Manas-36/MINESAFE/docs/report/README.md

# Reports

| File | What |
|---|---|
| [MineSafe_Blue_Book.pdf](MineSafe_Blue_Book.pdf) · [.docx](MineSafe_Blue_Book.docx) | Project Report Part I (TCET blue-book format), written early Oct 2026 — describes the system as it was then (V3 with the camera entry station); later changes are in the [CHANGELOG](../../CHANGELOG.md) |
| [figures/](figures/) | Diagrams and screenshots used in the report: architecture, DFD level 0 / 1, use case, state diagram, process model, Gantt chart, flowcharts, alert sequence, schematics |

The presentation was made in Claude Slides (export PDF / PPTX from its Share menu) — see [../presentation](../presentation/README.md).
