Manas-36/MINESAFE/docs/presentation/README.md

# Presentation

22-slide deck (12–15 minutes) made in Claude Slides — export it as PDF / PPTX from the deck's Share menu and add the file here.

| # | Slide | Section |
|---|---|---|
| 1 | MineSafe — title | |
| 2 | Underground, a miner is out of sight, out of reach and unchecked | Problem |
| 3 | Why the mine needs this system | Need & justification |
| 4 | Today's tools each solve one piece | Existing gap |
| 5 | Check at the gate. Watch underground. Warn instantly. | Our solution |
| 6 | System architecture | Overview |
| 7 | A worker's shift, step by step | Process flow |
| 8 | A working demo for about ₹6,700 | BOM |
| 9 | What the miner wears | Technical |
| 10 | Wiring: one I2C bus plus four single pins | Technical |
| 11 | A radio chain that builds itself | Technical |
| 12 | One 54-byte packet per second per worker | Technical |
| 13 | Steps, turns and check-points put the dot on the map | Technical |
| 14 | How danger is recognised | Technical |
| 15 | Two independent checks before anyone goes down | Technical |
| 16 | Every worker, live on the tunnel map | Software |
| 17 | Gas per node, health card per worker | Software |
| 18 | What is new in MineSafe | Innovation |
| 19 | Who benefits, and how | Usefulness |
| 20 | Knowing when kit comes off underground | Extension |
| 21 | Where MineSafe goes next | Future scope |
| 22 | Thank you — questions and live demo | |

**v3.1 update (4 Oct 2026):** AHT air sensor added — slide 6 (hub box), 8 (BOM: AHT20 ₹120 per repeater, total ≈ ₹6,730), 11 (repeater bullet + wiring line), 14 (Gas + air card, wet-bulb limits), 16 (Gas & air tab).
