Manas-36/MINESAFE/presentation/avishkar/poster/MineSafe_Avishkar_Poster.pptx

Inter-University Avishkar Research Convention: 2026-27

Category: Engineering & Technology

MineSafe

Intelligent Safety Gear Compliance, Health Monitoring and Navigation System for Underground Miners

METHODOLOGY — ARCHITECTURE AND DATA FLOW

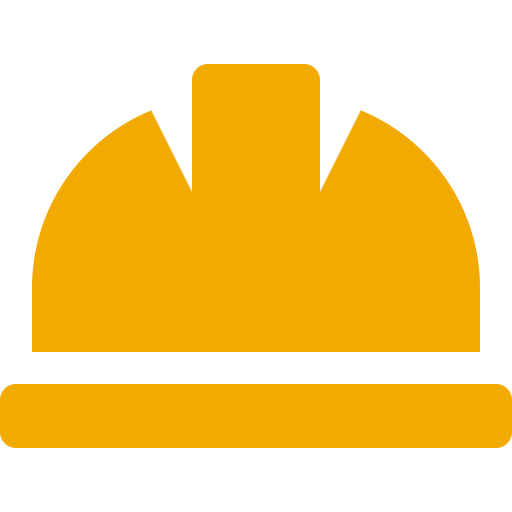
[picture p52: figure]

Level: UG

Slot No.: ____________

No GPS

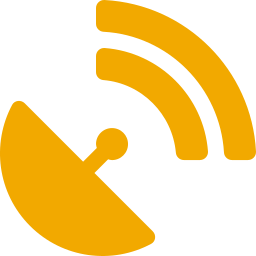
[picture p53: figure]

No internet

No new cabling

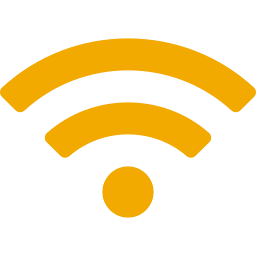
[picture p54: figure]
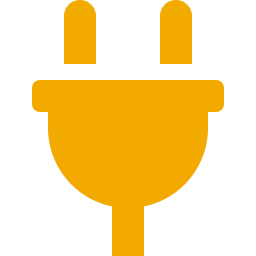
[picture p55: figure]

THE PROBLEM

In every rescue: nobody knows who is underground, where, or whether they are alive.

01

141

deaths, 2023–25

355

serious accidents

OBJECTIVES

Kit compliance

RFID / ID card + YOLOv8 photo check at the gate

Health

heart rate, SpO₂, temperature, falls, no-movement

GPS-free location

steps + heading, corrected at every repeater

Self-healing network

hop-by-hop ESP-NOW, no cabling or internet

Gas and heat

CH₄, CO, H₂S, wet-bulb at every repeater

Low cost

< ₹7,000 / repeater · ≈ ₹12,800 / suit

02

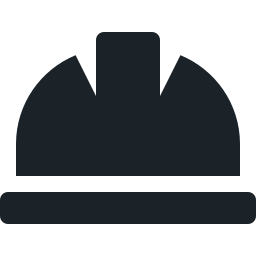
[picture p56: figure]
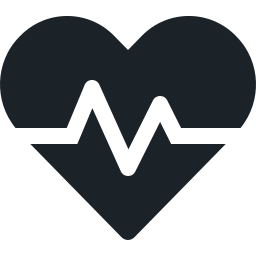
[picture p57: figure]

RESEARCH GAP

System | Kit | Vitals | Fall | Location | Gas | Price
MineGuard 360 | ✗ | ✓ | ~ | ~ | ✓ | quote
MineARC GuardIAN | ✗ | ✗ | ~ | zone | ✓ | quote
Leantegra UWB | ✗ | ✗ | ✗ | ✓ | ✓ | quote
Rajant Health | tag | ✓ | ✓ | ~ | ~ | quote
SmartKavach | ✗ | ~ | ✓ | ✗ | ✗ | quote
36Zero + Bodytrak | ~ | ✓ | ✓ | ✗ | ✗ | quote
MineSafe | ✓ | ✓ | ✓ | ✓ | ✓ | ₹12.8k

Novelty: the first low-cost system that combines kit check, vitals and GPS-free location in one self-healing network.

03

0

GPS or phone signal below ground

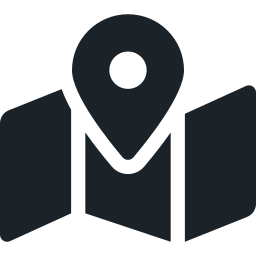
[picture p58: figure]
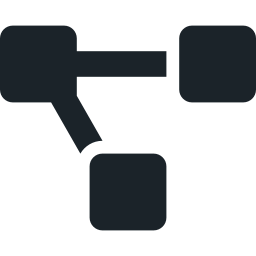
[picture p59: figure]
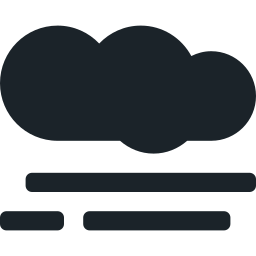
[picture p60: figure]

alerts and evacuation routes return down the same chain · 1 packet / s per worker · data stays on site, no cloud

04

ESP-NOW

ESP-NOW

ESP-NOW

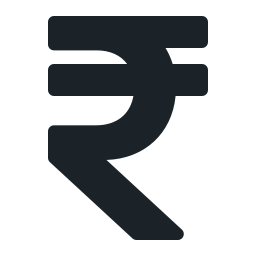
[picture p61: figure]

Wi-Fi

Wi-Fi

V4 SMART SUIT

Never locked: removal is detected, never prevented

05

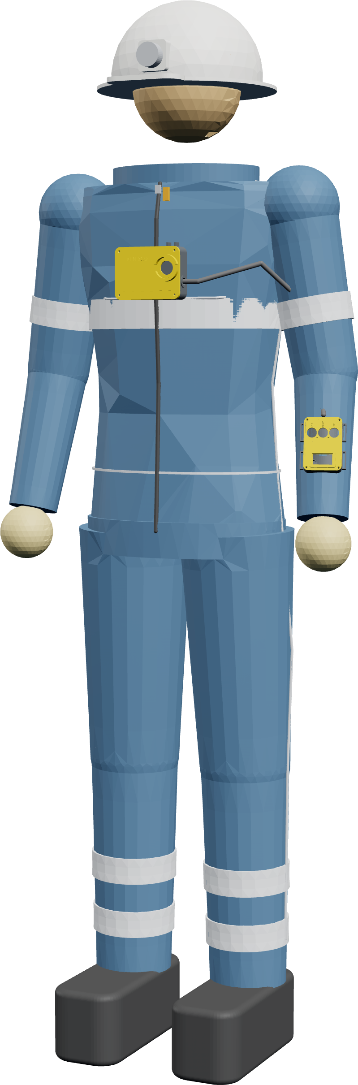
[picture p62: figure]
Smart suit 3D render

Smart suit

4 pods: vitals, fall, kit, steps

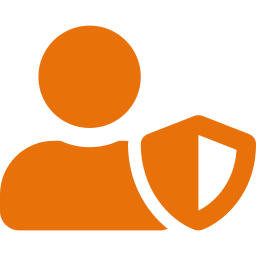
[picture p63: figure]

REP-03

gas · air · exit sign

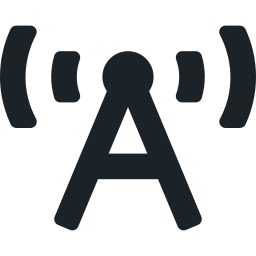
[picture p64: figure]

REP-02

gas · air · exit sign

REP-01

main repeater

Hub laptop

API · AI kit check · evacuation planner

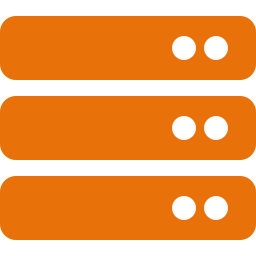
[picture p65: figure]

3D control app

browser or phone, live

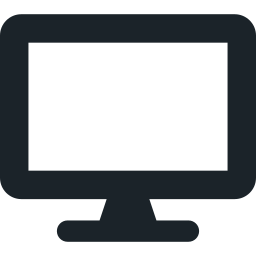
[picture p66: figure]

Helmet pod

antenna at head height, voice alerts, helmet-on switch

Zip + seams

reed switch, conductive thread: opened or torn = alert

Core pod · chest

ESP32-C6, 3000 mAh, IMU + pressure, SOS

Kit up

suit self-checks

WORKER'S SHIFT

no → rejected, fix kit

Entry check

ID card + YOLOv8 photo

Kit OK?

yes

Underground

vitals · steps · gas, every 1 s

Alarm?

yes

Alert + route

exit signs, cuff, helmet voice

Exit scan

dock charges

Boot pod

foot IMU measures every real stride

Wrist cuff

screen, 3 glove buttons, vibration, HR + SpO₂

Reflective bands

hi-vis in cap-lamp light

LOCATION WITHOUT GPS

06

1

Count steps

Evacuation in the 3D control app

no → keep monitoring

07

LED exit sign

REPEATER: BUILT FOR THE MINE

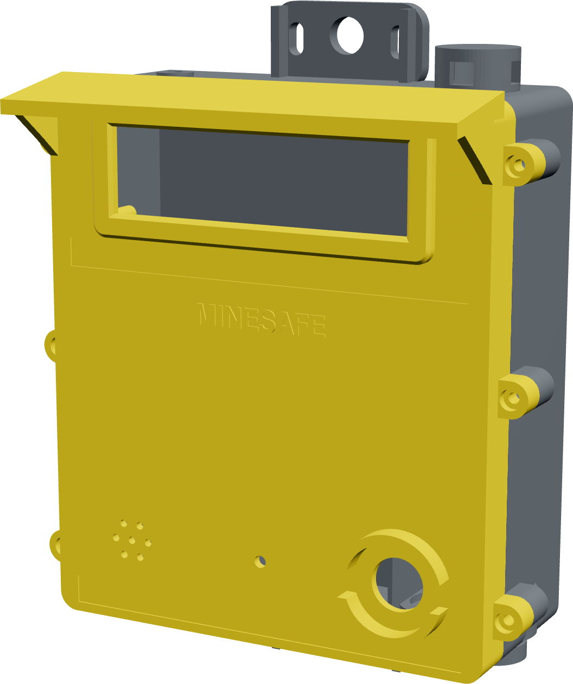
[picture p67: figure]
Repeater enclosure 3D render

CH₄ port on top

08

Mine 9–30 V

ELECTRICAL DESIGN AND PCBS

Diode OR

Fuse + TVS

5 V buck

XIAO · 3 MQ · matrix

2

3

stride × gyro heading; pressure gives the level

Snap to tunnel

position pulled onto the mine-map centre line

Reset at repeater

signal ≥ −55 dBm → drift back to zero

arrow + metres, under a drip hood

85 dB buzzer

works if the hub is down

CO / H₂S below

methane rises; rain chimney

IP65 gasket

silicone cord, 6 × M4

Guarded SOS

Battery 12 V

Repeater PCB

no reset

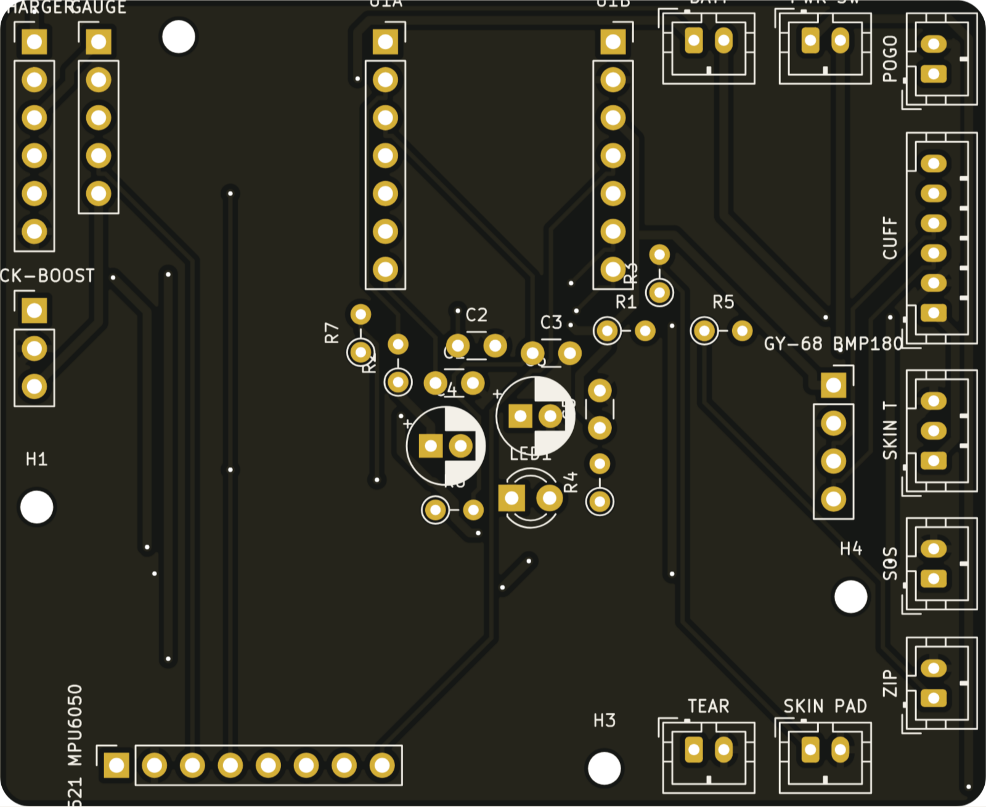
[picture p68: figure]
Core PCB

1.6 A · 36 V

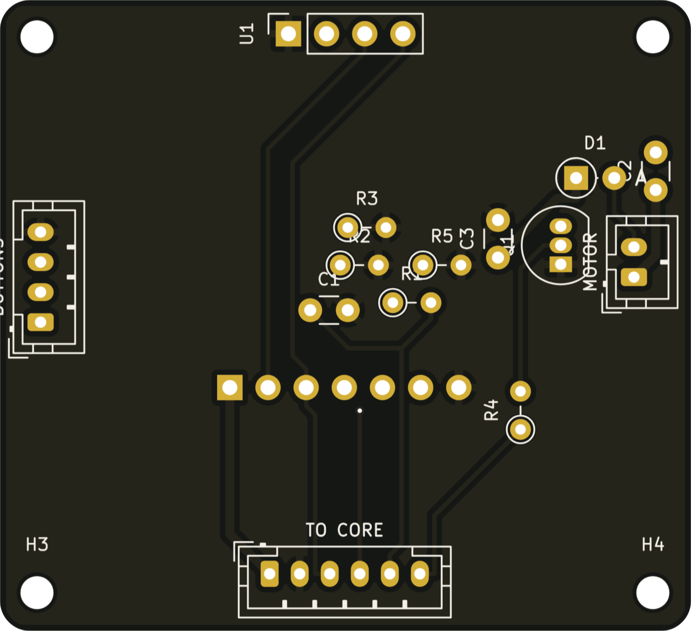
[picture p69: figure]
Cuff PCB

2 A, 90 %

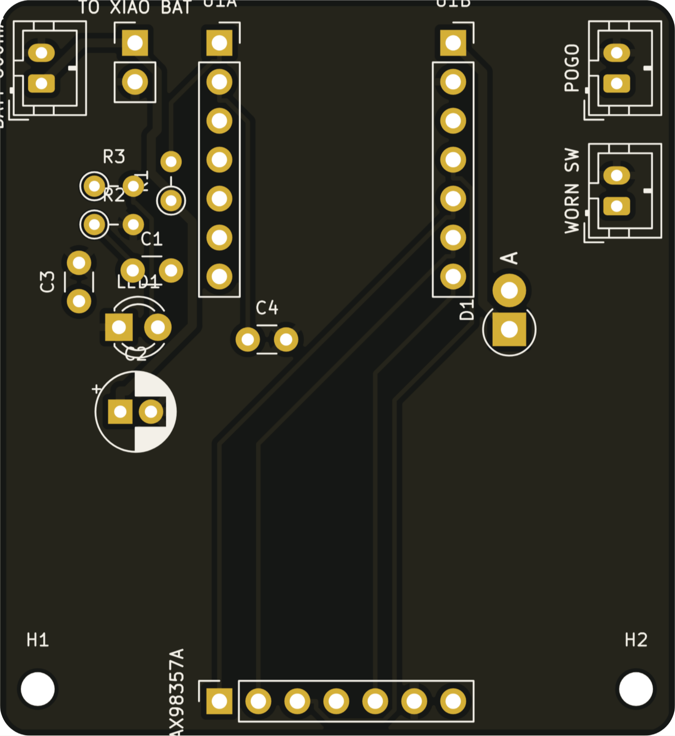
[picture p70: figure]
Helmet PCB

≈ 3.7 W

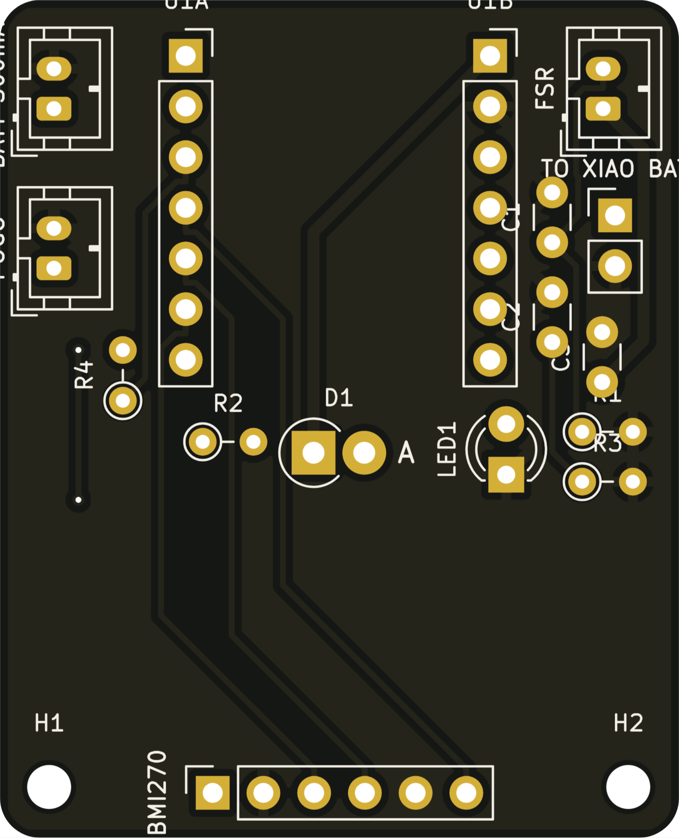
[picture p71: figure]
Boot PCB

09

4

Route around danger

Dijkstra from all exits, hazard zone ×1000 cost

ENERGY BUDGET

Live 3D control app: routes bend around a gas leak, every exit sign updates

10

COST

heavier gases; flame arrestors

11

VALIDATION

glove-sized, knock-proof

Repeater

5 own 2-layer boards · KiCad + Freerouting · 100 % routed · 0 unconnected pads

Core

Cuff

12

Every worker checked, monitored, located and reachable for the whole shift, on hardware a small mine can install itself.

CONCLUSION

Helmet

Boot

₹12.8k
per suit

Boot pod

Fabric + sensing

Core pod

Helmet pod

Wrist cuff

3,270

3,040

2,790

2,260

1,480

Test | Pass criterion | Status
PCB DRC, 5 boards | 0 unconnected pads | Passed
CAD fit, 5 cases | no collisions | Passed
Power budget | core pod ≥ 12 h (21 h) | Passed
Repeater chain | self-forms, 3 / 3 | Passed
Gas + local buzzer | alarm at limit | Passed
Distance error | ≤ 5 % over 100 m | In progress
Alert latency | ≤ 3 s for 95 % | Planned
Fall detection | ≥ 90 %, ≤ 1 false / h | Planned

- Working V3 prototype: 3 repeaters, body unit, hub, 3D app
- V4: 5 PCBs, 5 mine-rated cases, smart suit
- Next: LoRa backbone, certified gas sensors, mine trial

References [1] Ministry of Mines data, ETV Bharat, Aug 2026 · [2] Coal Mines Regulations 2017, reg. 153 · [3] NIOSH Pocket Guide to Chemical Hazards · [4] Bandyopadhyay et al., Wireless Information and Safety System for Mines, JSIR 2009 · [5] IMU-assisted UWB positioning in underground coal mines, Micromachines 2023 · [6] Real-time PPE compliance detection (YOLO), Sustainability 2023

Hours on one charge; a shift is 12 h. *duty-cycled radio. Repeater ≈ 3.7 W on mine power.

₹6,862 / repeater · ₹3.26 L for 10 repeaters + 20 suits

SDG 3
Good health

SDG 8
Decent work

SDG 9
Industry
