Manas-36/MINESAFE/presentation/avishkar/MineSafe_Avishkar.pptx

MineSafe

Intelligent Safety Gear Compliance, Health Monitoring and Navigation System for Underground Miners

Checked at the gate · monitored all shift · located without GPS · reachable in seconds


No GPS


No internet


No new cabling


Notes: 0:00–0:15. Say the slot number only — never your name or college. The suit on the right is a live 3D model: click and drag to turn it.

## Underground, nobody knows who is where — or if they are alive

141

deaths, 2023–25

SLBC tunnel, Telangana · 2025

8 trapped — ground radar needed to find them

Umrangso, Assam · 2025

flooded mine, 150+ hour search

355

serious accidents

Kolihan, Rajasthan · 2024

cage rope snapped, 15 trapped, 1 died

0

GPS or phone signal underground

Ksan, Meghalaya · 2018

15 trapped, about 80-day search

Notes: 0:15–0:45. Source: Ministry of Mines data (ETV Bharat, Aug 2026). Every rescue shows the same gap: no last known position, no vitals, no way to tell each worker which way to go.

## No existing system combines kit check, vitals and GPS-free location

Product | Kit check | Vitals | Fall alert | GPS-free location | Gas | Public price
Teknovate MineGuard 360 | ✗ | ✓ | ~ | ~ | ✓ | quote only
MineARC GuardIAN | ✗ | ✗ | ~ | zone | ✓ | quote only
Leantegra (UWB) | ✗ | ✗ | ✗ | ✓ | ✓ | quote only
Rajant Health | tag | ✓ | ✓ | ~ | ~ | quote only
EasyM2M SmartKavach | ✗ | ~ | ✓ | ✗ | ✗ | quote only
36Zero + Bodytrak | ~ | ✓ | ✓ | ✗ | ✗ | quote only
MineSafe | ✓ | ✓ | ✓ | ✓ | ✓ | ₹6.9k / ₹12.8k

What is new: one integrated network · location without GPS or new infrastructure · repeaters that are also exit signs · a suit that checks the kit all shift · small-mine price

Notes: 0:45–1:10. Nine commercial products checked (July 2026). Do not claim to beat Leantegra on positioning — the point is the integration and the cost.

## Methodology: one self-healing network from the gate to the control room

ESP-NOW

ESP-NOW

ESP-NOW

Wi-Fi

Wi-Fi

Smart suit

4 pods: vitals, fall, kit, steps


REP-03

gas · air · exit sign


REP-02

gas · air · exit sign

REP-01

main repeater

Hub laptop

API · AI kit check · evacuation planner


3D control app

browser or phone


WORKER'S SHIFT

alerts and evacuation routes return down the same chain · data stays on site

Kit up

suit self-checks

Entry check

ID card + YOLOv8 photo

Kit OK?

yes

Underground

vitals · steps · gas, 1 / s

Alarm?

yes

Alert + route

exit signs, cuff, voice

Exit scan

dock charges

no → rejected, fix kit

no → keep monitoring

Notes: 1:10–1:45. Top: data flow left to right, alerts come back on the dashed path. Bottom: the worker's shift — the system runs on its own after the gate.

## Location without GPS, evacuation without guesswork

3D control room during an evacuation

Live 3D control app during an evacuation: routes go around the gas leak, exit signs update

Count steps

steps × stride along the gyro heading; pressure gives the level

1

2

Snap to the tunnel

position pulled onto the nearest tunnel on the mine map

3

Reset at repeaters

signal ≥ −55 dBm = next to that repeater: drift goes to zero

4

Route around danger

Dijkstra from all exits; hazard tunnels cost 1000×; each exit sign shows arrow + metres

Notes: 1:45–2:10. Integrating acceleration drifts about 175 m a minute — that is why we count steps and reset at every repeater. V4 adds a foot IMU that measures each real stride.

## Design considerations: dust, water, methane, heat and blasting

Water and dust

IP65 gasket, drip hood, every opening faces down

Methane rises

CH₄ port on top under a rain chimney; H₂S / CO at the bottom

Ignition risk

sintered flame-arrestor seat at every gas port

Heat 30–45 °C

air sensor in its own chamber, away from heaters

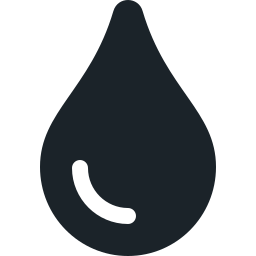
[picture p103: figure]
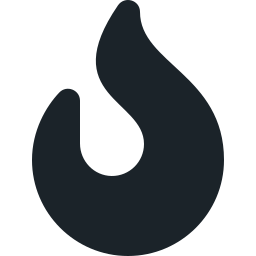
[picture p104: figure]
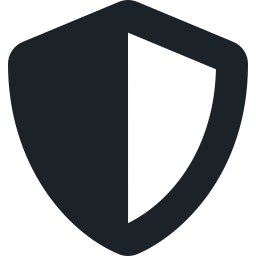
[picture p105: figure]
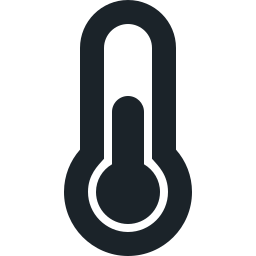
[picture p106: figure]

Blasting shock

screw bosses, latching connectors, rubber grommets

Power cuts

mine supply + battery, switch-over with no reset

Dark and smoke

LED exit signs, reflective hi-vis tape

Thick gloves

16–22 mm buttons, vibration and voice alerts

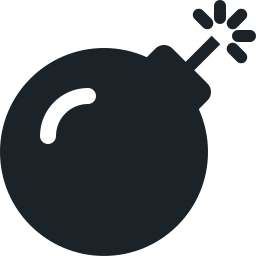
[picture p107: figure]
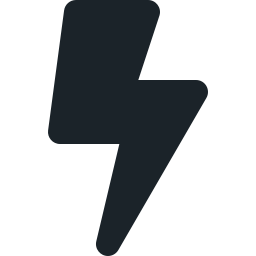
[picture p108: figure]
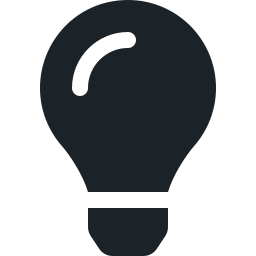
[picture p109: figure]
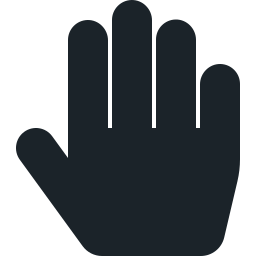
[picture p110: figure]

Notes: 2:10–2:30. Every hardware decision starts from a mine condition. The suit is never locked — removal is detected, never prevented.

## Each repeater is a radio relay, gas station and exit sign

MQ-4 CH₄ (top) · MQ-7 CO · MQ-136 H₂S (bottom), Indian limits

3D model — click and drag to turn it

3D model: Repeater Case - drag to rotate

Gas

temperature, humidity, wet-bulb limit 30.5 / 33.5 °C

Air

8×32 LED matrix: arrow + distance to the safe exit

Exit sign

85 dB buzzer works even if the control room is down

Alarm

9–30 V mine supply or battery, ≈ 3.7 W, ≈ 7 h backup

Power

223 × 292 × 118 mm, IP65 target, rock-bolt / chain mount

Case

Notes: 2:30–3:00. Turn the 3D model to show the CH4 chimney on top and the downward-facing ports. The same board runs as main repeater or tunnel repeater.

## Electrical design: five own PCBs, 100 % routed, 0 errors

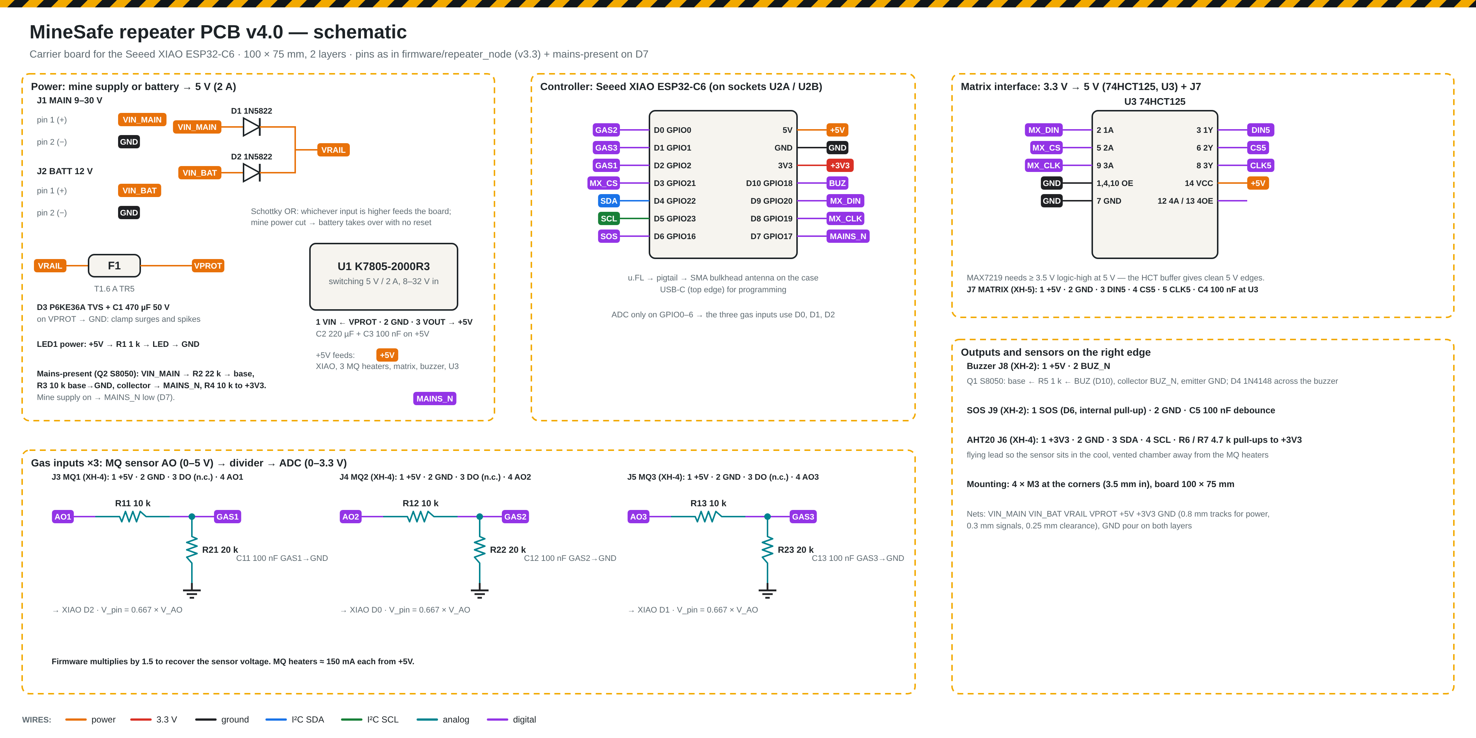
[picture p111: figure]
Repeater PCB schematic

Repeater schematic and board, 100 × 75 mm, 2 layers, through-hole

Repeater PCB top render

KiCad 7 + Freerouting, generated by our own script

Mine 9–30 V

Diode OR

no reset on power cut

Fuse + TVS

1.6 A · 36 V

5 V switcher

2 A, ≈ 90 %

XIAO · 3 MQ · matrix

≈ 3.7 W total

Battery 12 V

Notes: 3:00–3:25. Point at the power path: mine supply and battery are OR-ed by diodes, so a power cut never resets the repeater.

## V4 smart suit: the kit checks itself all shift

Core pod · chest

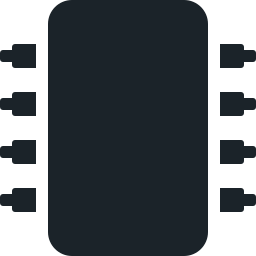
[picture p112: figure]

ESP32-C6, 3000 mAh, motion + pressure, guarded SOS


Helmet pod

antenna at head height, voice alerts, helmet-on switch

Wrist cuff

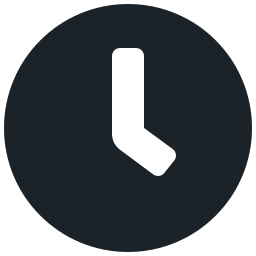
[picture p113: figure]

screen, 3 glove buttons, vibration, heart rate + SpO₂

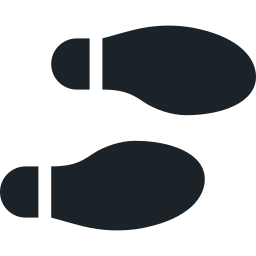
[picture p114: figure]

Boot pod

foot IMU measures each real stride, heel force sensor

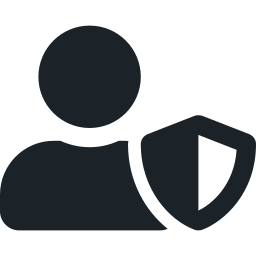
[picture p115: figure]

Seams and zip

Never locked: removal or a tear is detected and reported, never prevented

conductive thread + zip switch: torn or opened = alert

Notes: 3:25–3:50. Turn the suit to show the helmet pod at the back and the boot pod on the right heel. Helmet and boot talk to the core over ESP-NOW; only the cuff is wired.

## Four pods, each designed around its own board

Core pod

118 × 93 × 44 mm · 21 h

Wrist cuff

88 × 75 × 27 mm · wired to core

Helmet pod

75 × 66 × 31 mm · 56 h*

Boot pod

57 × 58 × 29 mm · 92 h*

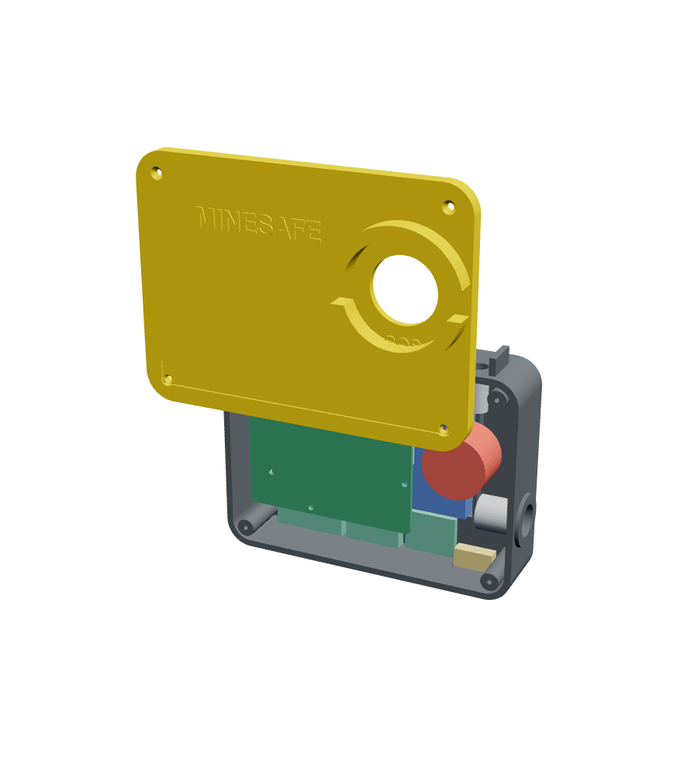
[picture p116: figure]
3D model: Pod Core - drag to rotate
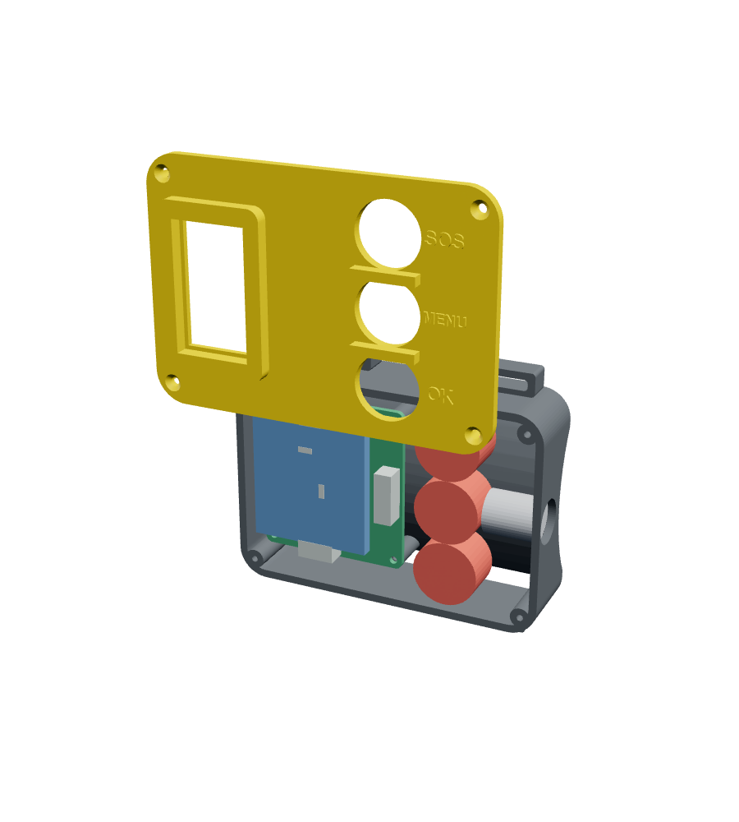
[picture p117: figure]
3D model: Pod Cuff - drag to rotate
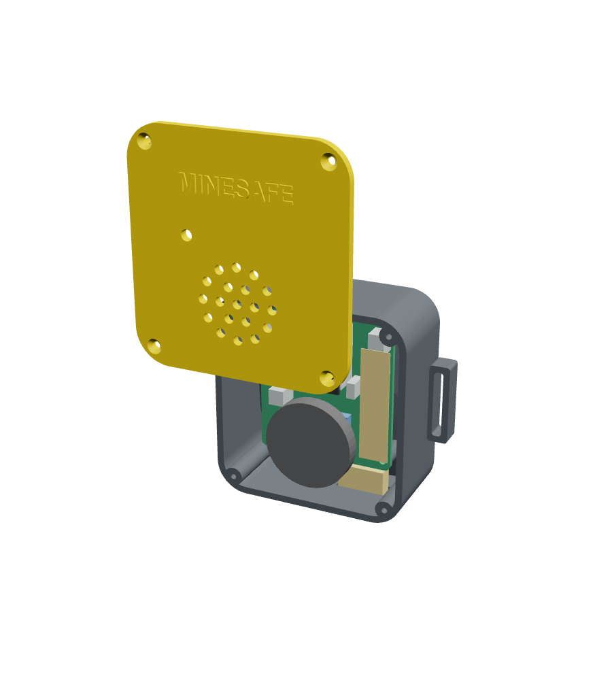
[picture p118: figure]
3D model: Pod Helmet - drag to rotate
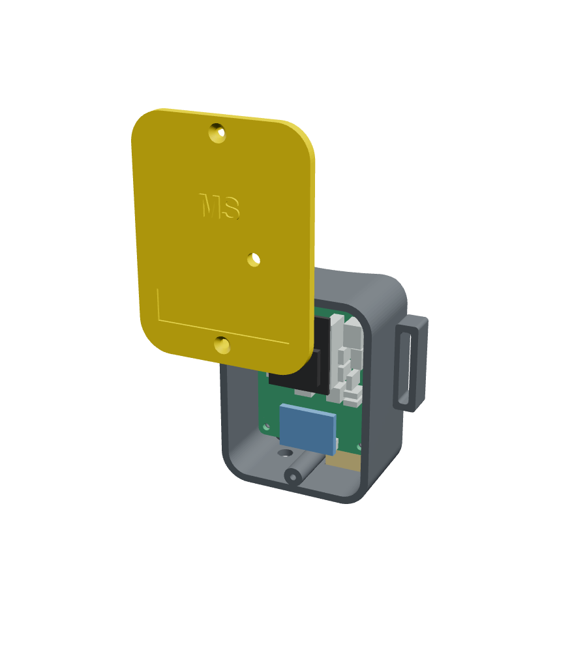
[picture p119: figure]
3D model: Pod Boot - drag to rotate

Lids lifted to show the board, battery and modules · every case fit-checked in CAD against its real KiCad board · *duty-cycled radio

Notes: 3:50–4:05. Turn one pod if time allows. Four pods because each body position does one job best: radio at head height, stride at the foot, screen at the wrist, battery at the chest.

## Energy budget: the core pod lasts almost two shifts

* radio duty-cycled (V4 firmware). Datasheet estimates, to be confirmed by measurement. 10 repeaters ≈ 0.9 kWh / day ≈ ₹7 / day.

Notes: 4:05–4:30. Core pod ≈ 112 mA at 3.3 V → ≈ 21 h from 3000 mAh. Two-thirds of the repeater's power is the gas-sensor heaters — that is why gas is measured on the repeaters, not on the body.

## Component selection: every choice against an alternative

Function | Chosen | Instead of | Why
Controller | XIAO ESP32-C6 | ESP32-S3, Arduino + radio | 21 mm board; Wi-Fi 6, BLE, Zigbee and ESP-NOW on one chip; ≈ ₹600
Worker ↔ repeater link | ESP-NOW | Zigbee, LoRa | no re-joining for a moving worker; no extra hardware
Location | steps + repeater fixes | UWB (DWM3000) | UWB ≈ ₹2,000 per tag and anchor; steps cost nothing
Kit identity | PN532 NFC / ID card | UHF RFID portal | UHF reader ≈ ₹28,000; PN532 a few hundred rupees
Gas (prototype) | MQ-4 / MQ-7 / MQ-136 | electrochemical, NDIR | ₹150–400 each; hub accepts certified sensors later
Regulator | K7805 switcher | linear 7805 | a linear 7805 would waste ≈ 11 W at 24 V input
Exit sign | MAX7219 8×32 matrix | OLED, e-paper | bright in smoke and darkness; ₹250–350

Notes: 4:30–4:55. Five criteria for every part: works underground, low cost, buyable in India, open library, upgradable to a certified part.

## Validation: design and bench checks done, field tests next

design checks passed

4 / 4

bench tests passed

5 / 6

field tests with numeric pass criteria

13

Test | Method | Pass criterion | Status
PCB electrical rules | KiCad DRC, 5 boards | 0 unconnected pads | Passed
Enclosure fit | CAD collision check, 5 cases | no collisions | Passed
Repeater chain | 3 repeaters, any power-up order | forms by itself, 3 / 3 | Passed
Gas + local buzzer | MQ sensor + gas source | alarm at the set limit | Passed
Distance accuracy | 100 m corridor, 5 walkers | error ≤ 5 % | In progress
Alert latency | 3-hop chain, 50 trials | ≤ 3 s for 95 % | Planned
Fall detection | 20 staged falls + 1 h normal | ≥ 90 %, ≤ 1 false / h | Planned
Water / shock | hose 30 min, 1 m drop, 45 °C | no water, no reset | Planned

Notes: 4:55–5:35. Be honest: V3 is in field calibration. Each field test has a numeric pass criterion; results are logged with screenshots and video.

## Affordable for small mines: checked, located, reachable

per repeater

₹6,862

per smart suit

₹12,800

site: 10 repeaters + 20 suits

Every commercial system: enterprise quote only

Next: LoRa backbone · certified gas sensors · intrinsic-safety design · field trial with a mine

₹3.26 L

SDG 3
Good health

SDG 8
Decent work

SDG 9
Industry, innovation

Thank you

Notes: 5:35–6:20. End on cost and impact (20 of 100 marks are economic efficiency and social relevance). Stop by 6:45 — over 7:15 disqualifies.
