Manas-36/MINESAFE/docs/research/source/Competitive_Product_Analysis_Mining_Safety.docx

Competitive Product Analysis Report

Connected-Worker & Smart Mining Safety Products vs. the Proposed Intelligent Safety Gear Compliance, Health Monitoring, and Navigation System for Miners

Nine commercial products were researched directly from vendor sources to assess feature overlap, identify what each does and does not cover, and pinpoint the specific gaps your capstone project should target as differentiation.

Prepared for: Manas | Final-Year B.E. Mechatronics Engineering, TCET Mumbai

Compiled July 2026

# Executive Summary

All nine products in the list are real, currently marketed connected-worker/IoT safety solutions, verified directly against vendor websites in July 2026. They cluster into three groups: (1) mining-specific personnel-tracking and environmental-monitoring platforms (MineARC GuardIAN, Leantegra, ANTAR IoT), (2) general industrial connected-worker wearable platforms adapted to mining/heavy industry (Rajant Health, 36Zero, Jarsh Safety), and (3) broader IoT safety dashboards that mention mining as one of several verticals (Teknovate MineGuard 360, EasyM2M SmartKavach). None of the nine combines AI-based computer-vision PPE compliance verification with continuous physiological health monitoring and sub-metre GPS-denied localization in a single field-proven underground mining product — this is the central, defensible gap your project occupies.

# 1. Product Profiles (Verified from Vendor Sources)

## 1.1 Teknovate MineGuard 360

Teknovate is a Hyderabad-based IoT company whose MineGuard 360 product is one of several vertical offerings (alongside smart water, sugar-mill, and industrial automation systems) rather than a mining-only specialist product.

- Confirmed features: wearable IoT-based real-time worker location tracking in shafts/tunnels; gas and air-quality sensors (methane, CO2, oxygen, particulates); geotechnical/seismic monitoring for structural stability; SOS and guided evacuation; environmental compliance logging; equipment health monitoring; AI-based predictive analytics; central command dashboard; LoRa/mesh connectivity for low-network zones; and worker health monitoring (heart rate, fatigue, body temperature).
- Assessment: on paper this is the broadest feature list of all nine products and closest in scope to your proposal — it explicitly claims worker tracking + health + gas + dashboard. However, it is a general enterprise IoT vendor's product page rather than a peer-reviewed or field-validated mining deployment; there is no published accuracy data, no mention of AI-based camera/vision PPE-detection (compliance appears sensor/wearable based, not computer-vision based), and no detail on which localization technology (UWB/BLE/RTLS) underlies its "real-time tracking" claim — a critical omission for GPS-denied accuracy claims.

Source: https://www.teknovate.in/smart-mining

## 1.2 MineARC GuardIAN

MineARC is an established Australian mine-safety equipment manufacturer (refuge chambers, gas detection); GuardIAN is its digital intelligence-network layer.

- Confirmed features: continuous gas monitoring network; smart lighting; personnel tracking via cap-lamp-embedded tracking chips communicating with GuardIAN nodes (SiriUS-LUX cap lamp, Aura-PT handheld 6-gas detector); chamber/refuge monitoring; digital tag-board for shift attendance; navigational guidance to refuge chambers during emergencies.
- Assessment: strong, field-proven underground infrastructure (gas + tracking + refuge integration) but it is node/zone-level tracking via cap lamps rather than continuous sub-metre positioning, and there is no computer-vision PPE compliance feature or dedicated physiological (heart rate/SpO2/ECG) wearable — health is not a stated focus of this specific product line.

Source: https://guardian.minearc.com/

Personnel Tracking detail: https://minearc.com/products/iot-connectivity-infrastructure-software/underground-tracking-nodes/

## 1.3 Leantegra Safe Mining Platform

Leantegra (competitors: Sewio, Inpixon per BounceWatch) is a specialist ATEX-certified UWB/BLE RTLS hardware vendor for underground mines.

- Confirmed features: ATEX-certified UWB and BLE RTLS anchors, tags, and wristbands; Smart Lamp with embedded RTLS module and optional gas sensors; on-vehicle safety/CAS-PDS devices; a Safe Mining web Portal for zone geofencing, SOS/methane alarm acknowledgement, device/personnel database, charge monitoring, and SSRS-based reporting; sub-metre accuracy achievable with as few as one to two RTLS anchors in tunnel/1D scenarios; scales to hundreds of tags per zone.
- Assessment: this is the strongest pure-localization benchmark among the nine — its published sub-metre 1D UWB tunnel tracking is directly comparable to the academic UWB/IMU papers in your literature review. But Leantegra is explicitly a positioning/RTLS and gas-monitoring platform; it has no AI PPE-detection module and no dedicated physiological health-vitals wearable (heart rate/SpO2/ECG) in its product line — health monitoring is out of scope.

Source: https://leantegra.com/

Tunnel UWB RTLS kit detail: https://leantegra.com/kits/tunnel-uwb-rtls-for-underground-mines

## 1.4 HaloTag by Mine Safe Global

Mine Safe Global is a collision-avoidance/proximity-detection specialist; HaloTag is the pedestrian-worn component of its HaloGuard Collision Avoidance System (CAS).

- Confirmed features: ISO 21815-compliant, Level 9 collision-prevention-capable CAS; 360-degree proximity detection between HaloTag-worn pedestrians and machinery (LHDs, roof bolters); automated braking intervention on paired vehicles; integrated cap lamp + wearable tag for detectability; complementary TrackPro fleet tracking and HotWorks thermal-hazard monitoring for smelting.
- Assessment: HaloTag is purpose-built for person-vehicle collision prevention, arguably the single most mature and safety-critical use case among all nine vendors (it is literally designed to intervene and stop machinery). It is not, however, a PPE-compliance, health-monitoring, or general localization/navigation product — proximity to machinery is its only sensing dimension.

Source: https://minesafeglobal.com/collision-prevention-avoidance-systems-mining/

## 1.5 EasyM2M SmartKavach

SmartKavach is a Bengaluru-based wearable primarily marketed for eldercare, women's safety, and disabled/lone-worker use, with mining and industrial workers mentioned as one target segment.

- Confirmed features: wear-phone form factor with 2G/3G SIM for two-way calling; automatic fall detection with audible pre-alert; SOS button for medical/police/caregiver; GPS location relayed via SMS/call/email to contacts; false-vs-true fall-alert discrimination algorithm; live video streaming to a remote doctor in the enterprise variant; vitals-to-cloud EHR integration (via a paired medical device, not built-in continuous sensing); explicitly mentions "location-based miner tracking in underground mines using wireless IoT" as a stated use case.
- Assessment: important nuance — SmartKavach's core, field-tested design is a consumer/eldercare device using GPS and cellular connectivity, both of which do not function reliably underground. Its underground-mining claim is a stated aspiration/use case rather than a demonstrated GPS-denied localization capability, and it has no PPE-detection feature and no continuous heart-rate/SpO2 sensor built into the base wearable itself. This is the weakest fit to underground mining specifically among the nine, despite the similarity in fall-detection and SOS concept.

Source: https://easym2m.in/smartkavach/

Company mining page: https://www.easym2m.in/

## 1.6 Rajant Health (Q-Stat / Kinetic Mesh)

Rajant is an established, MSHA-approved mining connectivity vendor (BreadCrumb Kinetic Mesh, deployed in 300+ mines across 60 countries); Rajant Health/Q-Stat is its newer wearable biosensor line built on that same mesh backbone.

- Confirmed features: Q-Stat modular wearable hub monitoring vital signs, movement, and environmental exposure to flag heat stress, fatigue, falls, sudden inactivity, or hazardous exposure; edge processing with local data buffering and auto-sync if connectivity drops; Kinetic Mesh BreadCrumb nodes providing self-healing, infrastructure-light underground connectivity (proven alternative to leaky-feeder/static Wi-Fi); Cowbell edge-AI compute nodes (Jetson Orin Nano/Raspberry Pi CM5-based) for on-site AI processing; "BlastBlocker"-style low-latency evacuation alerting; stated wearables "verify compliance" alongside vitals.
- Assessment: the strongest overall competitor on communications backbone (mesh networking is genuinely best-in-class and field-proven at scale) and a credible health-vitals wearable. However, published material does not describe a camera/vision-based PPE-detection capability — "verify compliance" appears to mean wearable presence/tag detection rather than AI object detection confirming a helmet, vest, or gloves are actually being worn correctly. No sub-metre UWB-style positioning is claimed; positioning appears to rely on mesh-node proximity rather than dedicated RTLS.

Source: https://rajanthealth.com/

Q-Stat product page: https://rajant.com/products/qstat/

## 1.7 ANTAR IoT Mining Solutions

ANTAR IoT is a Visakhapatnam-based, Startup-India-recognized industrial IoT company offering mining as one of eight named industry verticals alongside aqua, construction, environmental, manufacturing, oil & gas, pharma, and warehousing.

- Confirmed features (mining vertical page): wearable-based worker safety and tracking with hazard detection and emergency-response readiness; equipment health monitoring; environmental monitoring (air quality, temperature, vibration); fleet management with route optimization; cloud-based remote operations dashboard.
- Assessment: this is the most generic/high-level of the nine — the mining page is a short marketing overview with no named hardware components (no specified helmet, sensor part numbers, or localization technology), unlike Teknovate, Leantegra, or MineARC which name specific devices. There is no evidence of AI PPE-vision detection, no described localization accuracy, and no dedicated physiological sensor suite specific to mining. It reads as a horizontal IIoT integrator applying a generic template to the mining vertical rather than a mining-safety specialist.

Source: https://antariot.com/mining-2/

## 1.8 36Zero (formerly with Bodytrak acquisition)

36Zero is a UK-headquartered connected-worker platform deployed at scale on major construction/infrastructure megaprojects (New Murabba, NEOM, HS2), and — notably — announced a definitive agreement to acquire Bodytrak (ATEX-certified in-ear physiological sensors) specifically to accelerate expansion into Mining & Oil and Gas, confirmed on their site as of mid-2026.

- Confirmed features: Budy360 wearable capturing live location and health vitals; Locate360 solar-powered positioning sensor for indoor/outdoor tracking; Data360 analytics dashboard; digital fit-to-work checks; heat-stress and heart-rate real-time alerting; AI-based risk-pattern and near-miss analytics; workforce/labour-cost management fused with safety data; reported at 100,000+ workers monitored across multiple live megaprojects with quantified case-study outcomes (e.g., 91% improvement in HSE incident reporting/response on one project).
- Assessment: 36Zero is the most data-rich and commercially validated of all nine (real published case-study metrics, not just marketing claims), and the Bodytrak acquisition signals it is actively moving into mining specifically as of 2026 — a genuine emerging competitor to track. However, its published feature set is construction/megaproject-oriented; there is no confirmed camera-based AI PPE-detection (its safety-culture claims center on wearable+AI "interventions" and image risk alerts from site cameras generally, not object-level PPE classification), and — prior to the Bodytrak deal closing — it had no confirmed GPS-denied/UWB-style underground positioning technology, since Locate360 is described as a general indoor/outdoor solar sensor rather than an underground-tunnel-specific RTLS.

Source: https://36zero.io/

## 1.9 Jarsh Safety

Jarsh Safety is a Hyderabad-based, Shark-Tank-India-funded (backed by all investors) Indian industrial safety hardware company with a wide product portfolio spanning ATEX zone communication, electrical safety, fall protection, lighting, road safety, and connected-worker monitoring.

- Confirmed features: WorkAlive (connected-worker real-time worksite monitoring/communication, including confined-space camera use for supervisor visibility); ActivCooling helmets (active cooling for heat-stress prevention — their signature, widely-press-covered product); SmartVolt non-contact live-voltage/electrical-hazard detectors; DownAlert (man-down/lone-worker fall detection product, explicitly discussed in their own blog as a future-of-lone-worker-protection tool); JAS 5G ATEX phones for explosive-zone-safe communication; a full separate line of physical fall-protection hardware (harnesses, fall-arrester blocks, fixed-line systems) — largely non-electronic PPE hardware rather than IoT.
- Assessment: Jarsh has real traction (2000+ "lives impacted" claimed, Forbes 30-under-30 recognition, Shark Tank India funding) and the widest single-vendor hardware catalogue of the nine, but it is fundamentally a modular product catalogue (buy the cooling helmet, buy the voltage detector, buy the fall-arrester separately) rather than one integrated PPE+health+navigation system. There is no confirmed AI computer-vision PPE-compliance detection, and DownAlert/WorkAlive are general lone-worker/confined-space products, not underground-mining-specific localization systems with published GPS-denied accuracy data.

Source: https://jarshsafety.com/

# 2. Comparative Feature Matrix

Ratings are based only on features explicitly confirmed on vendor sources as of July 2026 (✓ = confirmed feature, ~ = partial/implied but not detailed, — = not found in published material). This is deliberately conservative: a vendor not stating a capability is treated as absent, even if it might exist in an undisclosed enterprise SKU.

Product | AI Vision PPE Detection | Continuous Vitals (HR/SpO2/Temp) | Fall/Unconscious Detection | GPS-Denied Sub-metre Localization | Gas/Environmental Sensing | Supervisor Dashboard | Underground Mining Focus
Teknovate MineGuard 360 | — | ✓ | ~ | ~ (tech unspecified) | ✓ | ✓ | ~ (one of many verticals)
MineARC GuardIAN | — | — | ~ | ~ (node/zone-level) | ✓ | ✓ | ✓
Leantegra Safe Mining | — | — | — | ✓ (sub-metre UWB) | ✓ (via Smart Lamp) | ✓ | ✓
HaloTag / Mine Safe Global | — | — | — | ~ (proximity only) | — | ~ (fleet-level) | ✓
EasyM2M SmartKavach | — | ~ (paired device) | ✓ | — (GPS/cellular based) | — | ~ | — (general/eldercare)
Rajant Health (Q-Stat) | — | ✓ | ✓ | ~ (mesh-proximity, not RTLS) | ~ (via edge nodes) | ✓ (Cowbell/edge) | ✓
ANTAR IoT Mining | — | ~ | ~ | — (unspecified) | ✓ | ✓ | ~ (generic template)
36Zero + Bodytrak | ~ (image risk alerts, not PPE-specific) | ✓ | ✓ (heat/heart alerts) | — (indoor/outdoor, not underground RTLS) | — | ✓ | ~ (expanding into mining via acquisition)
Jarsh Safety | — | ~ (via WorkAlive) | ✓ (DownAlert) | — | — | ✓ | ~ (general industrial)
Your Proposed System | ✓ (YOLO-based, purpose-built) | ✓ (MAX30102/MLX90614/ECG) | ✓ (IMU-based) | ✓ (UWB+IMU sensor fusion) | ✓ (gas sensor suite) | ✓ (unified) | ✓ (purpose-built for underground mining)

# 3. Gap Analysis — Where Your System Differs

## 3.1 The Single Biggest Gap: No One Combines All Four Pillars

Across all nine verified products, not one publishes evidence of simultaneously offering (a) AI/computer-vision-based PPE compliance detection, (b) continuous multi-parameter physiological health monitoring, (c) sub-metre GPS-denied localization, and (d) a unified real-time supervisor dashboard, purpose-built and validated for underground mining. Each vendor is strong in one or two dimensions and weak or silent on the others:

Dimension | Strongest existing player | What's still missing industry-wide
Localization accuracy | Leantegra (sub-metre UWB, field-deployed) | No vendor pairs sub-metre UWB with an onboard AI PPE-detection camera in the same wearable/checkpoint system
Health vitals | Rajant Health / 36Zero+Bodytrak (multi-parameter, edge-processed) | Neither publishes underground GPS-denied positioning accuracy alongside their vitals claims
Collision/proximity safety | HaloTag (ISO 21815, Level 9 automated braking) | Purely a proximity/collision system — no health or PPE dimension at all
Gas/environment | MineARC, Leantegra, Teknovate | Well-covered industry-wide; not a differentiator, but a necessary baseline your system should still include
AI-based PPE compliance (vision) | None of the nine confirmed | This is the clearest, most defensible white space — your capstone's core AI contribution
Cost-accessible for small/medium mines | None of the nine publish pricing; enterprise sales-led models ("Request a Demo") suggest high entry cost | A low-cost, ESP32/UWB/TensorFlow-Lite-based open architecture is a real differentiator for India's smaller DGMS-regulated mines

## 3.2 Secondary Gaps Worth Noting in Your Report

- Vision-based PPE verification is absent industry-wide in this list: even the most feature-rich vendors (Teknovate, 36Zero) describe general hazard/image alerts, not a trained object-detection model classifying helmet/vest/gloves/boots presence per worker — the exact contribution your YOLO-based module makes (see your literature review, Section 3.2), and directly comparable to the 2025 ScienceDirect improved-YOLOv7 miners'-PPE paper rather than to any commercial product.
- True underground sub-metre localization is rare and siloed: only Leantegra clearly substantiates sub-metre accuracy; MineARC and Rajant rely on zone/node/mesh-proximity location rather than continuous coordinate-level tracking, and SmartKavach's GPS-based approach does not function underground at all — reinforcing that your UWB+IMU sensor-fusion approach (Section 6 of your literature review) targets a technically harder and less-commoditized problem than most competitors have solved.
- Integration of physiological + PPE + location + gas into one wearable is universally absent: every vendor's product line is modular (buy the lamp, buy the vitals wearable, buy the gas sensor, buy the RTLS tag separately) — Jarsh's own product catalogue is the clearest example of this fragmentation, spanning eight separate product families with no single SKU combining more than two or three of PPE/health/location/comms.
- Affordability and openness for small/medium Indian mines: all nine vendors are enterprise/demo-request sales models (global megaprojects, MSHA-regulated large mines, or general industrial clients) with no visible low-cost or open-hardware tier — a real opening for a low-BOM-cost, ESP32/Raspberry-Pi/TensorFlow-Lite academic-to-field-deployable design targeting India's numerous smaller DGMS-regulated mines that cannot afford Rajant- or Leantegra-scale enterprise contracts.
- 36Zero's Bodytrak acquisition is the one live signal that a competitor may close part of this gap soon — worth flagging in your report's "threats/future competitive landscape" framing, since it shows an existing megaproject-scale connected-worker vendor deliberately entering mining/oil & gas physiological monitoring in 2026.

# 4. How Your System Should Be Positioned

Given the above, your capstone's most defensible and differentiated positioning statement is:

"An integrated, low-cost, underground-mining-purpose-built wearable and dashboard system that is the first to combine AI computer-vision PPE compliance detection, continuous multi-parameter physiological monitoring, and sub-metre GPS-denied UWB+IMU localization in a single architecture — addressing a fragmentation gap that persists across all major commercial connected-worker and mining-safety vendors as of 2026."

Recommended framing for your report/presentation:

- Lead with the integration gap (Section 3.1), not a claim that any single sub-feature is technically superior to established players like Leantegra (positioning) or HaloTag (collision avoidance) — those are mature, field-proven systems in their narrow domains.
- Position cost-accessibility and open architecture as a second differentiator, since every reviewed vendor operates on a demo-request, enterprise-sales model with no visible pricing — implying a barrier for India's smaller mines that a low-BOM academic-to-field design can address.
- Acknowledge 36Zero+Bodytrak as the closest emerging competitor and frame your system's advantage as underground-specific engineering (ATEX/UWB/dust-humidity-hardened design) versus their currently construction-megaproject-oriented deployment history.
- Use HaloTag and Leantegra as the technical benchmarks to cite when justifying your collision-avoidance/positioning subsystem design choices, since they are the only two of the nine with concrete, published technical claims (ISO 21815/Level 9; sub-metre 1D UWB) rather than generic marketing language.

# 5. References

Teknovate — MineGuard 360: https://www.teknovate.in/smart-mining

MineARC — GuardIAN overview: https://guardian.minearc.com/

MineARC — Underground Tracking Nodes detail: https://minearc.com/products/iot-connectivity-infrastructure-software/underground-tracking-nodes/

Leantegra — Safe Mining homepage: https://leantegra.com/

Leantegra — Tunnel UWB RTLS kit: https://leantegra.com/kits/tunnel-uwb-rtls-for-underground-mines

Mine Safe Global — Collision Prevention & HaloTag: https://minesafeglobal.com/collision-prevention-avoidance-systems-mining/

EasyM2M — SmartKavach product page: https://easym2m.in/smartkavach/

EasyM2M — Company / mining use case: https://www.easym2m.in/

Rajant Health — Q-Stat wearable: https://rajanthealth.com/

Rajant — Q-Stat product detail: https://rajant.com/products/qstat/

ANTAR IoT — Mining vertical page: https://antariot.com/mining-2/

36Zero — homepage (incl. Bodytrak acquisition announcement): https://36zero.io/

Jarsh Safety — homepage and product portfolio: https://jarshsafety.com/

Note: all nine sources were fetched directly from vendor websites in July 2026 for this analysis. Feature claims reflect what each vendor publicly states; undisclosed enterprise capabilities may exist beyond what is published.
