Manas-36/MINESAFE/docs/website.md

# Control-room website (admin hub)

The website is `hub/admin_hub.py` — one Python file (Flask) that serves every page below. It runs on the laptop, not on the internet: start it with `hub\start_admin.bat` (or `python admin_hub.py`) and open `http://localhost:5000`; phones on the same hotspot use `http://<laptop-ip>:5000` (see [run_on_laptop.md](run_on_laptop.md)).

Screens captured on 13 Oct 2026 (v3.4) with the [demo mine map](../tools/demo_map/), the repeater simulator (`tools/sim_repeater.py … gas`) and three **fictional demo workers**.

## Opening screen
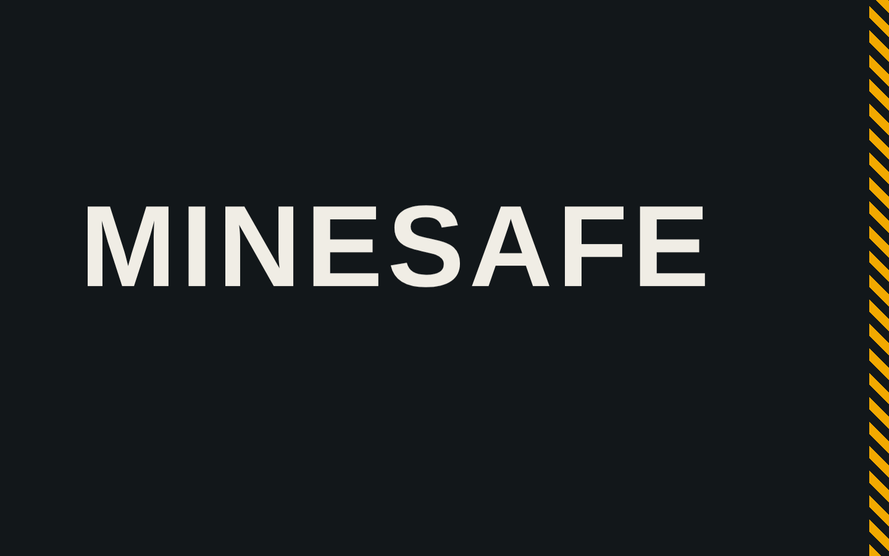
[picture p125: docs/images/website/splash.png]
Splash


## Live — every worker as a card (body temperature, heart rate, signal, alarms)
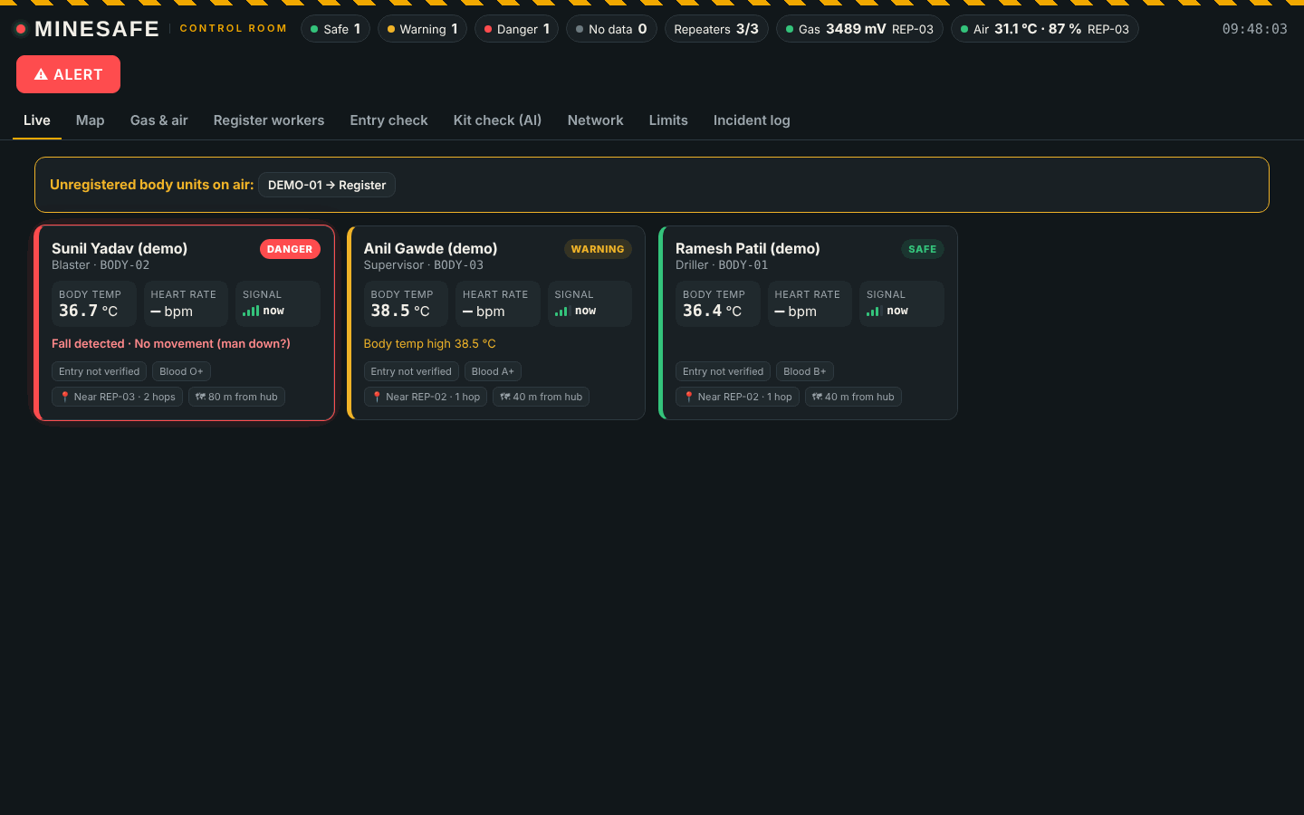
[picture p126: docs/images/website/live.png]
Live


## Map — tunnel plan, workers, repeaters, exits
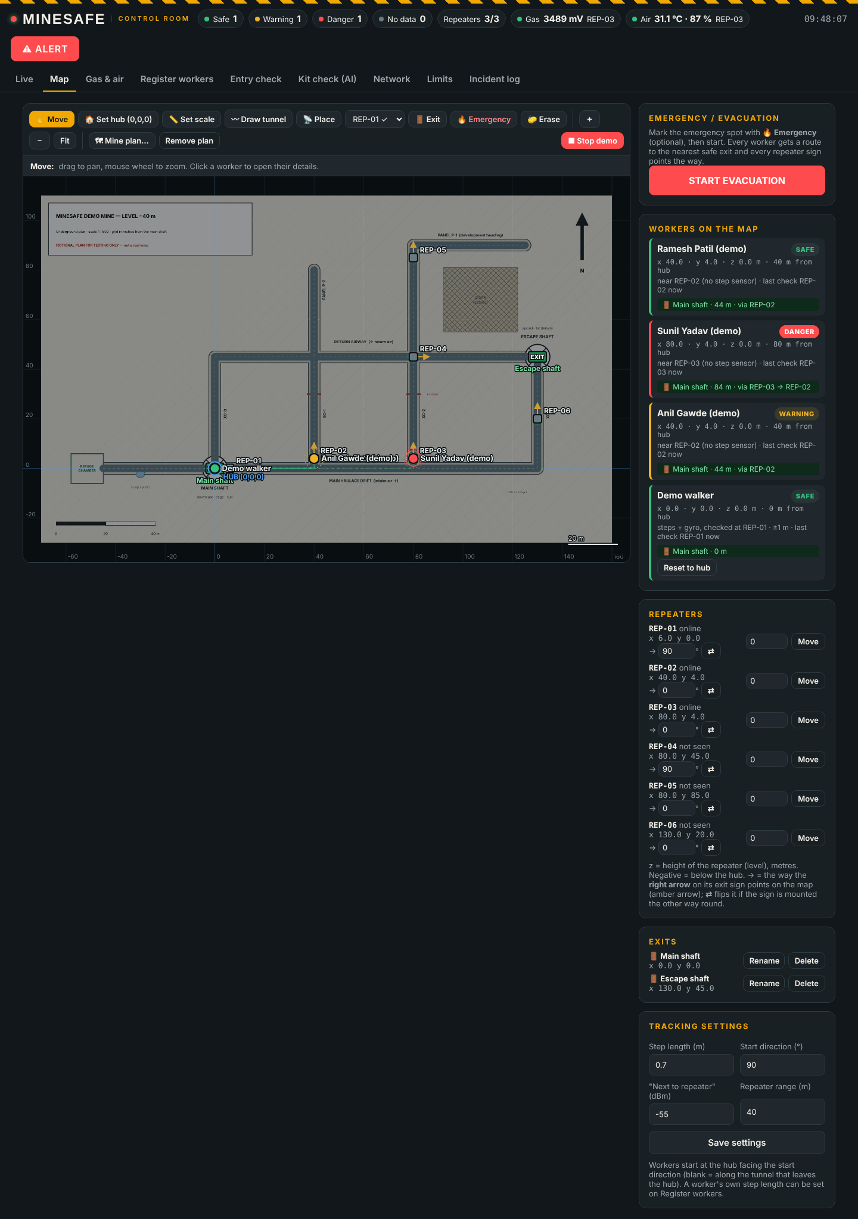
[picture p127: docs/images/website/map.png]
Map


## Evacuation — danger zone, safest route for every worker, arrow + distance on every exit sign
Map during an evacuation

Live during an evacuation

## Gas & air — every MQ channel per repeater, air temperature / humidity / wet-bulb
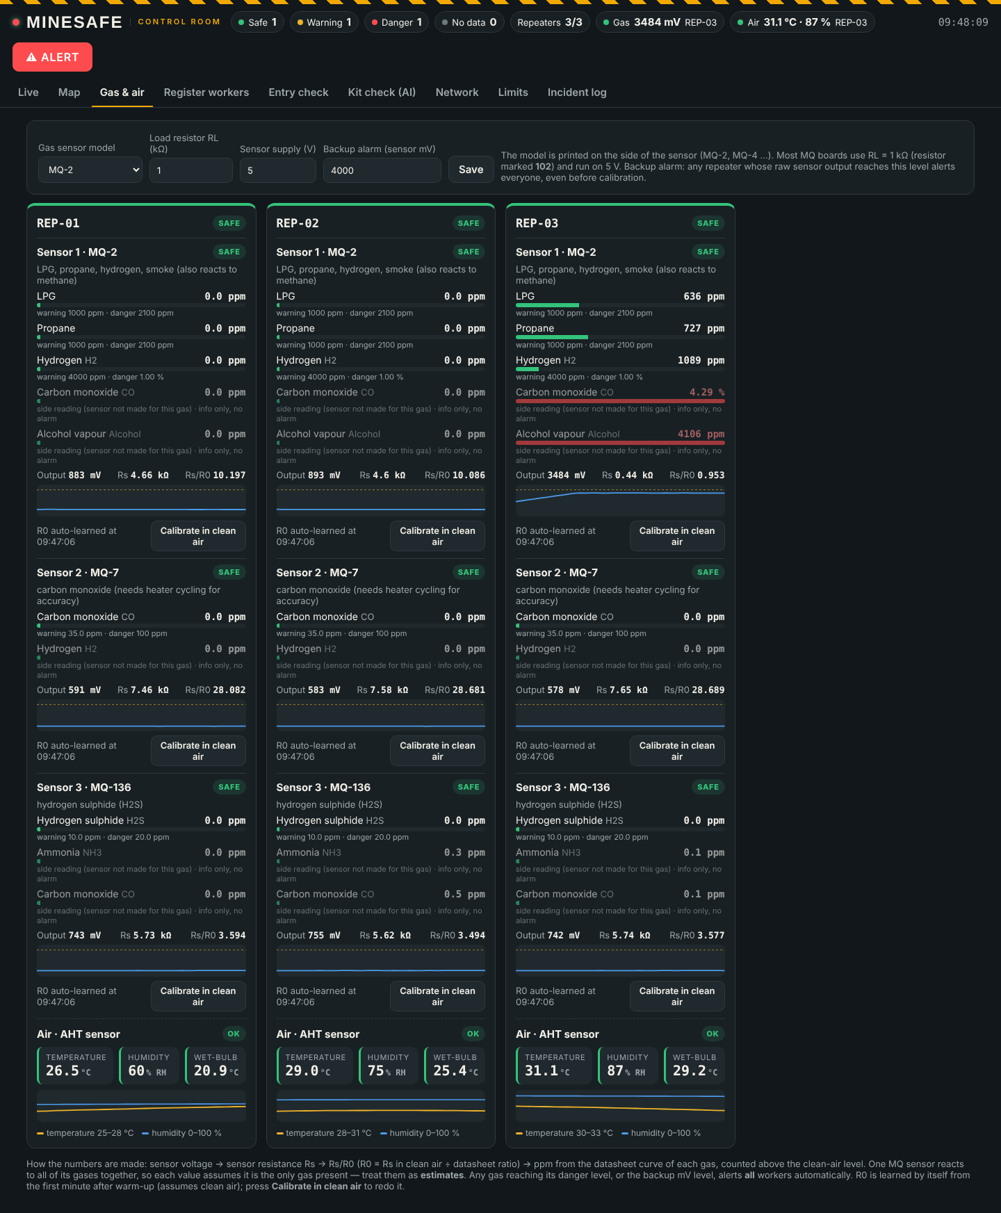
[picture p128: docs/images/website/gas.png]
Gas and air


## Limits — warning / danger / alarm level for every gas (CMR 2017, NIOSH / OSHA)
Limits

## Network — the repeater chain and every body unit's route
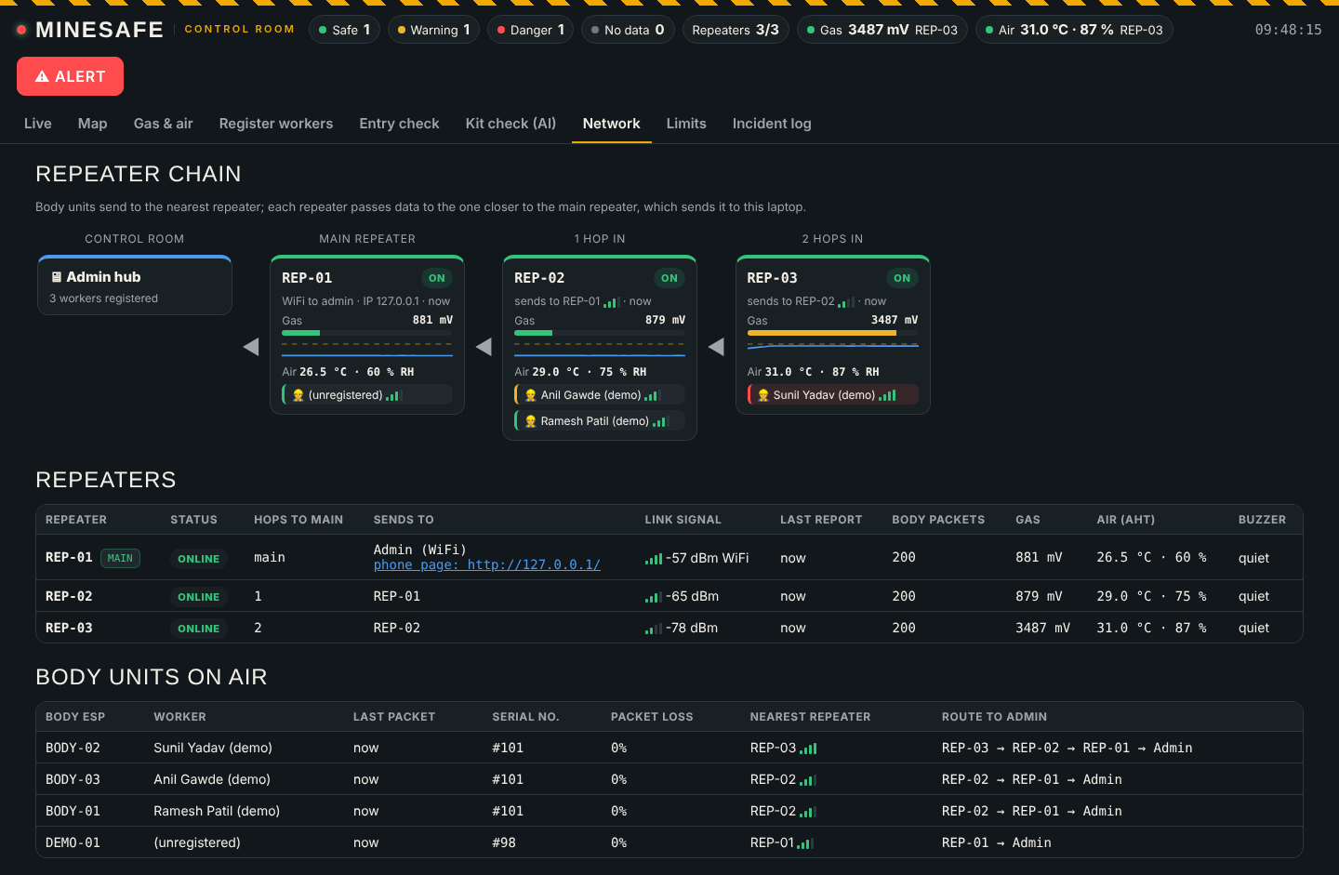
[picture p129: docs/images/website/network.png]
Network


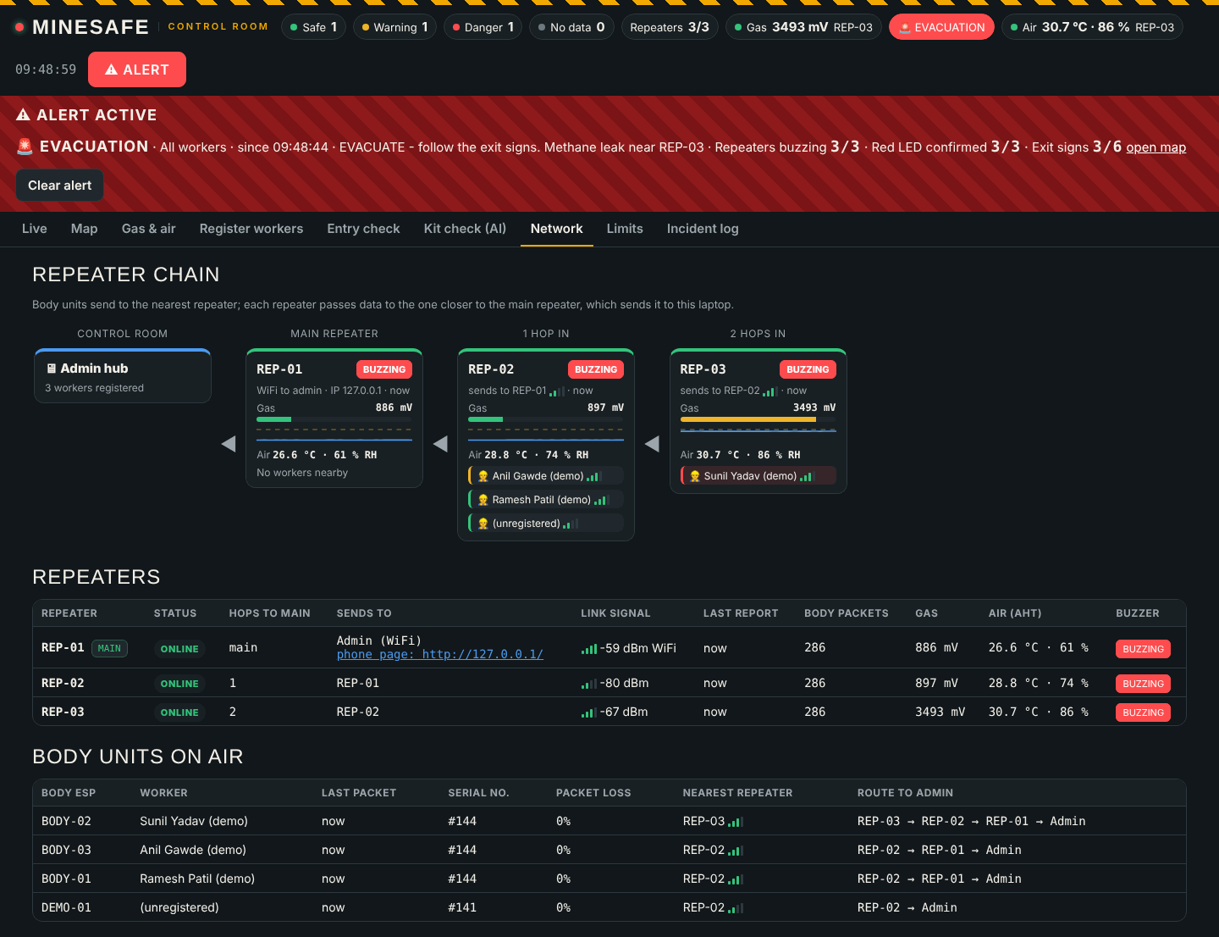
[picture p130: docs/images/website/network_evac.png]
Network during an evacuation


## Register workers
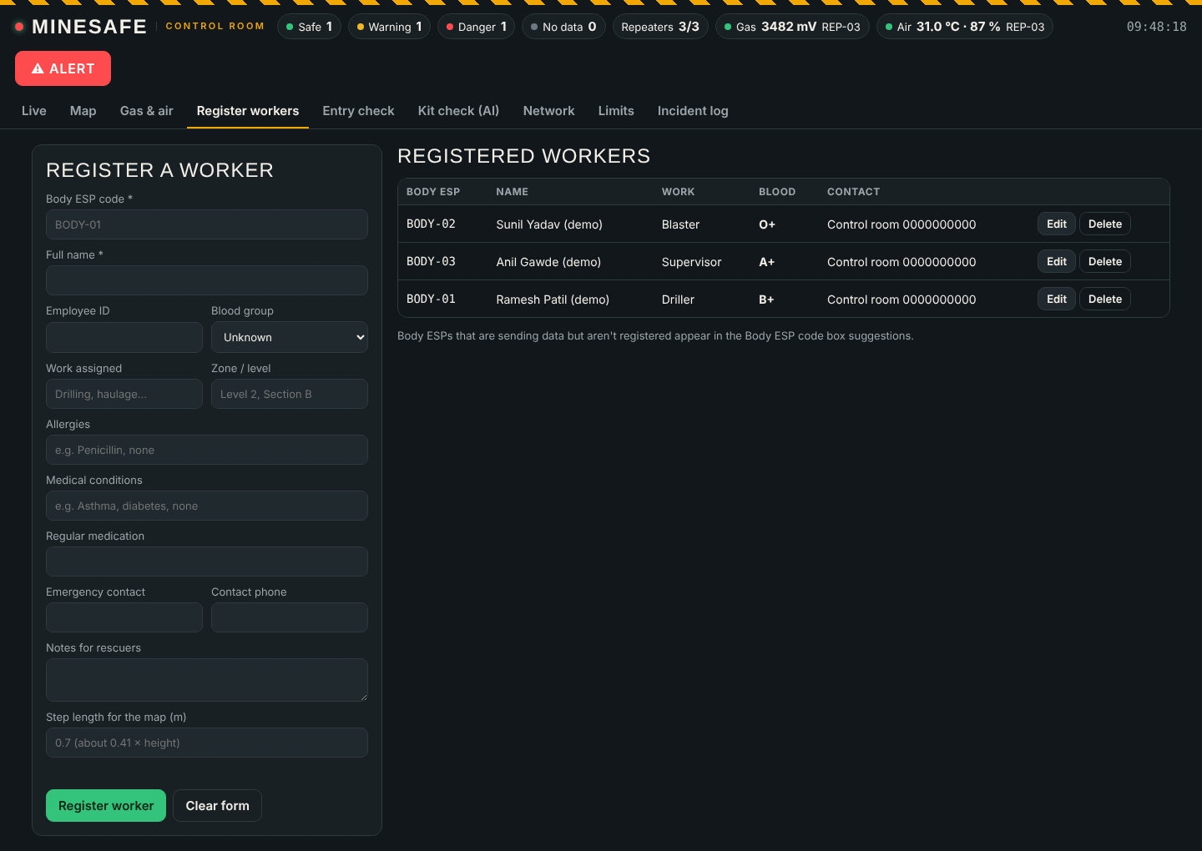
[picture p131: docs/images/website/workers.png]
Workers


## Entry check, kit check (AI) and incident log
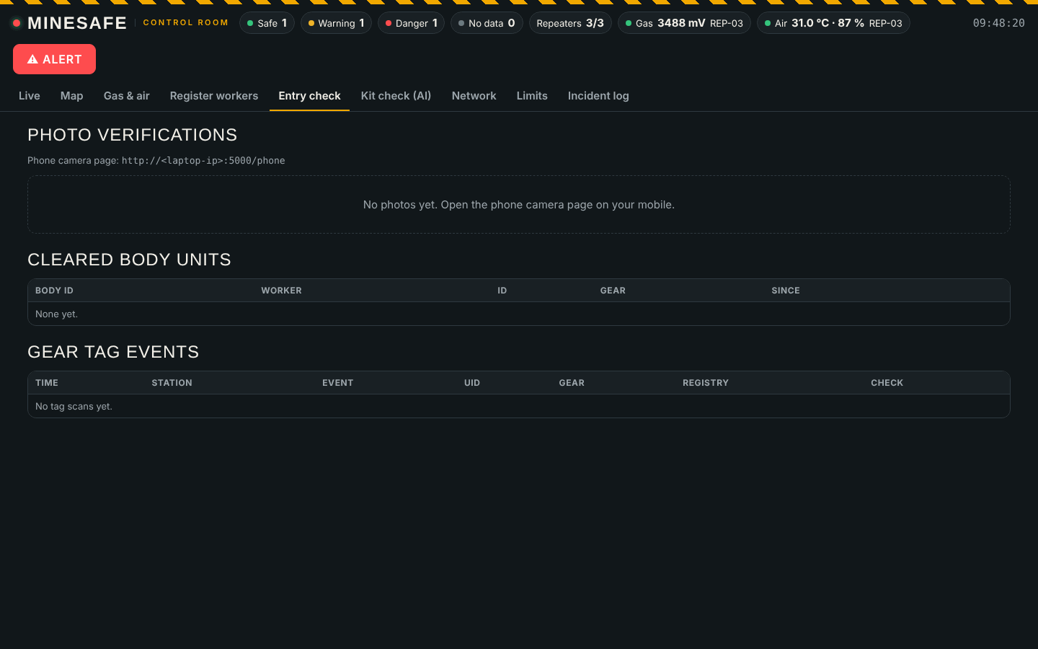
[picture p132: docs/images/website/entry.png]
Entry check


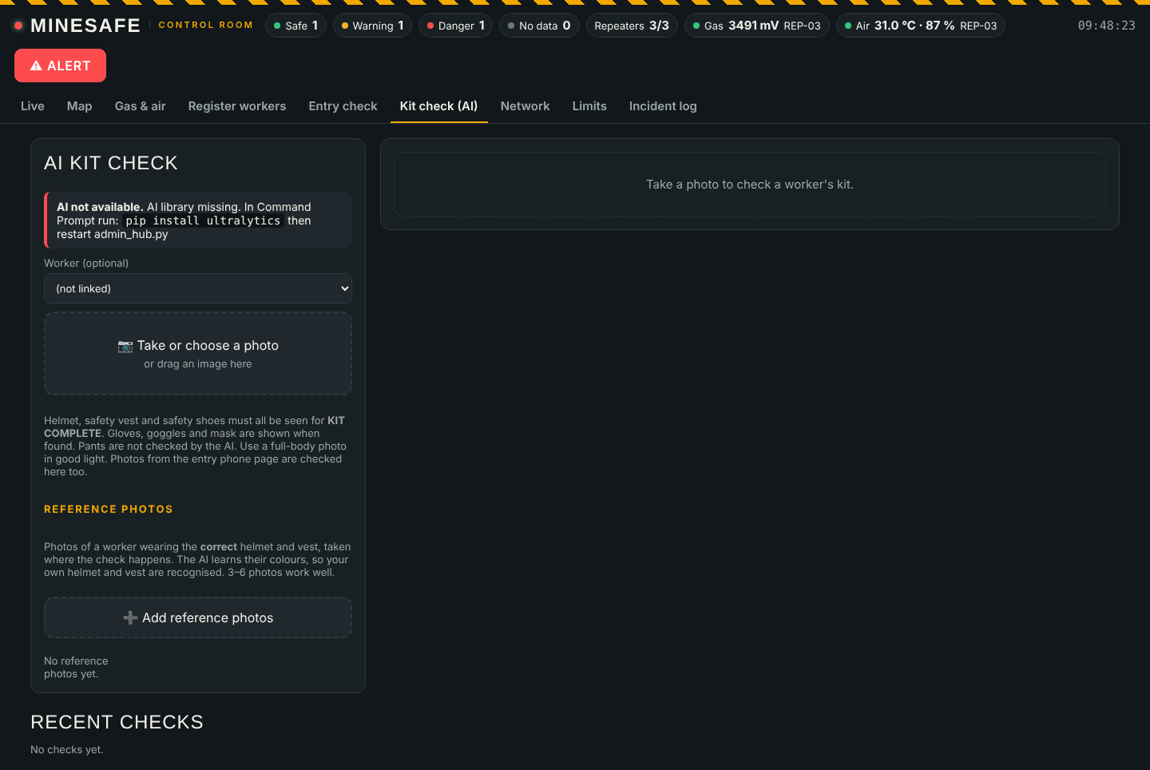
[picture p133: docs/images/website/kit.png]
Kit check


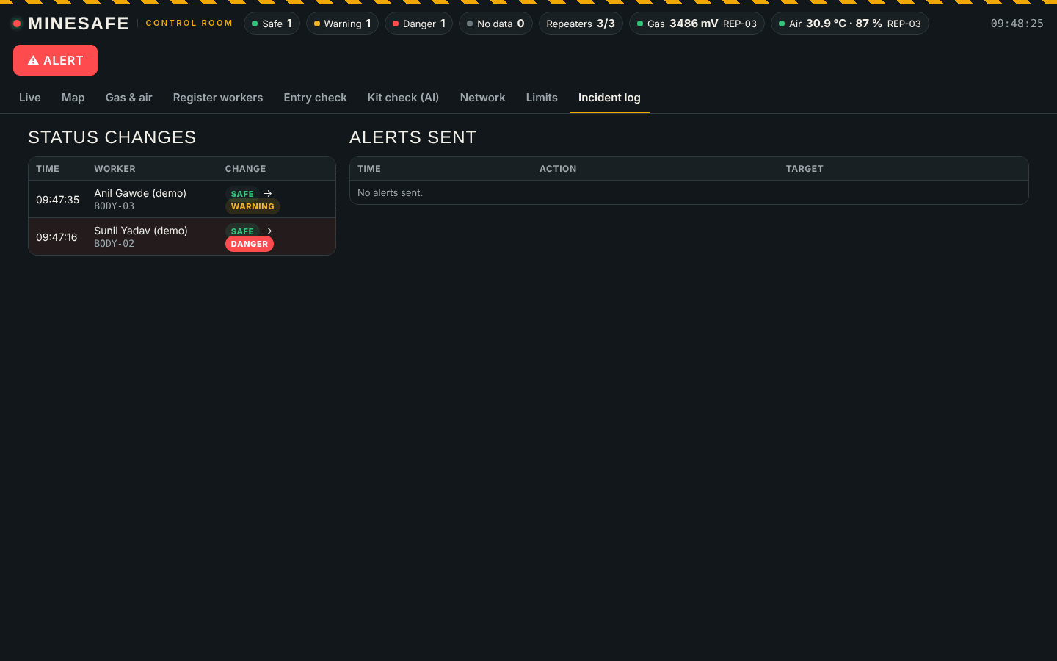
[picture p134: docs/images/website/log.png]
Incident log


## Phone page (`/phone`) — entry photo for the kit check
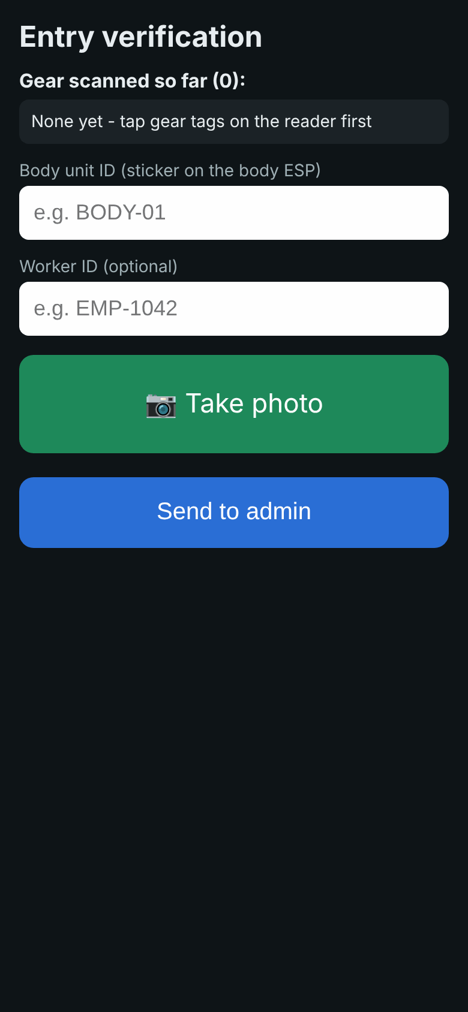
[picture p135: docs/images/website/phone.png]
Phone page


## Body unit display (v3.4)
Body unit OLED screens
