Manas-36/MINESAFE/docs/images/gas.png

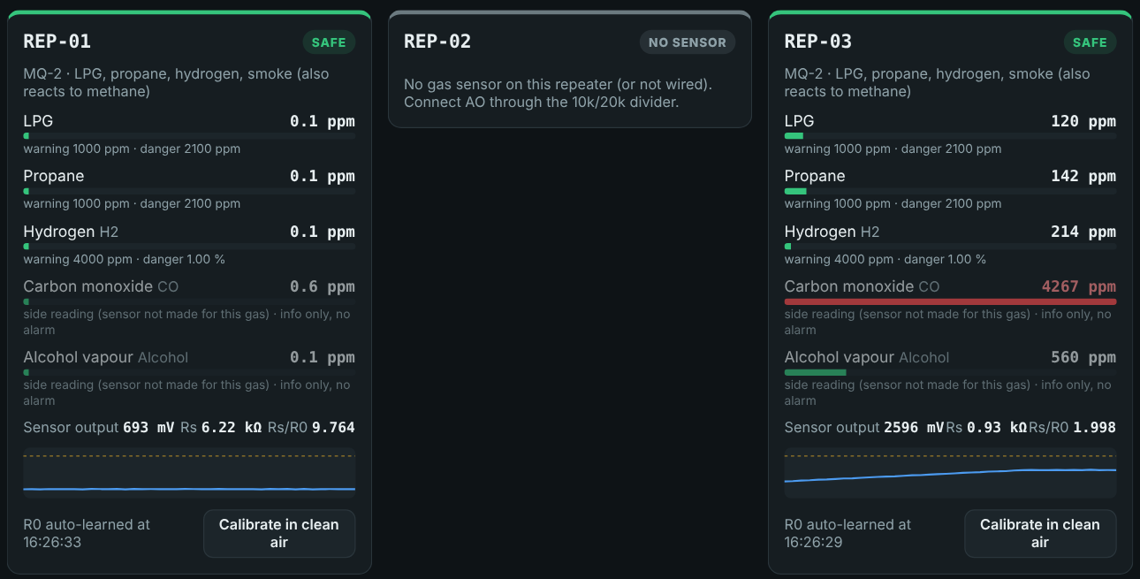
docs/images/gas.png
