Manas-36/MINESAFE/docs/images/live.png

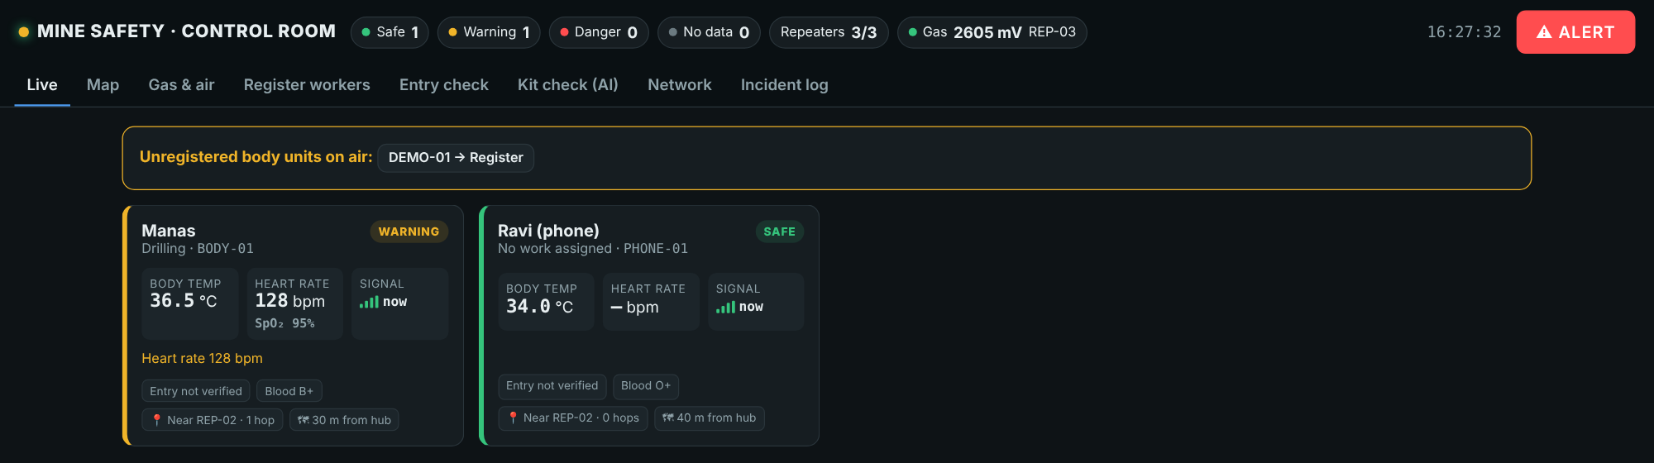
docs/images/live.png
