Manas-36/MINESAFE/docs/images/notion/architecture.png

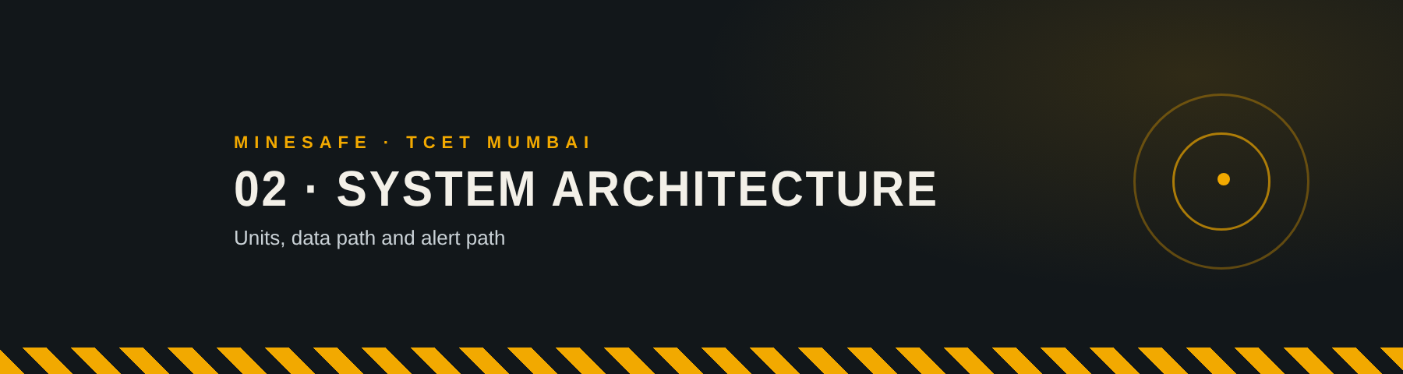
docs/images/notion/architecture.png
