Manas-36/MINESAFE/docs/images/notion/detection.png

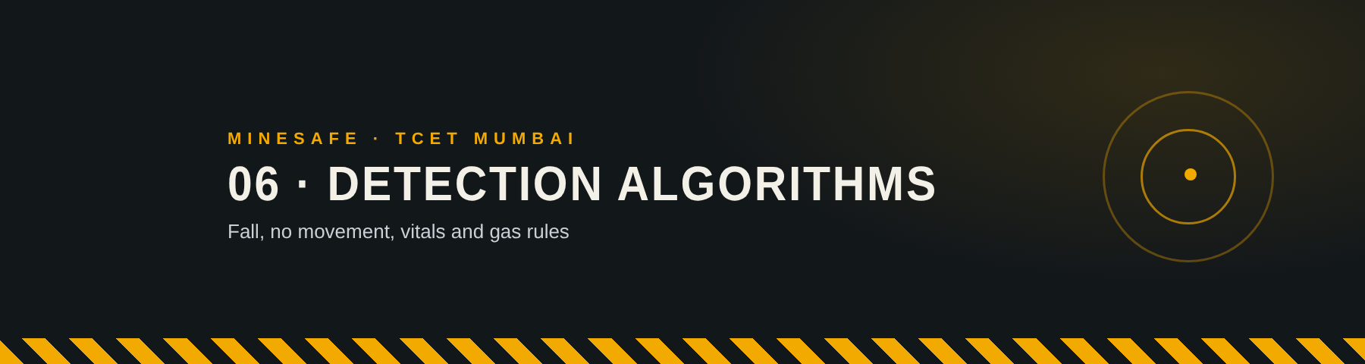
docs/images/notion/detection.png
