Manas-36/MINESAFE/docs/images/notion/home.png

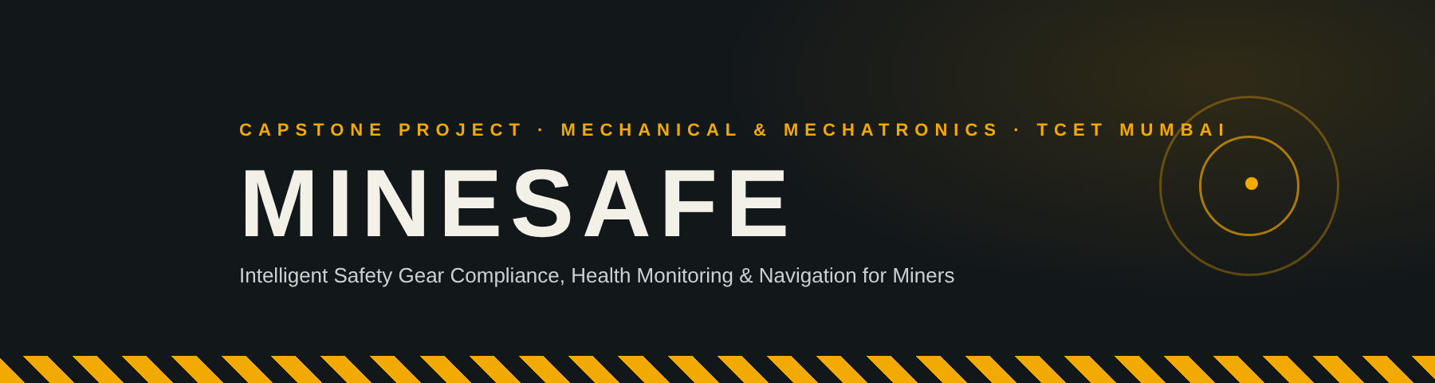
docs/images/notion/home.png
