Manas-36/MINESAFE/docs/images/notion/incidents.png

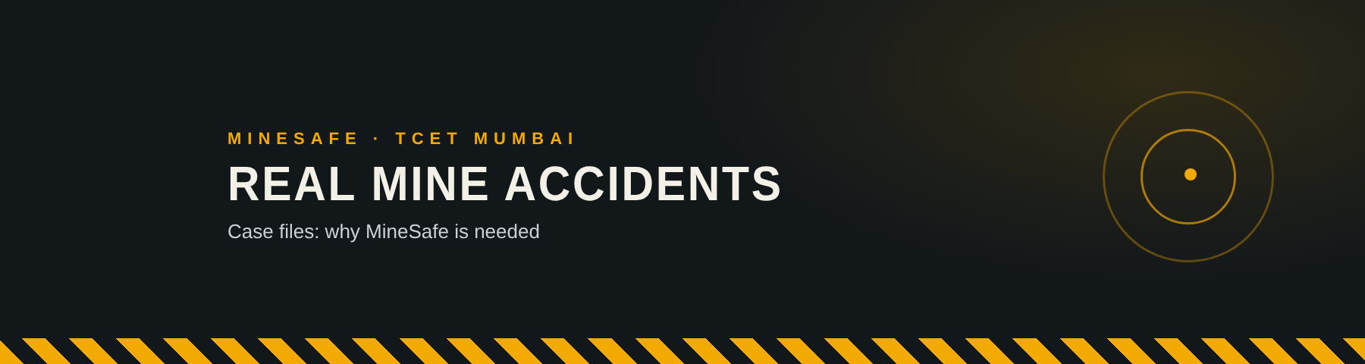
docs/images/notion/incidents.png
