Manas-36/MINESAFE/docs/images/notion/location.png

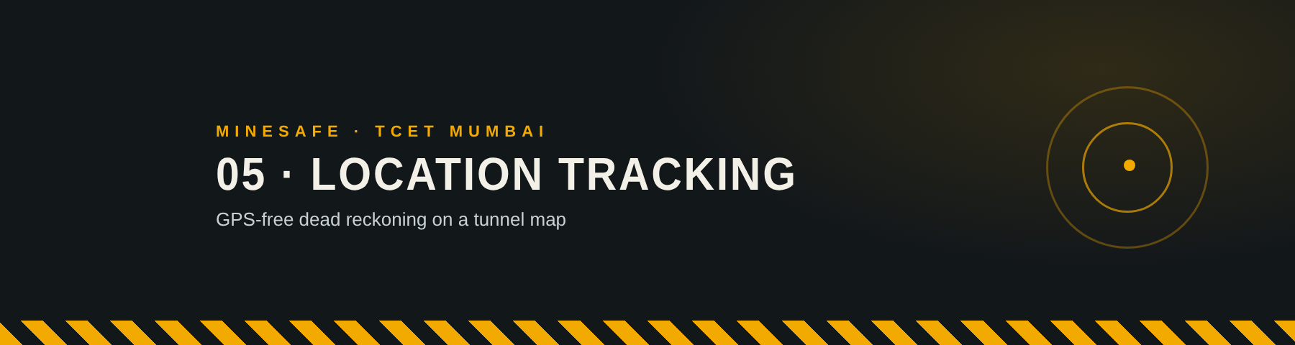
docs/images/notion/location.png
