Manas-36/MINESAFE/docs/images/notion/roadmap.png

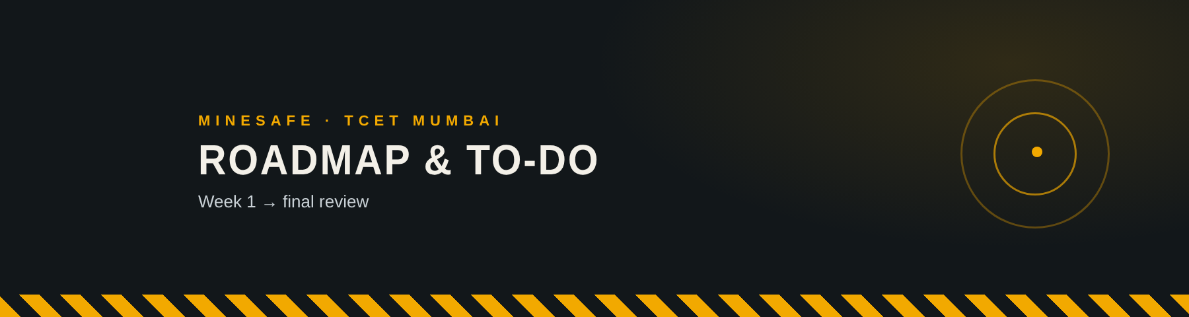
docs/images/notion/roadmap.png
