Manas-36/MINESAFE/docs/images/notion/v1.png

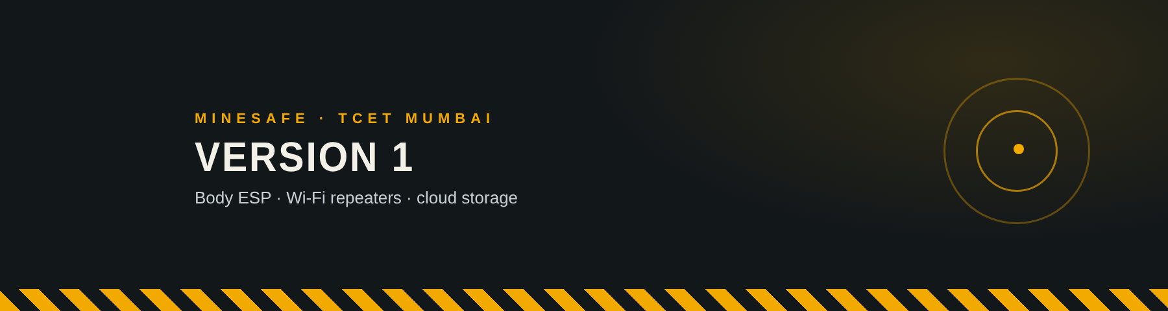
docs/images/notion/v1.png
