Manas-36/MINESAFE/docs/images/worker_panel.png

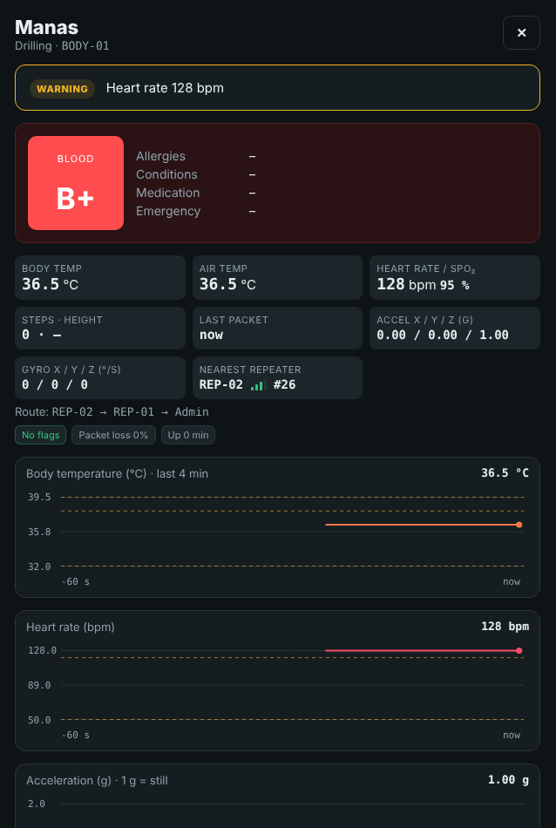
docs/images/worker_panel.png
