Manas-36/MINESAFE/docs/report/figures/map.png

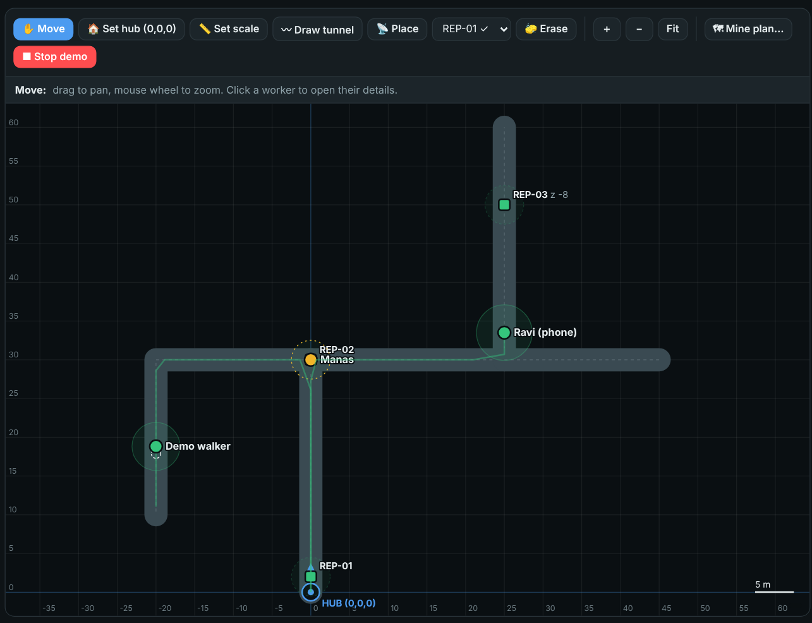
docs/report/figures/map.png
