Manas-36/MINESAFE/hardware/repeater_case/renders/case_back.png

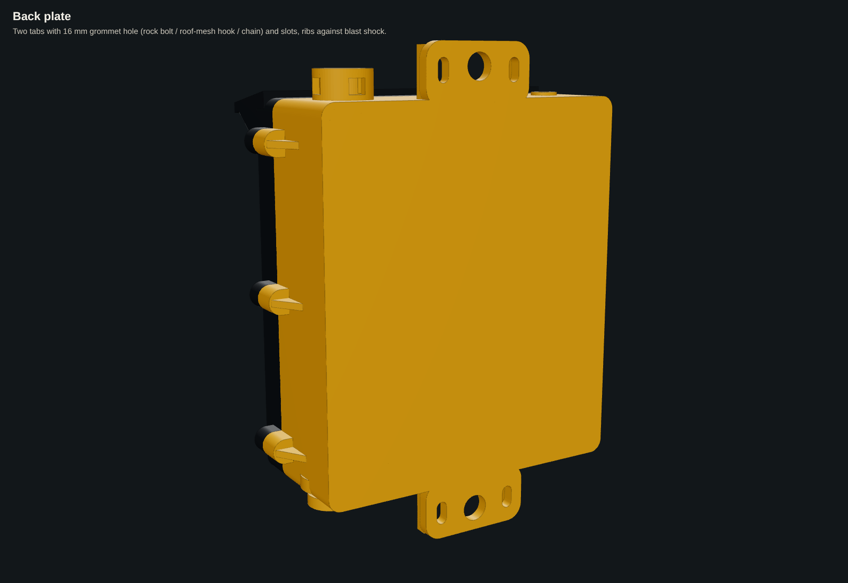
hardware/repeater_case/renders/case_back.png
