Manas-36/MINESAFE/hardware/repeater_pcb/renders/pcb_bottom.png

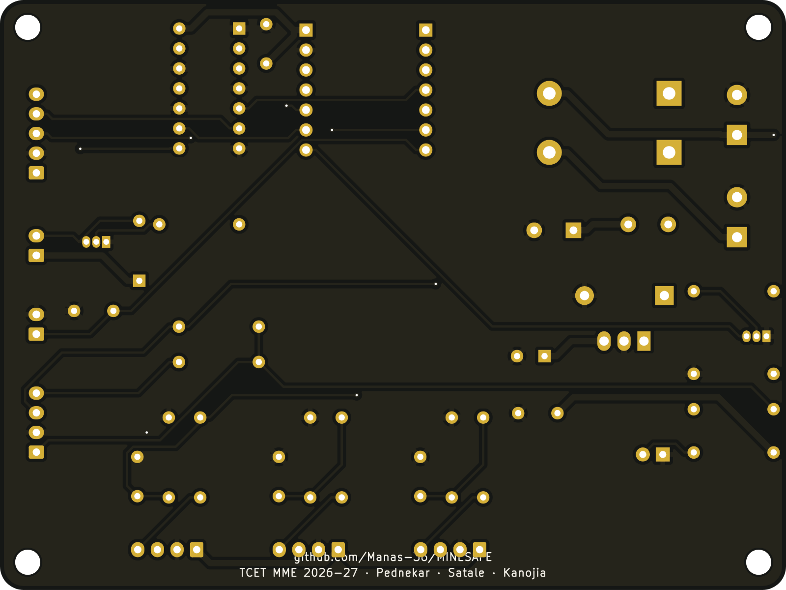
hardware/repeater_pcb/renders/pcb_bottom.png
