Manas-36/MINESAFE/hardware/suit_pcb/boot/renders/boot_bottom.png

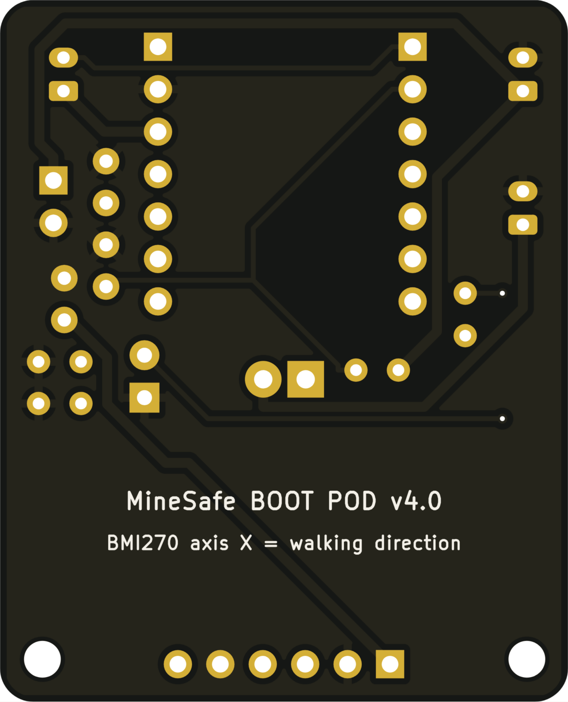
hardware/suit_pcb/boot/renders/boot_bottom.png
