Manas-36/MINESAFE/hardware/suit_pcb/core/renders/core_bottom.png

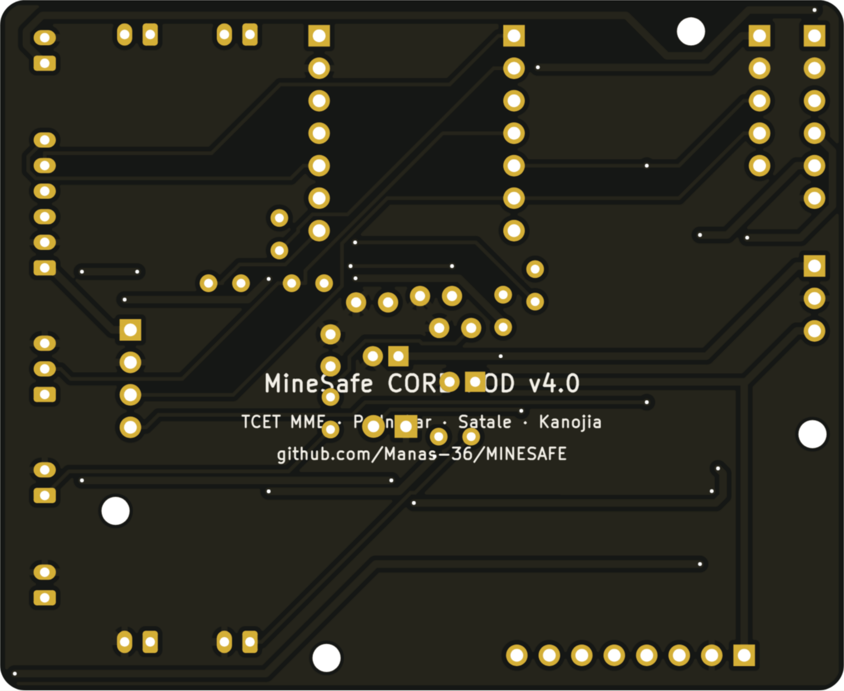
hardware/suit_pcb/core/renders/core_bottom.png
