Manas-36/MINESAFE/hardware/suit_pcb/cuff/renders/cuff_bottom.png

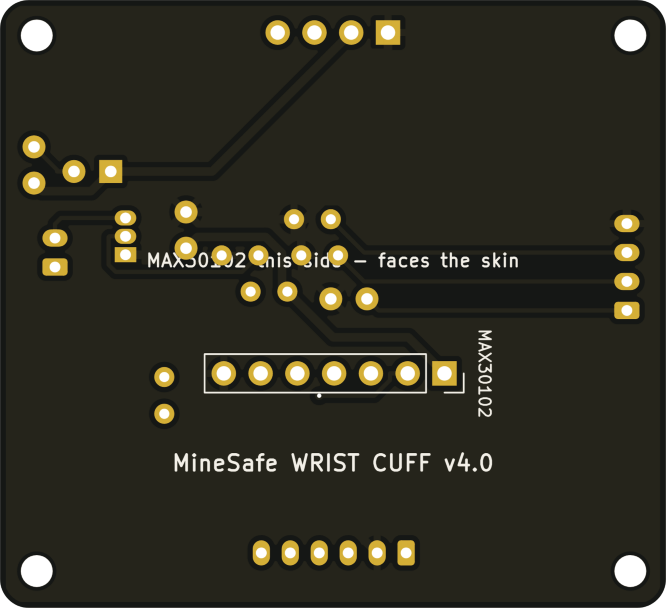
hardware/suit_pcb/cuff/renders/cuff_bottom.png
