Manas-36/MINESAFE/hardware/suit_pcb/helmet/renders/helmet_bottom.png

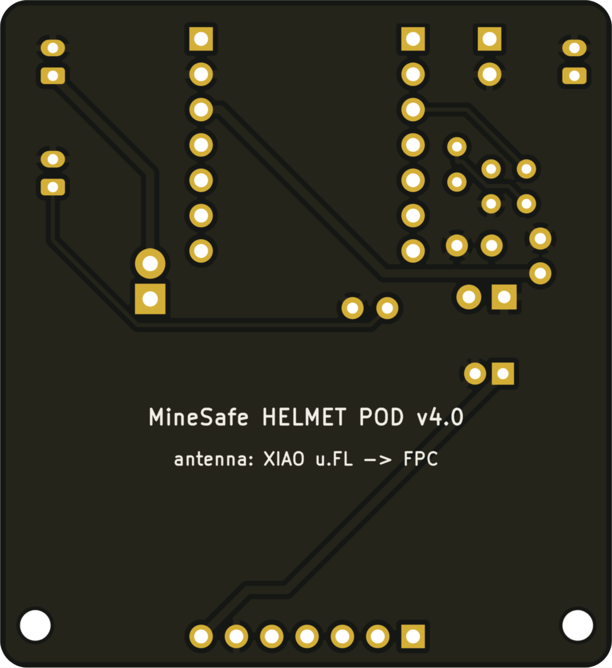
hardware/suit_pcb/helmet/renders/helmet_bottom.png
