Manas-36/MINESAFE/presentation/avishkar/poster/img/pod_boot.png

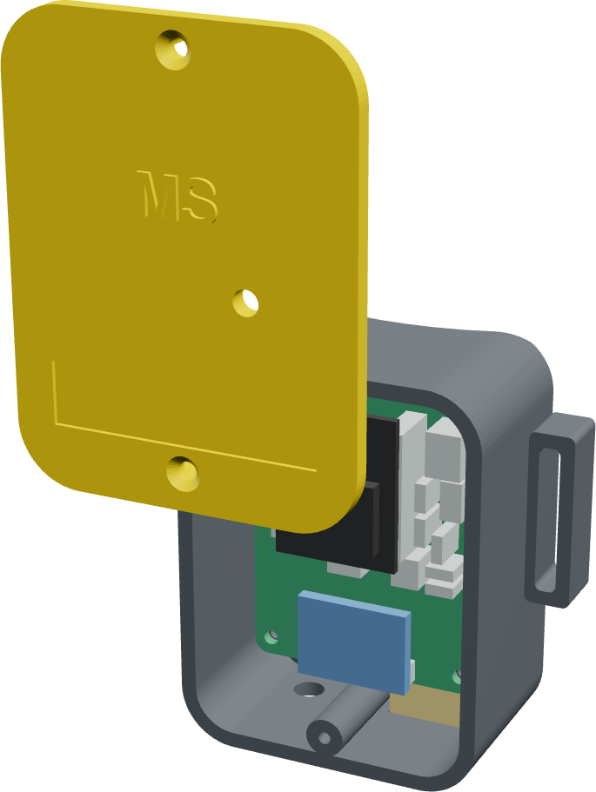
presentation/avishkar/poster/img/pod_boot.png
