Manas-36/MINESAFE/presentation/avishkar/poster/img/pod_core.png

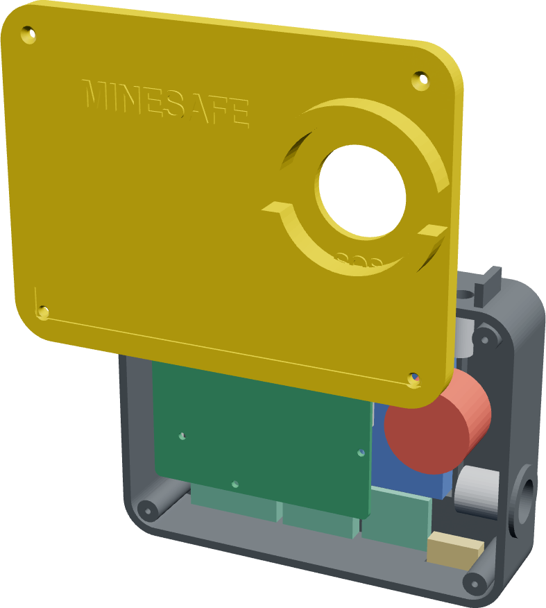
presentation/avishkar/poster/img/pod_core.png
