Manas-36/MINESAFE/presentation/avishkar/poster/img/pod_cuff.png

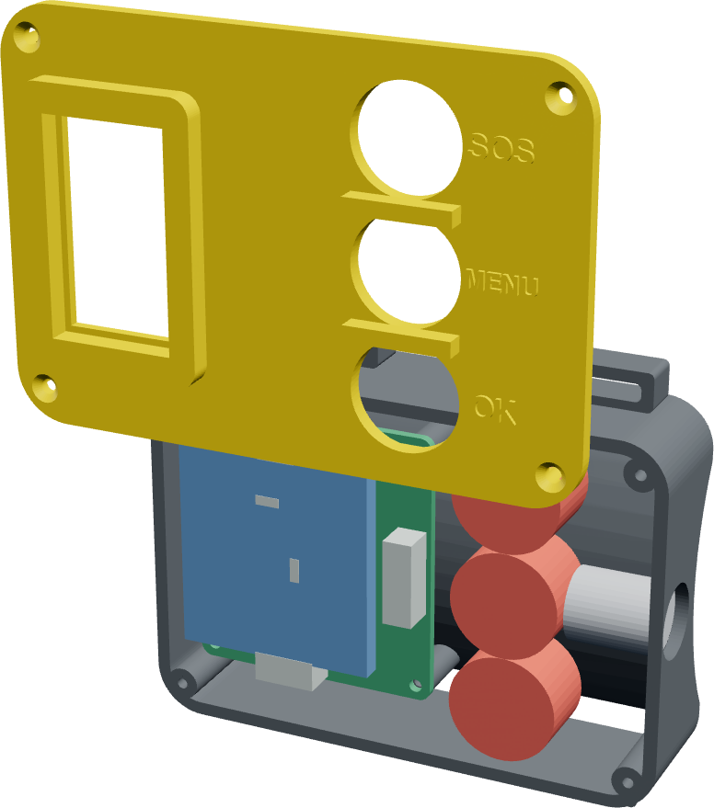
presentation/avishkar/poster/img/pod_cuff.png
