Manas-36/MINESAFE/presentation/avishkar/poster/img/pod_helmet.png

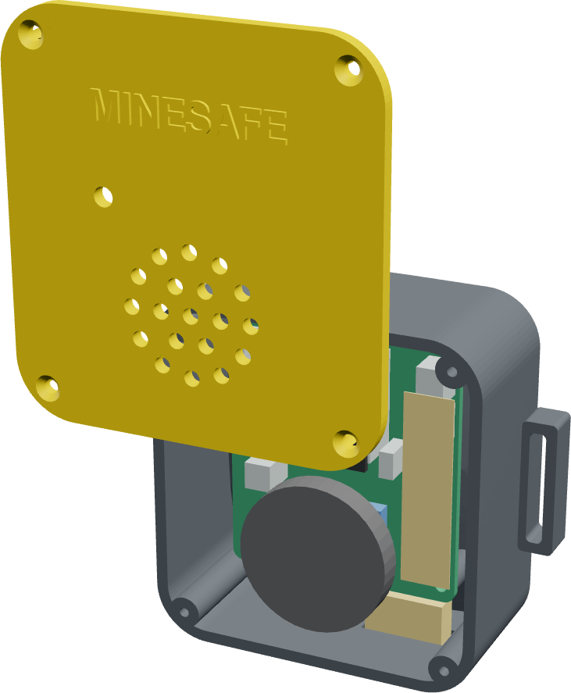
presentation/avishkar/poster/img/pod_helmet.png
