Manas-36/MINESAFE/presentation/avishkar/poster/img/repeater_inside.png

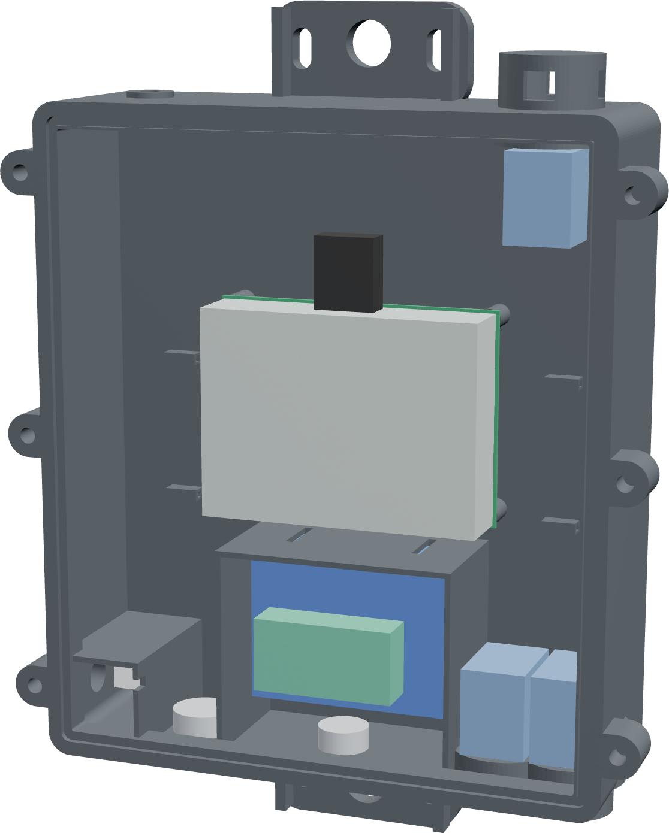
presentation/avishkar/poster/img/repeater_inside.png
