Manas-36/MINESAFE/tools/demo_map/demo_mine_plan.png

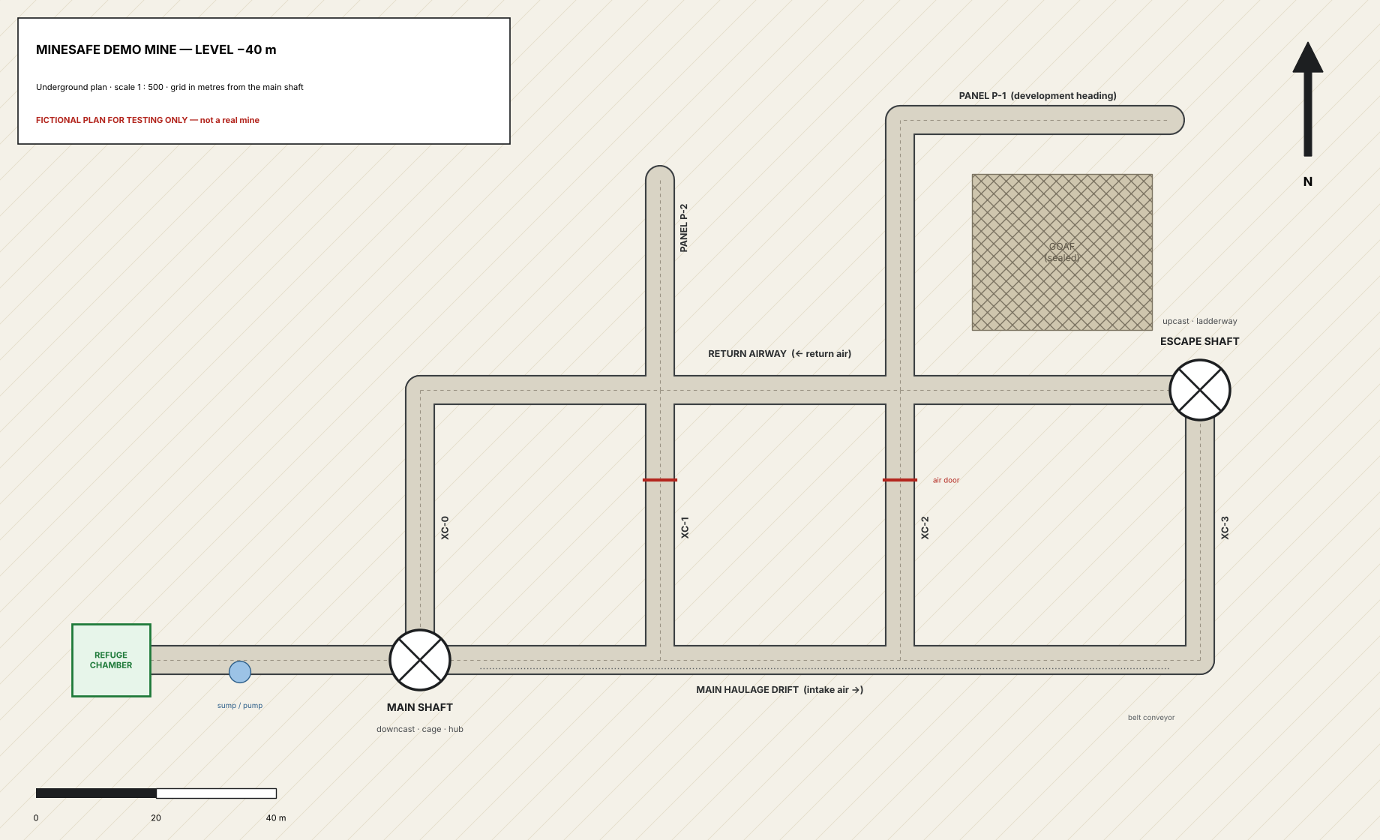
tools/demo_map/demo_mine_plan.png
