Manas-36/MINESAFE/hardware/repeater_x2_shopping_list.xlsx

MineSafe — components for 2 repeaters (PCB v4.0 + case)
Edit the blue cells (Qty, Unit ₹). Set 'Have it?' to Y for parts you already own — they drop out of 'To buy'. Prices are approximate Indian online prices, Oct 2026.
Part | Qty (for 2) | Unit ₹ | Total ₹ | Have it? (Y/N) | To buy ₹ | Bought ✓ | Supplier / link | Notes
1. Modules
Seeed XIAO ESP32-C6 | 2 | ₹600 | ₹1200 | N | ₹1200
MAX7219 8×32 LED matrix (FC-16, 4-in-1) | 2 | ₹300 | ₹600 | N | ₹600
MQ-4 gas sensor (methane) | 2 | ₹150 | ₹300 | N | ₹300
MQ-7 gas sensor (CO) | 2 | ₹150 | ₹300 | N | ₹300
MQ-136 gas sensor (H₂S) | 2 | ₹400 | ₹800 | N | ₹800
AHT20 temperature + humidity | 2 | ₹245 | ₹490 | N | ₹490
5 V active buzzer, loud (≥ 85 dB) | 2 | ₹60 | ₹120 | N | ₹120
Subtotal — Modules |  |  | ₹3810 |  | ₹3810
2. PCB + soldered parts
PCB from JLCPCB (min. order 5 boards) | 1 | ₹1000 | ₹1000 | N | ₹1000 |  |  | Lot of 5 incl. shipping; upload repeater_gerbers_jlcpcb.zip
K7805-2000R3 regulator (5 V / 2 A switching) | 2 | ₹450 | ₹900 | N | ₹900
1N5822 Schottky diode | 4 | ₹8 | ₹32 | N | ₹32
P6KE36A TVS diode | 2 | ₹10 | ₹20 | N | ₹20
1N4148 diode | 2 | ₹1 | ₹2 | N | ₹2
T1.6 A fuse, TR5 | 4 | ₹25 | ₹100 | N | ₹100 |  |  | Includes 2 spares
470 µF 50 V capacitor | 2 | ₹15 | ₹30 | N | ₹30
220 µF 16 V capacitor | 2 | ₹5 | ₹10 | N | ₹10
100 nF ceramic capacitor | 12 | ₹1 | ₹12 | N | ₹12
S8050 transistor | 4 | ₹2 | ₹8 | N | ₹8
74HCT125 + DIP-14 socket | 2 | ₹30 | ₹60 | N | ₹60 |  |  | Must be HCT, not HC
Resistors ¼ W: 1k×4, 10k×10, 22k×2, 20k×6, 4.7k×4 | 1 | ₹20 | ₹20 | N | ₹20 |  |  | Lot of 26 resistors
3 mm green LED | 2 | ₹1 | ₹2 | N | ₹2
1×7 female header 2.54 mm (XIAO sockets) | 4 | ₹10 | ₹40 | N | ₹40
2-pin screw terminal 5.08 mm | 4 | ₹12 | ₹48 | N | ₹48
JST-XH kit: 4-pin×8, 5-pin×2, 2-pin×4 + housings, crimps | 1 | ₹150 | ₹150 | N | ₹150 |  |  | Cheaper as one kit
M3 standoffs + screws | 8 | ₹5 | ₹40 | N | ₹40
Subtotal — PCB + soldered parts |  |  | ₹2474 |  | ₹2474
3. Case, power + fittings
PETG print, base + lid (≈ 1.1 kg each) | 2 | ₹1000 | ₹2000 | N | ₹2000 |  |  | Per set
3S 18650 pack with BMS + 12.6 V charge module | 2 | ₹900 | ₹1800 | N | ₹1800 |  |  | Optional for demo
DC adapter 15–24 V, 2 A (mine-supply stand-in) | 2 | ₹350 | ₹700 | N | ₹700 |  |  | 24 V ideal: supply then wins over the battery (see wiring diagram)
Wago 221-413 lever splitter | 4 | ₹40 | ₹160 | N | ₹160 |  |  | 2 per box: splits supply to J1 + charge module
Inline 3 A blade fuse holder + fuse | 2 | ₹40 | ₹80 | N | ₹80 |  |  | In battery P+
Wire: 0.75 mm² red/black 2 m, 26 AWG 6 colours, Dupont housings, heat-shrink | 1 | ₹300 | ₹300 | N | ₹300 |  |  | Lot for both boxes
22 mm IP67 red mushroom button (SOS) | 2 | ₹150 | ₹300 | N | ₹300
u.FL → SMA bulkhead pigtail + 2.4 GHz antenna | 2 | ₹250 | ₹500 | N | ₹500
M12 ePTFE pressure vent | 4 | ₹100 | ₹400 | N | ₹400 |  |  | 2 per box
Sintered bronze disc 25 mm (gas-port filter) | 6 | ₹60 | ₹360 | N | ₹360
ePTFE membrane patches | 8 | ₹30 | ₹240 | N | ₹240
M16 cable gland IP68 | 2 | ₹40 | ₹80 | N | ₹80
M4 × 25 stainless screws | 12 | ₹8 | ₹96 | N | ₹96
M4 heat-set inserts | 12 | ₹7 | ₹84 | N | ₹84
3 mm silicone cord, per metre (lid seal) | 2 | ₹60 | ₹120 | N | ₹120 |  |  | ≈ 0.8 m per box
3 mm polycarbonate, 150 × 50 (window) | 2 | ₹60 | ₹120 | N | ₹120
Reflective tape + 16 mm rubber grommets | 1 | ₹100 | ₹100 | N | ₹100 |  |  | Lot
Subtotal — Case, power + fittings |  |  | ₹7440 |  | ₹7440
TOTAL for 2 repeaters |  |  | ₹13724 |  | ₹13724
Per repeater |  |  | ₹6862 |  | ₹6862
Notes
• Hardware is identical for both; one runs as main repeater (IS_GATEWAY 1), the other as tunnel repeater (IS_GATEWAY 0).
• If the V3 repeaters already have the XIAOs, matrices, MQ sensors, AHT20s and buzzers, mark section 1 as Y.
• For the demo you can skip the battery packs and run off the 12 V adapters.
• Wiring: docs/wiring/repeater_v4_wiring.png. Full details: hardware/README.md and hardware/repeater_pcb/bom_pcb.csv in the MINESAFE repo.
