Manas-36/MINESAFE/hardware/repeater_pcb/bom_pcb.csv

Qty | References | Value | Package | Description | Approx price each (INR) | Note
1 | PCB | MineSafe repeater v4.0 | 100 x 75 mm 2-layer 1.6 mm | JLCPCB / PCBWay from repeater_gerbers_jlcpcb.zip | 60 | 5 boards ~USD 2 + shipping
1 | U1 | K7805-2000R3 (or R-78B5.0-2.0) | SIP-3 | Switching 5 V 2 A regulator 8-32 V in | 450 | LM7805 + heatsink is NOT a substitute at 24 V (too hot)
2 | D1,D2 | 1N5822 | DO-201AD | 3 A Schottky - OR of mine supply and battery | 8
1 | D3 | P6KE36A | DO-15 | 36 V TVS surge clamp | 10
1 | D4 | 1N4148 | DO-35 | Buzzer flyback | 1
1 | F1 | T1.6A TR5 (Littelfuse 372) | TR5 | Slow fuse on input | 25
1 | C1 | 470 uF 50 V | radial 10 mm | Input bulk | 15
1 | C2 | 220 uF 16 V | radial 8 mm | 5 V bulk | 5
6 | C3,C4,C5,C11,C12,C13 | 100 nF | disc 5 mm | Decoupling / filter | 1
2 | Q1,Q2 | S8050 | TO-92 | Buzzer driver / mains-present detector | 2
2 | R1,R5 | 1 k | 0.25 W axial |  | 0.5
5 | R3,R4,R11,R12,R13 | 10 k | 0.25 W axial |  | 0.5
1 | R2 | 22 k | 0.25 W axial |  | 0.5
3 | R21,R22,R23 | 20 k | 0.25 W axial | MQ divider low side | 0.5
2 | R6,R7 | 4.7 k | 0.25 W axial | I2C pull-ups | 0.5
1 | LED1 | 3 mm green |  | Power LED | 1
1 | U3 | 74HCT125 | DIP-14 + socket | 3.3 V -> 5 V buffer for MAX7219 | 25 | must be HCT not HC
2 | U2A,U2B | 1x7 female header 2.54 mm |  | Socket for XIAO ESP32-C6 | 10
2 | J1,J2 | 2-pin screw terminal 5.08 mm | MKDS 1.5 | Mine supply / battery | 12
4 | J3,J4,J5,J6 | JST XH 4-pin + housing + crimps | B4B-XH-A | MQ1-3 / AHT20 | 6
1 | J7 | JST XH 5-pin | B5B-XH-A | MAX7219 matrix | 6
2 | J8,J9 | JST XH 2-pin | B2B-XH-A | Buzzer / SOS button | 4
4 | H1-H4 | M3 x 8 brass standoff + screw |  | Board to case bosses (or self-tapping 2.9 x 9) | 5
