Manas-36/MINESAFE/hardware/suit_pcb/core/bom_core.csv

Qty | References | Value / module | Footprint | Description | Approx INR each
4 | C1 C2 C3 C5 | 100nF | C_Disc_D3.0mm_W1.6mm_P2.50mm | ceramic capacitor | 1
2 | C4 C6 | 100uF 10V | CP_Radial_D5.0mm_P2.00mm | electrolytic capacitor | 4
1 | J1 | BATT | JST_PH_B2B-PH-K_1x02_P2.00mm_Vertical | JST-PH 2.0 mm vertical + housing + crimped lead | 8
1 | J2 | PWR SW | JST_PH_B2B-PH-K_1x02_P2.00mm_Vertical | JST-PH 2.0 mm vertical + housing + crimped lead | 8
1 | J3 | POGO | JST_PH_B2B-PH-K_1x02_P2.00mm_Vertical | JST-PH 2.0 mm vertical + housing + crimped lead | 8
1 | J4 | CUFF | JST_PH_B6B-PH-K_1x06_P2.00mm_Vertical | JST-PH 2.0 mm vertical + housing + crimped lead | 8
1 | J5 | SKIN T | JST_PH_B3B-PH-K_1x03_P2.00mm_Vertical | JST-PH 2.0 mm vertical + housing + crimped lead | 8
1 | J6 | SOS | JST_PH_B2B-PH-K_1x02_P2.00mm_Vertical | JST-PH 2.0 mm vertical + housing + crimped lead | 8
1 | J7 | ZIP | JST_PH_B2B-PH-K_1x02_P2.00mm_Vertical | JST-PH 2.0 mm vertical + housing + crimped lead | 8
1 | J8 | TEAR | JST_PH_B2B-PH-K_1x02_P2.00mm_Vertical | JST-PH 2.0 mm vertical + housing + crimped lead | 8
1 | J9 | SKIN PAD | JST_PH_B2B-PH-K_1x02_P2.00mm_Vertical | JST-PH 2.0 mm vertical + housing + crimped lead | 8
1 | J10 | CHARGER | PinHeader_1x06_P2.54mm_Vertical | male header (wire pads to module) | 3
1 | J11 | BUCK-BOOST | PinHeader_1x03_P2.54mm_Vertical | male header (wire pads to module) | 3
1 | J12 | GAUGE | PinHeader_1x05_P2.54mm_Vertical | male header (wire pads to module) | 3
1 | LED1 | STATUS | LED_D3.0mm | 3 mm LED | 1
1 | R1 | 4.7k | R_Axial_DIN0204_L3.6mm_D1.6mm_P2.54mm_Vertical | resistor 1/8 W, standing | 0.5
1 | R2 | 1M | R_Axial_DIN0204_L3.6mm_D1.6mm_P2.54mm_Vertical | resistor 1/8 W, standing | 0.5
1 | R3 | 470 | R_Axial_DIN0204_L3.6mm_D1.6mm_P2.54mm_Vertical | resistor 1/8 W, standing | 0.5
4 | R4 R5 R6 R7 | 1k | R_Axial_DIN0204_L3.6mm_D1.6mm_P2.54mm_Vertical | resistor 1/8 W, standing | 0.5
1 | U2 | GY-521 MPU6050 | PinSocket_1x08_P2.54mm_Vertical | female header socket 2.54 mm | 10
1 | U3 | GY-68 BMP180 | PinSocket_1x04_P2.54mm_Vertical | female header socket 2.54 mm | 10
1 | U1A | XIAO D0-D6 | PinSocket_1x07_P2.54mm_Vertical | female header socket 2.54 mm | 10
1 | U1B | XIAO 5V-D7 | PinSocket_1x07_P2.54mm_Vertical | female header socket 2.54 mm | 10
1 | PCB | MineSafe core v4.0 | 2-layer 1.6 mm | JLCPCB (5 pcs min) | 50
