Manas-36/MINESAFE/docs/research/source/Total_System_BOM.xlsx

Sheet: Summary
Total System Bill of Materials
Intelligent Safety Gear Compliance, Health Monitoring, and Navigation System for Miners
Change the yellow deployment-scale cells below; every sheet and total recalculates automatically.
Deployment Scale (editable)
Number of workers (wearable hubs) | 20 |  | <- workers
Number of entry chambers (checkpoints) | 2 |  | <- chambers
Number of underground repeater nodes | 8 |  | <- repeaters
Number of surface gateways | 1 |  | <- gateways
Number of on-premise servers | 1 |  | <- servers
Subsystem Cost Summary
Subsystem | Unit cost (1x) INR | Units deployed | Subtotal (INR)
Worker Wearable Hub (incl. tags) | 5115 | 20 | 102300
Entry Chamber (checkpoint) | 46850 | 2 | 93700
Underground Repeater Node | 4750 | 8 | 38000
Surface Gateway | 22000 | 1 | 22000
On-Premise Server | 45000 | 1 | 45000
GRAND TOTAL (Pilot Deployment) |  |  | 301000
Note: costs are indicative India-market approximations for prototype/pilot budgeting as of mid-2026. Verify against current supplier quotes before finalizing a purchase order.

Sheet: Wearable Hub
Wearable Hub — Bill of Materials
One complete worker wearable unit, including the four PPE item tags issued with it.
S.No | Component | Specification / Part Number | Function | Unit Price (INR) | Qty per Unit | Deployed Units | Total Qty | Total Price (INR)
1 | Microcontroller | ESP32-WROOM-32 Dev Board (Espressif, dual-core 240MHz, Wi-Fi + BLE 5.0) | Central controller; sensor aggregation and radio management | 450 | 1 | 20 | 20 | 9000
2 | UWB Positioning Module | DWM3000 (Qorvo/Decawave, IEEE 802.15.4z compliant) | Sub-metre ranging against fixed underground UWB anchors | 2000 | 1 | 20 | 20 | 40000
3 | Inertial Measurement Unit | MPU-6050 (InvenSense, 6-axis accelerometer + gyroscope, I2C) | Fall/impact detection, dead-reckoning between UWB fixes | 100 | 1 | 20 | 20 | 2000
4 | Heart Rate / SpO2 Sensor | MAX30102 (Analog Devices, PPG optical sensor, I2C) | Continuous heart rate and blood-oxygen monitoring | 200 | 1 | 20 | 20 | 4000
5 | Body Temperature Sensor | MLX90614 (Melexis, non-contact IR thermometer, ±0.5°C, I2C) | Continuous non-contact body temperature | 600 | 1 | 20 | 20 | 12000
6 | LoRa Radio Module | SX1262-based module, e.g. E22-900T22S (Semtech, 868/915MHz, +22dBm) | Long-range low-power backhaul to nearest repeater | 400 | 1 | 20 | 20 | 8000
7 | NFC Reader Module | PN532 (NXP, 13.56MHz, I2C/SPI/UART) | Reads worker ID badge at shift start, binds session to hub | 350 | 1 | 20 | 20 | 7000
8 | Gas Sensor (optional) | MQ-2 module (combustible gas / smoke, analog output) | Local per-worker hazard sensing | 150 | 1 | 20 | 20 | 3000
9 | Helmet Strap Microswitch | SPDT micro limit switch, panel-mount | Mechanical confirmation the chin strap is fastened | 40 | 1 | 20 | 20 | 800
10 | SOS Push Button | 12mm waterproof momentary switch, illuminated | Manual emergency escalation, bypasses automated rules | 30 | 1 | 20 | 20 | 600
11 | Battery Pack | 18650 Li-ion cell, 3.7V 3400mAh (e.g. Samsung/LG INR18650) + TP4056 charge module | Power for a full 8+ hour shift | 350 | 1 | 20 | 20 | 7000
12 | Enclosure, PCB & Wiring | Custom IP66-rated ABS enclosure, PCB, connectors | Housing, protection, and assembly | 300 | 1 | 20 | 20 | 6000
13 | Worker ID Badge Tag | NTAG213 NFC wristband tag (13.56MHz, 144-byte memory) | Worker identity credential, read at chamber and hub | 25 | 1 | 20 | 20 | 500
14 | PPE UHF RFID Tags | Alien Higgs-3 UHF inlay (860-960MHz, EPC Gen2, adhesive) | Embedded in helmet, vest, gloves, and boots (4 items) | 30 | 4 | 20 | 80 | 2400
 |  |  | Cost per single unit (before multiplying by deployed count) |  |  |  |  | 5115
 |  |  | Subtotal for all deployed units |  |  |  |  | 102300

Sheet: Entry Chamber
Entry Chamber — Bill of Materials
One checkpoint (e.g. lamp room / shaft entrance) with PPE assignment and camera verification.
S.No | Component | Specification / Part Number | Function | Unit Price (INR) | Qty per Unit | Deployed Units | Total Qty | Total Price (INR)
1 | UHF RFID Fixed Reader | Chainway UR4, 4-port fixed reader (860-960MHz, EPC Gen2, Ethernet/RS232/Wiegand) | Reads all PPE tags present in the chamber portal | 28000 | 1 | 2 | 2 | 56000
2 | UHF Panel Antenna | 8dBi circular-polarized UHF antenna | Portal read coverage across the walkway | 3000 | 2 | 2 | 4 | 12000
3 | Edge AI Compute Unit | Raspberry Pi 4 Model B, 4GB RAM | Runs TensorFlow Lite YOLO PPE-detection model locally | 5500 | 1 | 2 | 2 | 11000
4 | AI Verification Camera | Raspberry Pi Camera Module 3 (12MP, autofocus) | Captures worker image for camera-based PPE confirmation | 2500 | 1 | 2 | 2 | 5000
5 | Fixed NFC Badge Reader | PN532-based fixed reader unit, wall-mount | Reads worker ID badge at chamber entrance | 350 | 1 | 2 | 2 | 700
6 | Electromagnetic Door Lock | 12V DC solenoid lock, 280kg holding force | Gate lock; releases only on verified PPE compliance | 1500 | 1 | 2 | 2 | 3000
7 | Power Supply & Mounting Hardware | 12V/5V SMPS, frame and mounting brackets | Chamber power and physical structure | 3000 | 1 | 2 | 2 | 6000
 |  |  | Cost per single unit (before multiplying by deployed count) |  |  |  |  | 46850
 |  |  | Subtotal for all deployed units |  |  |  |  | 93700

Sheet: Repeater Node
Repeater Node — Bill of Materials
One fixed underground node combining a UWB anchor and a communications relay.
S.No | Component | Specification / Part Number | Function | Unit Price (INR) | Qty per Unit | Deployed Units | Total Qty | Total Price (INR)
1 | UWB Anchor Module | DWM3000 (Qorvo/Decawave), fixed and surveyed installation | Fixed positioning reference point for worker ranging | 2000 | 1 | 8 | 8 | 16000
2 | LoRa Relay Transceivers | SX1262-based modules (e.g. E22-900T22S) | One link toward worker side, one toward next hop to surface | 400 | 2 | 8 | 16 | 6400
3 | Local Aggregator | ESP32-WROOM-32 (light junctions) or Raspberry Pi 4 (busy junctions) | Buffers and forwards data if next hop briefly unreachable | 450 | 1 | 8 | 8 | 3600
4 | Enclosure | IP67 polycarbonate junction enclosure (ATEX-rated variant for gassy coal mines) | Protection against dust, humidity, and vibration | 800 | 1 | 8 | 8 | 6400
5 | Power Module | Mains-tap PSU with 12V/2200mAh battery backup | Node power with backup during mains interruption | 700 | 1 | 8 | 8 | 5600
 |  |  | Cost per single unit (before multiplying by deployed count) |  |  |  |  | 4750
 |  |  | Subtotal for all deployed units |  |  |  |  | 38000

Sheet: Surface & Server
Surface & Server — Bill of Materials
Surface gateway and on-premise server, priced separately since they scale on their own counts.
S.No | Component | Specification / Part Number | Function | Unit Price (INR) | Qty per Unit | Deployed Units | Total Qty | Total Price (INR)
1 | Industrial LTE/Ethernet Gateway | Teltonika RUT956, dual-SIM 4G router with Ethernet and I/O | Aggregates repeater chain data, uplinks to internet | 12000 | 1 | 1 | 1 | 12000
2 | LoRa Concentrator Gateway | RAK2245, 8-channel LoRaWAN concentrator (Raspberry Pi HAT) | Aggregates LoRa traffic from the repeater chain | 8000 | 1 | 1 | 1 | 8000
3 | Surface Antenna & Enclosure | Combo LoRa/4G antenna, IP65 outdoor enclosure | Surface unit housing and connectivity | 2000 | 1 | 1 | 1 | 2000
 |  |  | Cost per single gateway |  |  |  |  | 22000
 |  |  | Subtotal for all deployed gateways |  |  |  |  | 22000
1 | On-Premise Edge Server | Mini-PC / Edge Server, e.g. Intel NUC 13 Pro (i5, 16GB RAM, 512GB SSD) | Hosts multilateration engine, database, and dashboard backend | 45000 | 1 | 1 | 1 | 45000
 |  |  | Cost per single server |  |  |  |  | 45000
 |  |  | Subtotal for all deployed servers |  |  |  |  | 45000
Note: cloud-hosted alternative (AWS/Azure VM) available in place of the on-premise server, at an approximate recurring cost of INR 3,000-6,000/month instead of the one-time capex above.
