Manas-36/MINESAFE/hardware/repeater_case/case_assembly.step

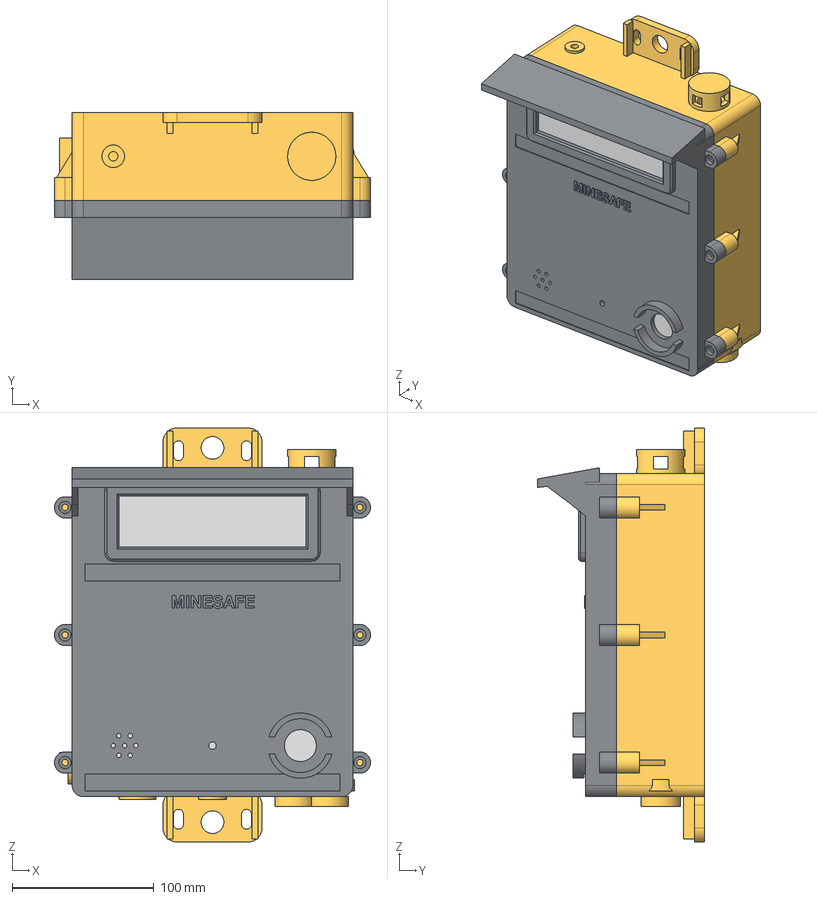
[picture p162: CAD file, 2026-10-23]
hardware/repeater_case/case_assembly.step
223.0 x 118.0 x 292.0 mm
base
lid
pcb
pcb_parts
xiao_usb_plug
matrix
window_pc
mq4_ch4
mq7_co
mq136_h2s
aht20
battery_3s
charger_bms
vent_nut
gland_nut
sos_button_body
buzzer
