Manas-36/MINESAFE/hardware/suit_cad/suit_assembly.step

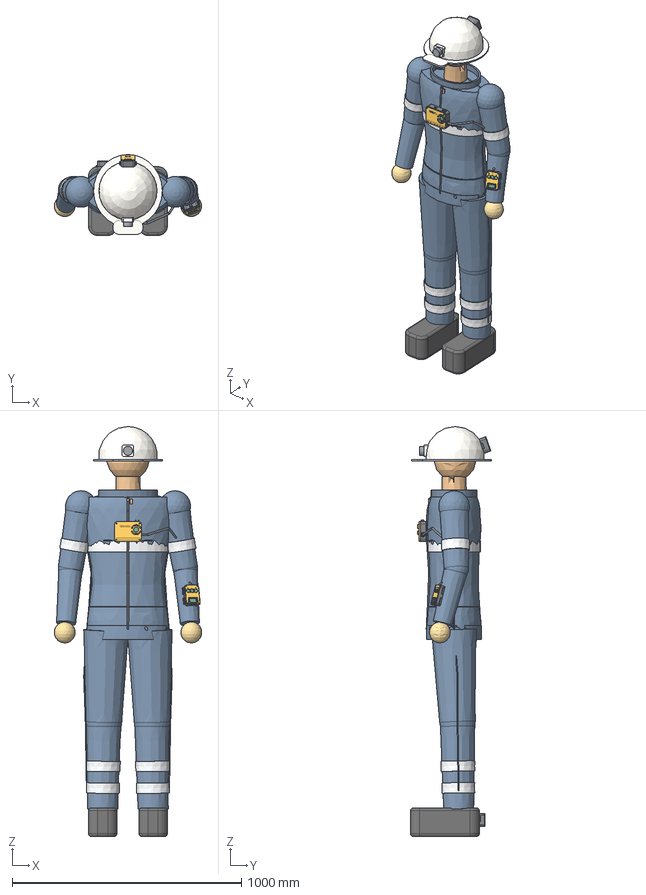
[picture p163: CAD file, 2026-10-24]
hardware/suit_cad/suit_assembly.step
643.0 x 353.0 x 1788.0 mm
core_base
core_lid
core_electronics
cuff_base
cuff_lid
cuff_electronics
helmet_base
helmet_lid
helmet_electronics
boot_base
boot_lid
boot_electronics
coverall_torso
coverall_limbs
collar
skin
gloves
boots
reflective_bands
helmet
cap_lamp
sleeve_cable
tear_thread
zip
reed_switch
zip_magnet
skin_pad
skin_temp_probe
helmet_worn_switch
heel_fsr
