Manas-36/MINESAFE/hardware/repeater_case/renders/stl/mq7_co.stl

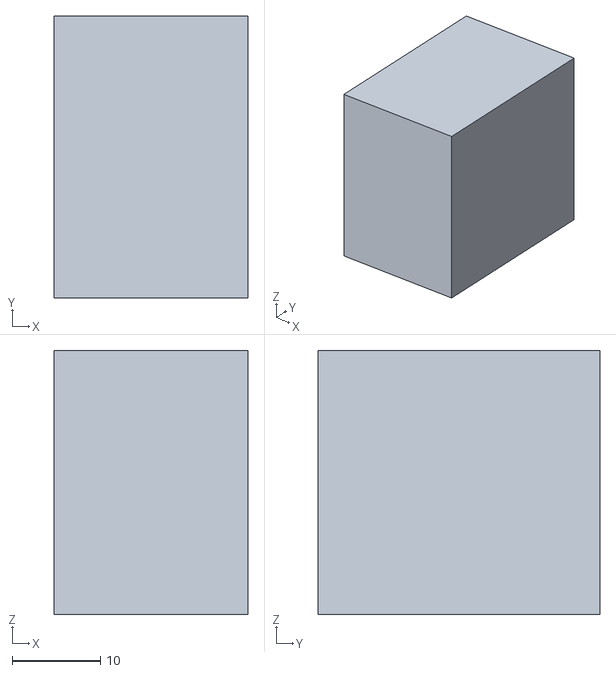
[picture p164: CAD file, 2026-10-23]
hardware/repeater_case/renders/stl/mq7_co.stl
22.0 x 32.0 x 30.0
