Manas-36/MINESAFE/hardware/suit_cad/pods/helmet_base.step

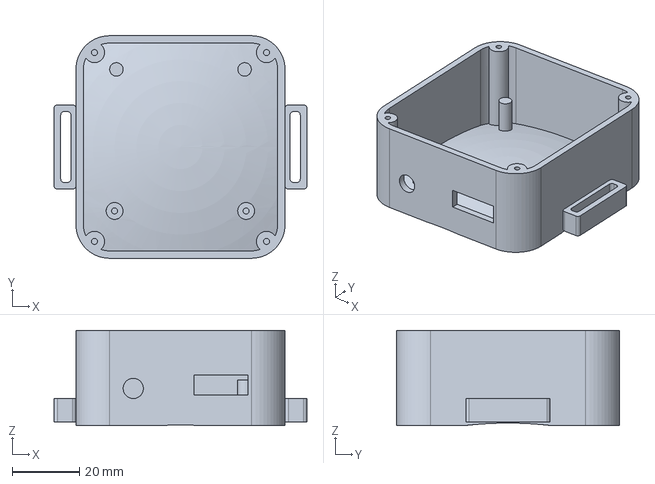
[picture p165: CAD file, 2026-10-24]
hardware/suit_cad/pods/helmet_base.step
75.0 x 66.0 x 28.2 mm
