Manas-36/MINESAFE/hardware/repeater_case/case_lid.step

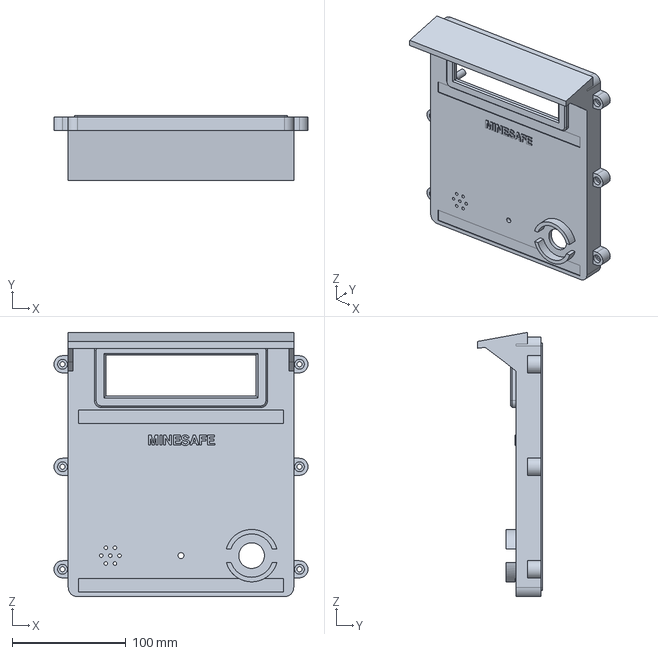
[picture p166: CAD file, 2026-10-23]
hardware/repeater_case/case_lid.step
223.0 x 57.4 x 232.0 mm
