Manas-36/MINESAFE/hardware/suit_cad/pods/cuff_lid.step

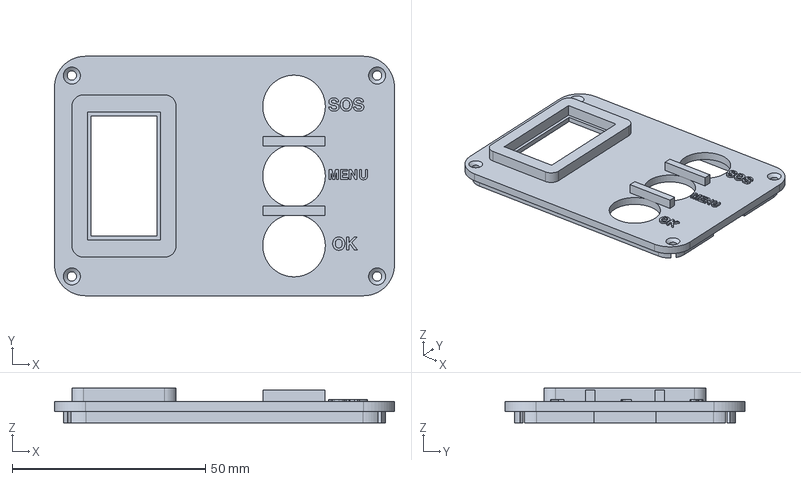
[picture p167: CAD file, 2026-10-24]
hardware/suit_cad/pods/cuff_lid.step
88.0 x 62.0 x 9.00 mm
