Manas-36/MINESAFE/hardware/repeater_case/case_base.step

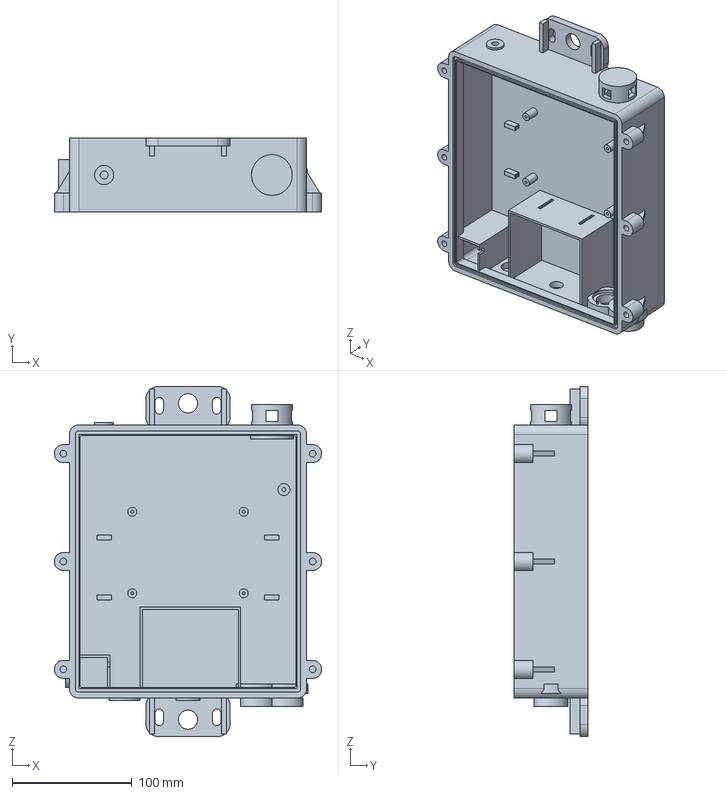
[picture p168: CAD file, 2026-10-23]
hardware/repeater_case/case_base.step
223.0 x 62.0 x 292.0 mm
