Manas-36/MINESAFE/hardware/repeater_case/renders/stl/battery_3s.stl

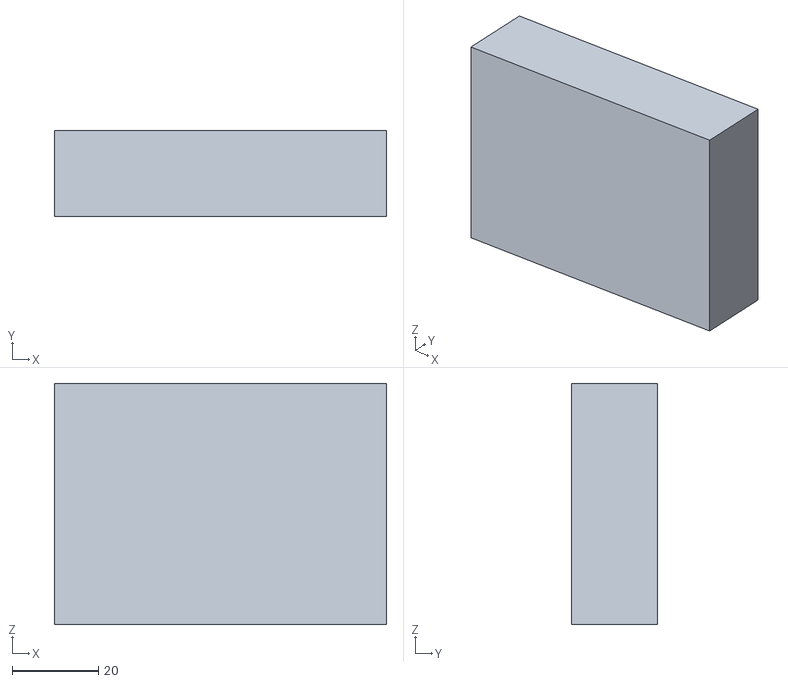
[picture p169: CAD file, 2026-10-23]
hardware/repeater_case/renders/stl/battery_3s.stl
77.0 x 20.0 x 56.0
