Manas-36/MINESAFE/hardware/suit_cad/pods/core_base.step

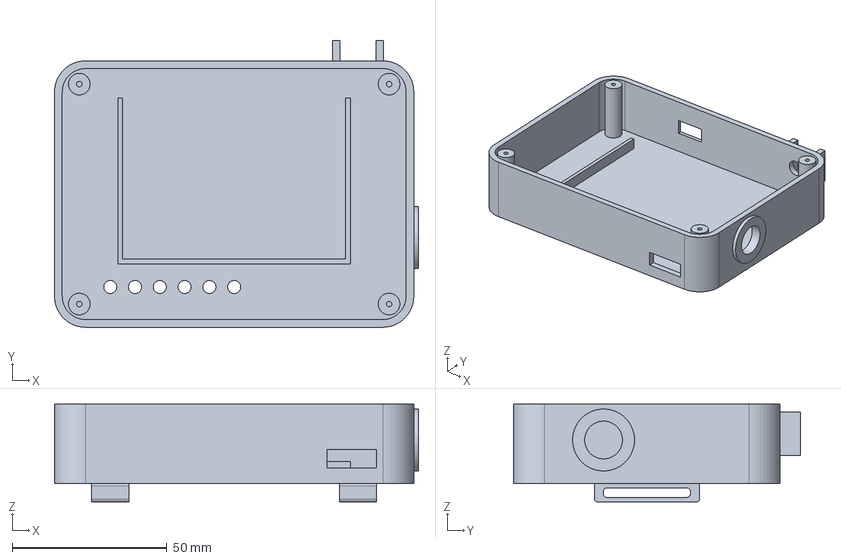
[picture p170: CAD file, 2026-10-24]
hardware/suit_cad/pods/core_base.step
117.5 x 92.5 x 31.6 mm
