Manas-36/MINESAFE/hardware/repeater_case/renders/stl/pcb_parts.stl

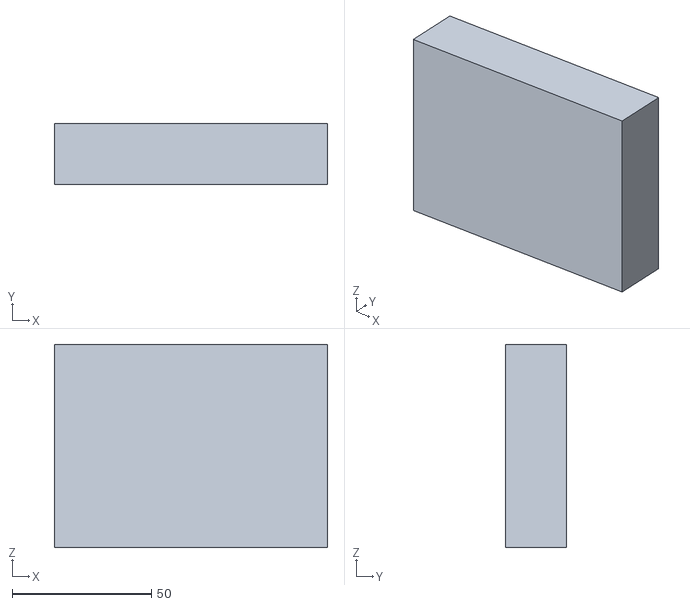
[picture p171: CAD file, 2026-10-23]
hardware/repeater_case/renders/stl/pcb_parts.stl
98.0 x 22.0 x 73.0
