Manas-36/MINESAFE/hardware/suit_cad/pods/boot_lid.step

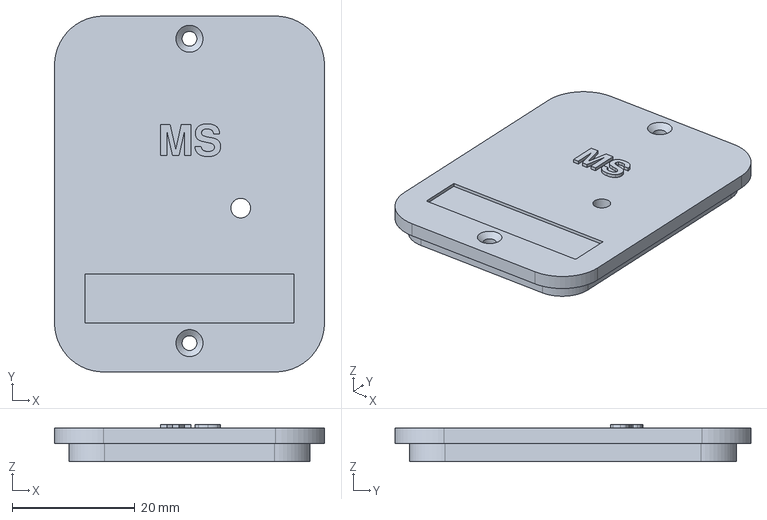
[picture p172: CAD file, 2026-10-24]
hardware/suit_cad/pods/boot_lid.step
44.0 x 58.0 x 6.10 mm
