Manas-36/MINESAFE/hardware/suit_cad/pods/core_lid.step

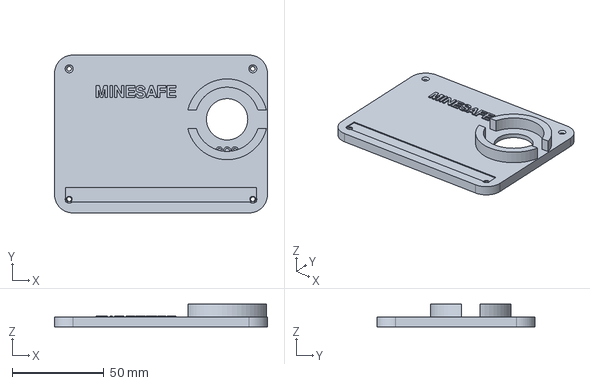
[picture p173: CAD file, 2026-10-24]
hardware/suit_cad/pods/core_lid.step
116.0 x 86.0 x 12.5 mm
