Manas-36/MINESAFE/hardware/repeater_case/renders/stl/xiao_usb_plug.stl

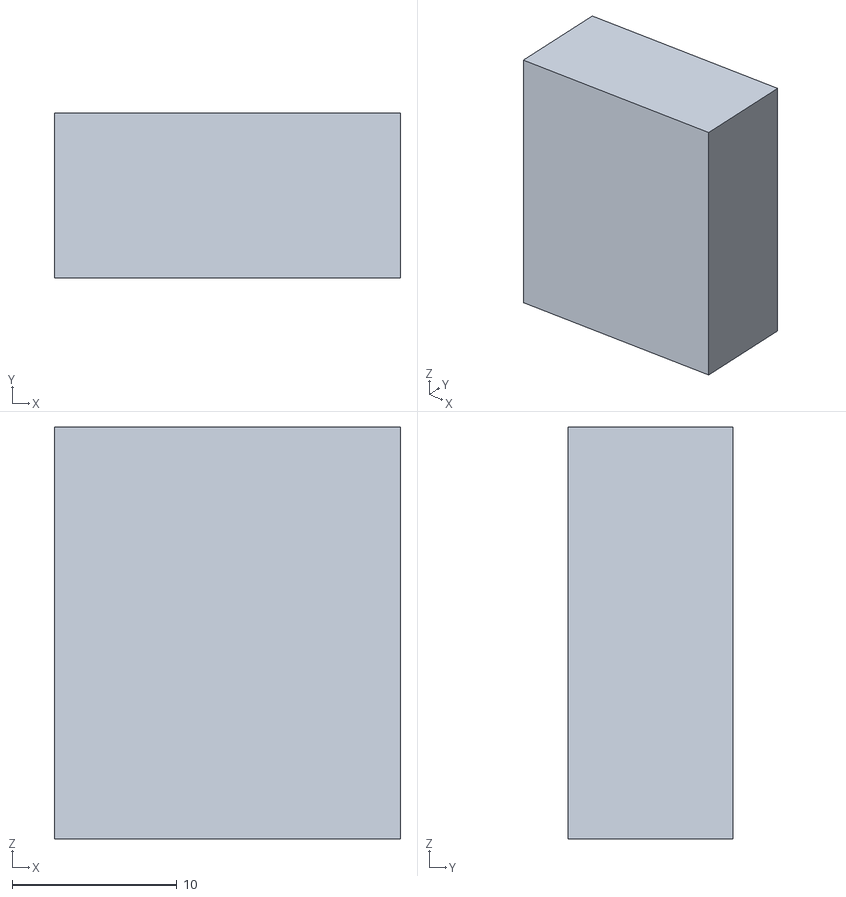
[picture p174: CAD file, 2026-10-23]
hardware/repeater_case/renders/stl/xiao_usb_plug.stl
21.0 x 10.0 x 25.0
