Manas-36/MINESAFE/hardware/suit_cad/pods/helmet_lid.step

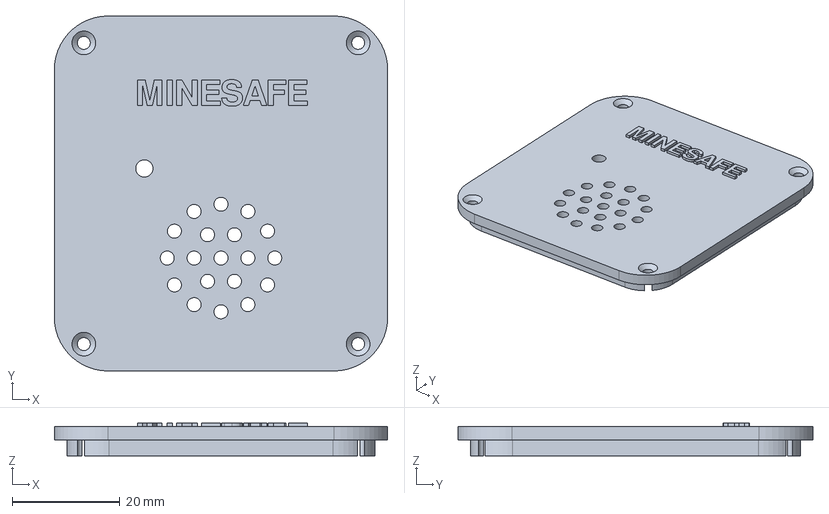
[picture p175: CAD file, 2026-10-24]
hardware/suit_cad/pods/helmet_lid.step
62.0 x 66.0 x 6.10 mm
