Manas-36/MINESAFE/hardware/repeater_case/renders/stl/buzzer.stl

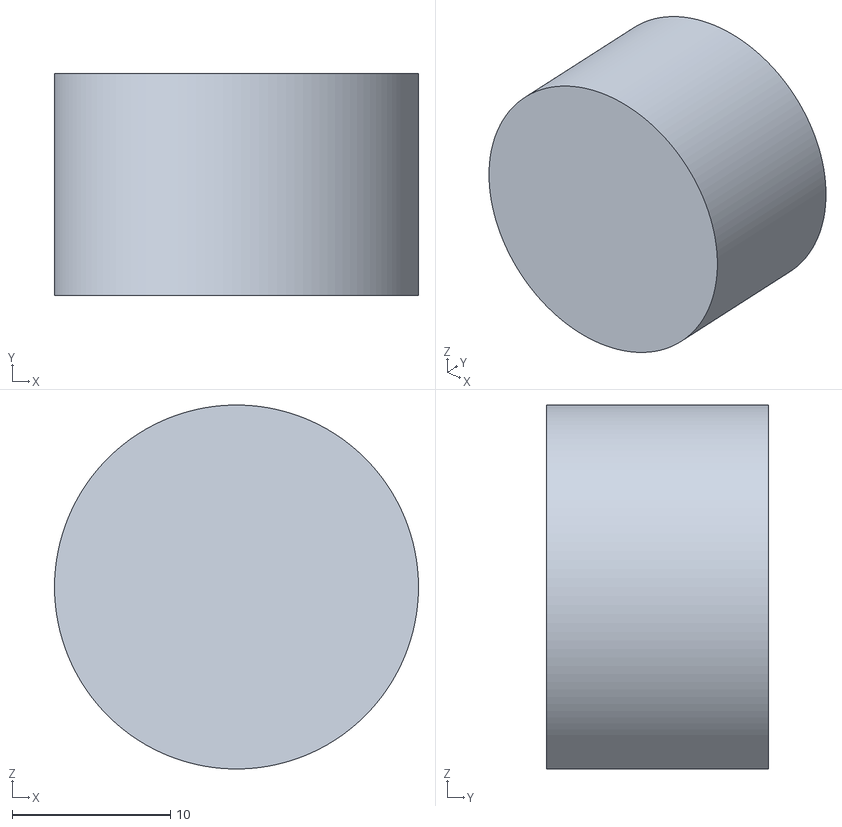
[picture p176: CAD file, 2026-10-23]
hardware/repeater_case/renders/stl/buzzer.stl
23.0 x 14.0 x 23.0
