Manas-36/MINESAFE/hardware/suit_cad/pods/cuff_base.step

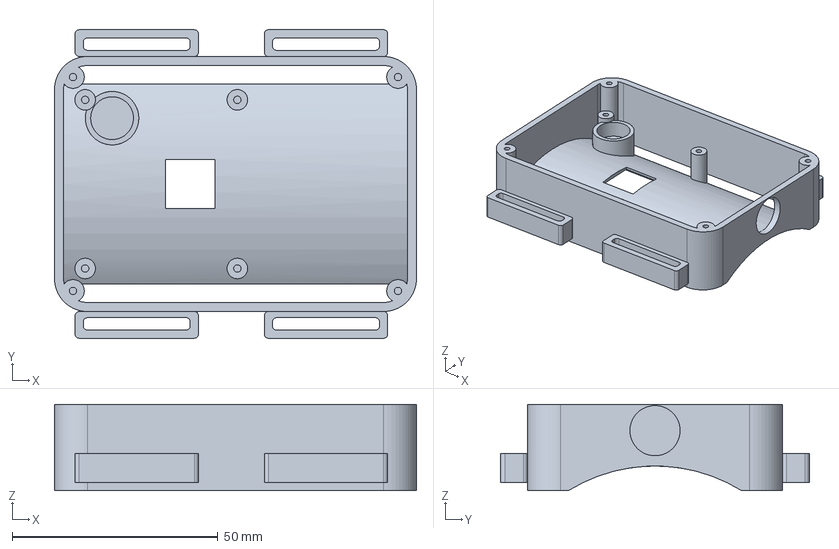
[picture p177: CAD file, 2026-10-24]
hardware/suit_cad/pods/cuff_base.step
88.0 x 75.0 x 21.0 mm
