Manas-36/MINESAFE/hardware/repeater_case/renders/stl/charger_bms.stl

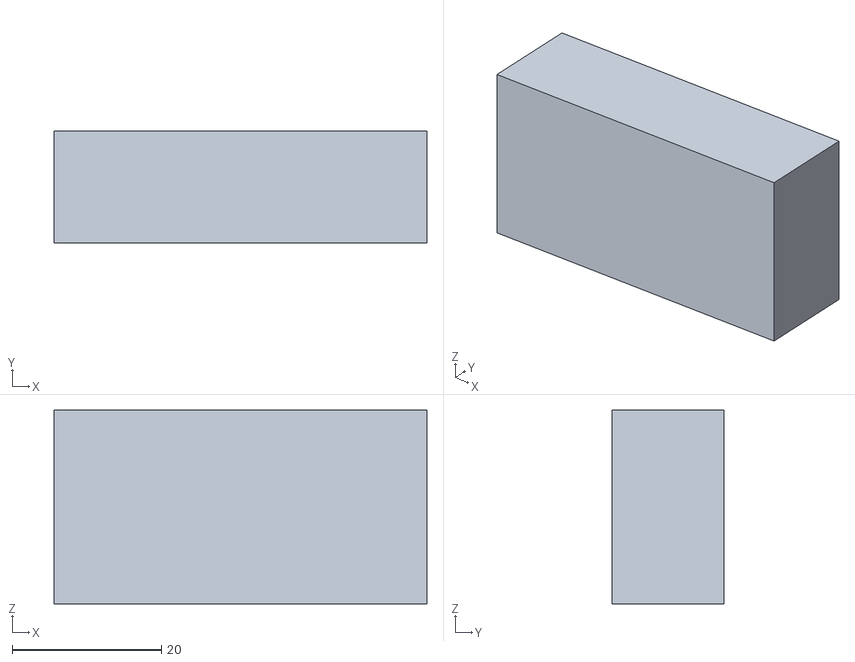
[picture p178: CAD file, 2026-10-23]
hardware/repeater_case/renders/stl/charger_bms.stl
50.0 x 15.0 x 26.0
