Manas-36/MINESAFE/hardware/suit_cad/pods/boot_base.step

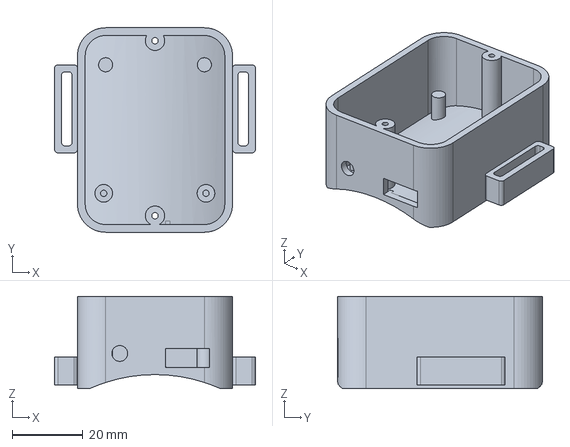
[picture p179: CAD file, 2026-10-24]
hardware/suit_cad/pods/boot_base.step
57.0 x 58.0 x 26.2 mm
