Manas-36/MINESAFE/hardware/repeater_case/renders/stl/pcb.stl

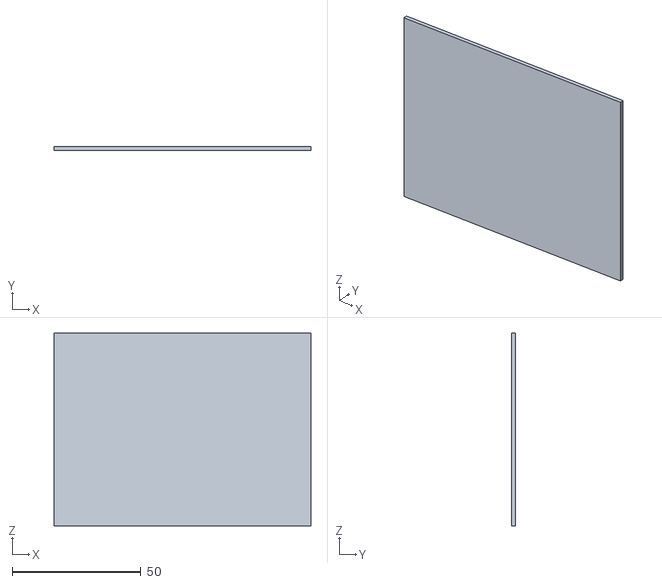
[picture p180: CAD file, 2026-10-23]
hardware/repeater_case/renders/stl/pcb.stl
100.0 x 1.60 x 75.0
