Manas-36/MINESAFE/hardware/repeater_case/renders/stl/aht20.stl

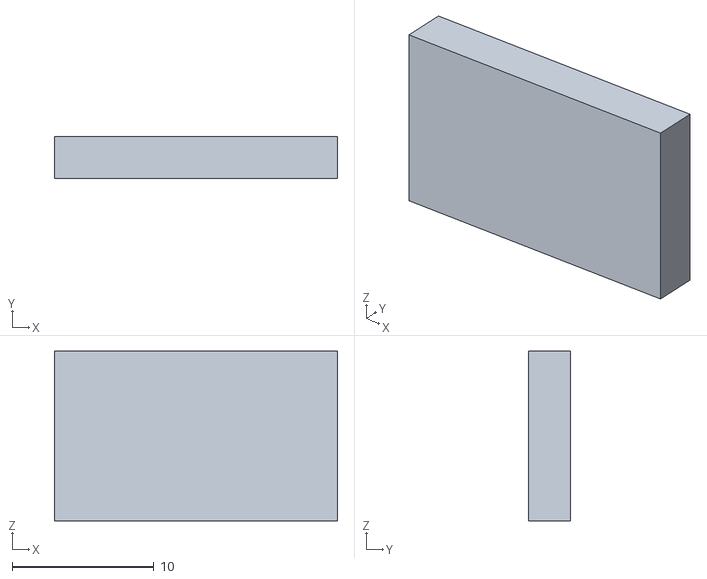
[picture p181: CAD file, 2026-10-23]
hardware/repeater_case/renders/stl/aht20.stl
20.0 x 3.00 x 12.0
