Manas-36/MINESAFE/hardware/repeater_case/renders/stl/sos_button_body.stl

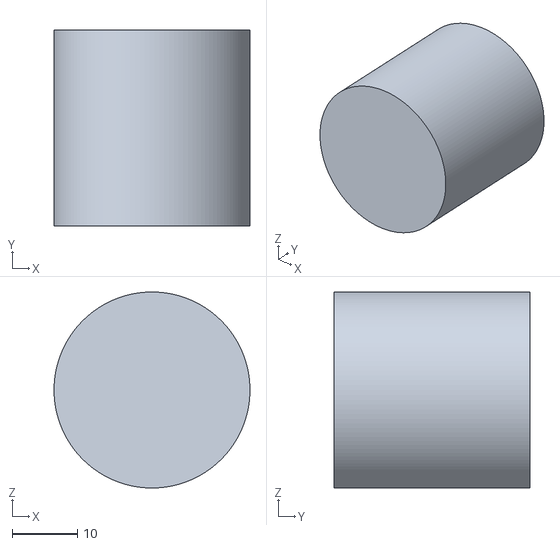
[picture p182: CAD file, 2026-10-23]
hardware/repeater_case/renders/stl/sos_button_body.stl
30.0 x 30.0 x 30.0
