Manas-36/MINESAFE/hardware/repeater_case/renders/stl/matrix.stl

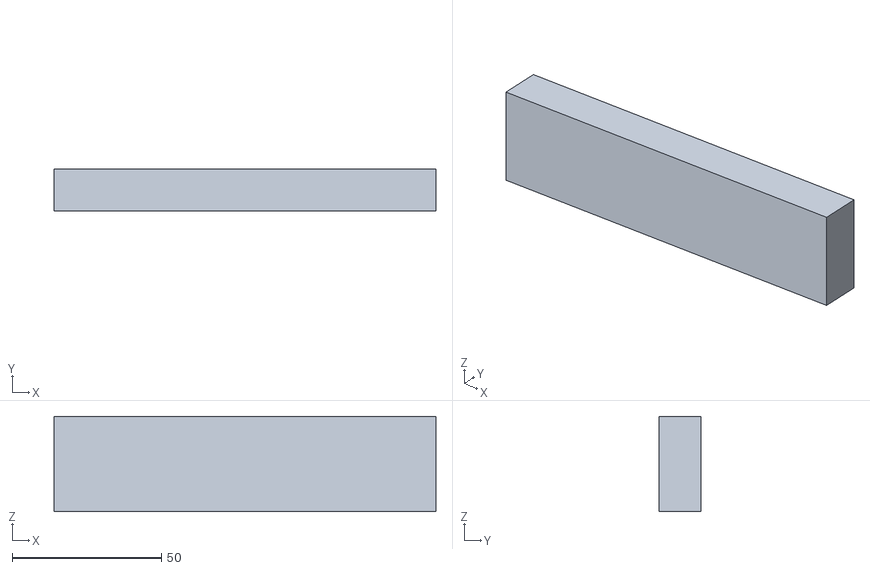
[picture p183: CAD file, 2026-10-23]
hardware/repeater_case/renders/stl/matrix.stl
128.0 x 14.0 x 32.0
