Manas-36/MINESAFE/hardware/repeater_case/renders/stl/window_pc.stl

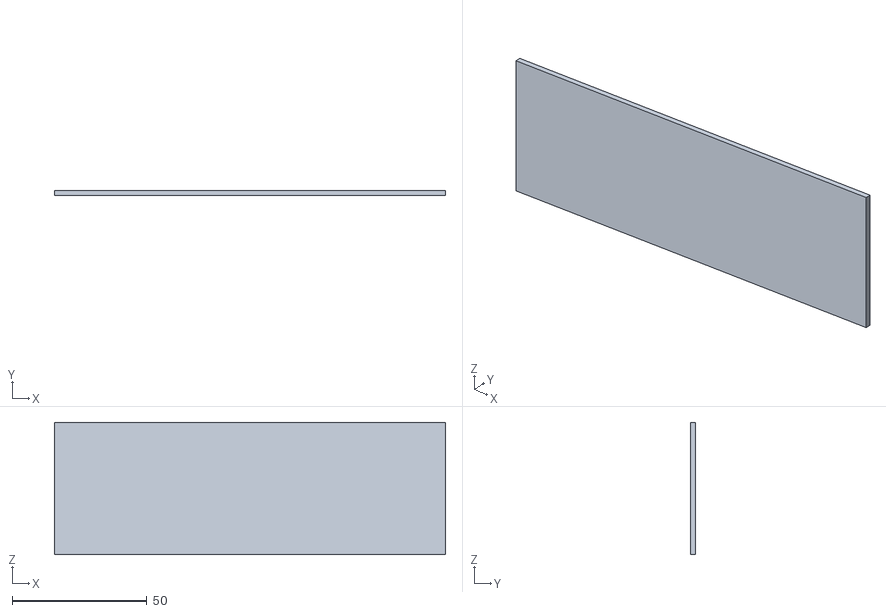
[picture p184: CAD file, 2026-10-23]
hardware/repeater_case/renders/stl/window_pc.stl
145.0 x 2.00 x 49.0
