Manas-36/MINESAFE/(list of files, cad)

Other CAD files:
hardware/repeater_case/renders/stl/mq136_h2s.stl
hardware/repeater_case/renders/stl/mq4_ch4.stl
hardware/repeater_case/case_base.stl
hardware/repeater_case/case_lid.stl
hardware/repeater_case/renders/stl/gland_nut.stl
hardware/repeater_case/renders/stl/vent_nut.stl
hardware/suit_cad/pods/boot_base.stl
hardware/suit_cad/pods/boot_lid.stl
hardware/suit_cad/pods/core_base.stl
hardware/suit_cad/pods/core_lid.stl
hardware/suit_cad/pods/cuff_base.stl
hardware/suit_cad/pods/cuff_lid.stl
hardware/suit_cad/pods/helmet_base.stl
hardware/suit_cad/pods/helmet_lid.stl
