Manas-36/MINESAFE/(list of files, drawings)

Other design files:
hardware/repeater_pcb/repeater.dsn
hardware/suit_pcb/boot/boot.dsn
hardware/suit_pcb/core/core.dsn
hardware/suit_pcb/cuff/cuff.dsn
hardware/suit_pcb/helmet/helmet.dsn
