Manas-36/MINESAFE/hardware/suit_pcb/boot/boot.kicad_pcb

## KiCad design hardware/suit_pcb/boot/boot.kicad_pcb (2026-10-24)

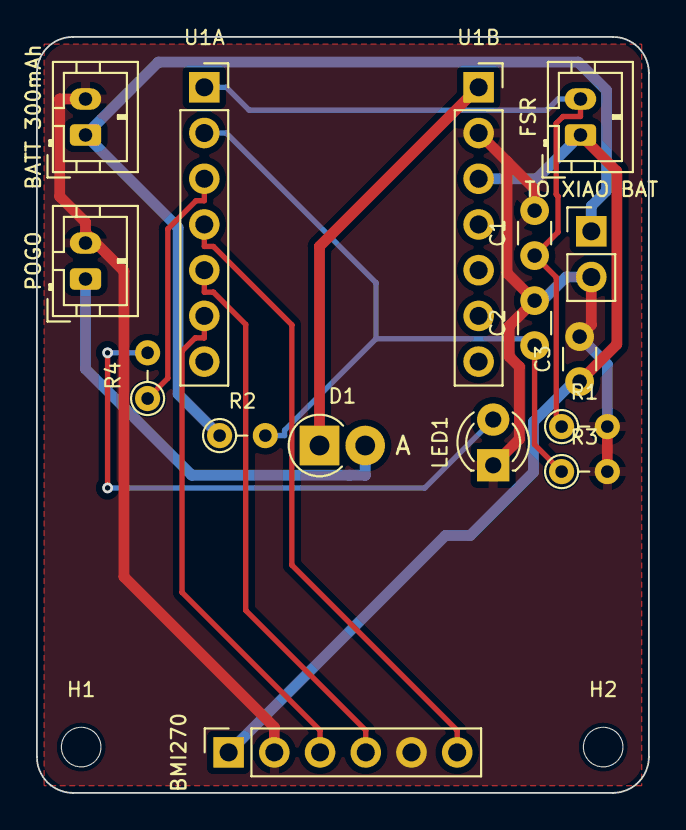
[picture p185: board boot.kicad_pcb from above]

Board: 2 copper layers, 34.0 x 42.0 mm, 18 parts (0 on the bottom side), 12 nets.

Parts:
C1, C2, C3: 100nF; C_Disc_D3.0mm_W1.6mm_P2.50mm
D1: 1N5819; D_DO-41_SOD81_P2.54mm_Vertical_AnodeUp
H1, H2: M2; MountingHole_2.2mm_M2
J1: BATT 300mAh; JST_PH_B2B-PH-K_1x02_P2.00mm_Vertical
J2: POGO; JST_PH_B2B-PH-K_1x02_P2.00mm_Vertical
J3: FSR; JST_PH_B2B-PH-K_1x02_P2.00mm_Vertical
J4: TO XIAO BAT; PinHeader_1x02_P2.54mm_Vertical
LED1: STATUS; LED_D3.0mm
R1: 10k; R_Axial_DIN0204_L3.6mm_D1.6mm_P2.54mm_Vertical
R2, R3: 220k; R_Axial_DIN0204_L3.6mm_D1.6mm_P2.54mm_Vertical
R4: 1k; R_Axial_DIN0204_L3.6mm_D1.6mm_P2.54mm_Vertical
U1A: XIAO D0-D6; PinSocket_1x07_P2.54mm_Vertical
U1B: XIAO 5V-D7; PinSocket_1x07_P2.54mm_Vertical
U2: BMI270; PinSocket_1x06_P2.54mm_Vertical

Connections:
+3V3: C3.1, J3.1, U1B.3, U2.1
+5V: D1.1, U1B.1
BAT+: J1.1, J4.1, R2.1
FSR: C1.1, J3.2, R1.1, U1A.1
GND: C1.2, C2.2, C3.2, J1.2, J2.2, J4.2, LED1.1, R1.2, R3.2, U1B.2, U2.2, U2.5
IMU_INT: U1A.4, U2.6
LED: R4.1, U1A.3
LED_A: LED1.2, R4.2
POGO+: D1.2, J2.1
SCL: U1A.6, U2.3
SDA: U1A.5, U2.4
VBAT_SNS: C2.1, R2.2, R3.1, U1A.2
