Manas-36/MINESAFE/hardware/suit_pcb/helmet/helmet.kicad_pcb

## KiCad design hardware/suit_pcb/helmet/helmet.kicad_pcb (2026-10-24)

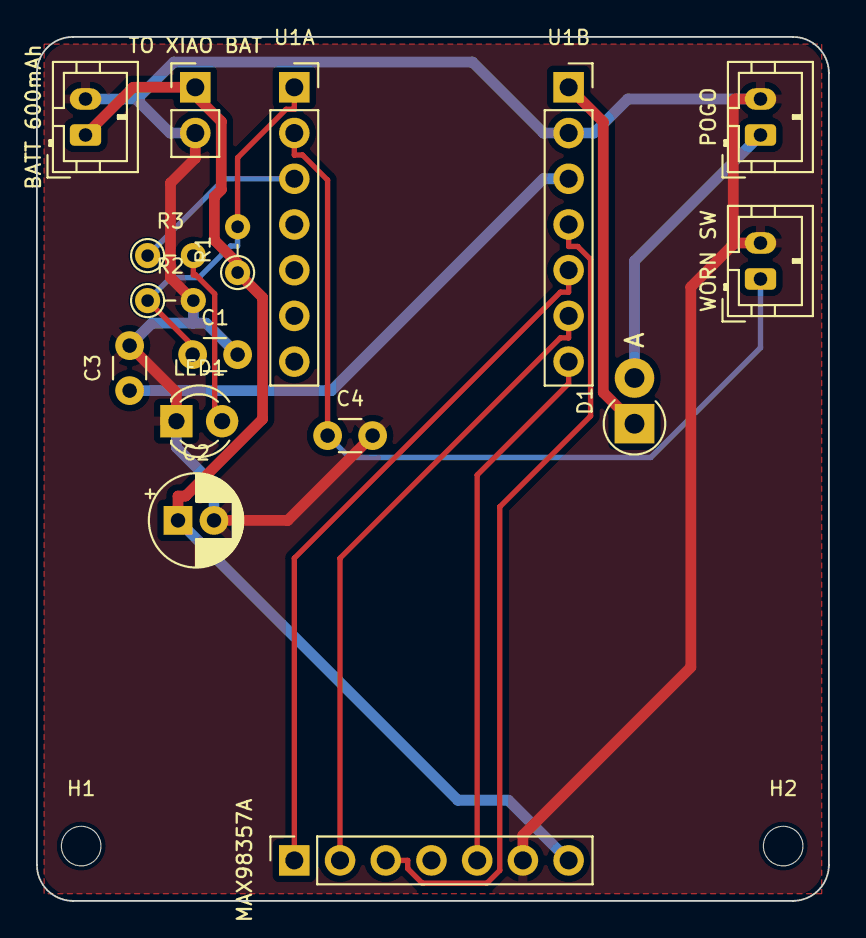
[picture p186: board helmet.kicad_pcb from above]

Board: 2 copper layers, 44.0 x 48.0 mm, 18 parts (0 on the bottom side), 13 nets.

Parts:
C1, C3, C4: 100nF; C_Disc_D3.0mm_W1.6mm_P2.50mm
C2: 100uF 10V; CP_Radial_D5.0mm_P2.00mm
D1: 1N5819; D_DO-41_SOD81_P2.54mm_Vertical_AnodeUp
H1, H2: M2; MountingHole_2.2mm_M2
J1: BATT 600mAh; JST_PH_B2B-PH-K_1x02_P2.00mm_Vertical
J2: TO XIAO BAT; PinHeader_1x02_P2.54mm_Vertical
J3: POGO; JST_PH_B2B-PH-K_1x02_P2.00mm_Vertical
J4: WORN SW; JST_PH_B2B-PH-K_1x02_P2.00mm_Vertical
LED1: STATUS; LED_D3.0mm
R1, R2: 220k; R_Axial_DIN0204_L3.6mm_D1.6mm_P2.54mm_Vertical
R3: 1k; R_Axial_DIN0204_L3.6mm_D1.6mm_P2.54mm_Vertical
U1A: XIAO D0-D6; PinSocket_1x07_P2.54mm_Vertical
U1B: XIAO 5V-D7; PinSocket_1x07_P2.54mm_Vertical
U2: MAX98357A; PinSocket_1x07_P2.54mm_Vertical

Connections:
+3V3: C3.1, U1B.3
+5V: D1.1, U1B.1
AMP_SD: U1B.7, U2.5
BAT+: C2.1, J1.1, J2.1, R1.1, U2.7
GND: C1.2, C2.2, C3.2, C4.2, J1.2, J2.2, J3.2, J4.2, LED1.1, R2.2, U1B.2, U2.6
I2S_BCLK: U1B.6, U2.2
I2S_DIN: U1B.4, U2.3
I2S_LRC: U1B.5, U2.1
LED: R3.1, U1A.3
LED_A: LED1.2, R3.2
POGO+: D1.2, J3.1
VBAT_SNS: C1.1, R1.2, R2.1, U1A.1
WORN: C4.1, J4.1, U1A.2
