Manas-36/MINESAFE/hardware/suit_pcb/cuff/cuff.kicad_pcb

## KiCad design hardware/suit_pcb/cuff/cuff.kicad_pcb (2026-10-24)

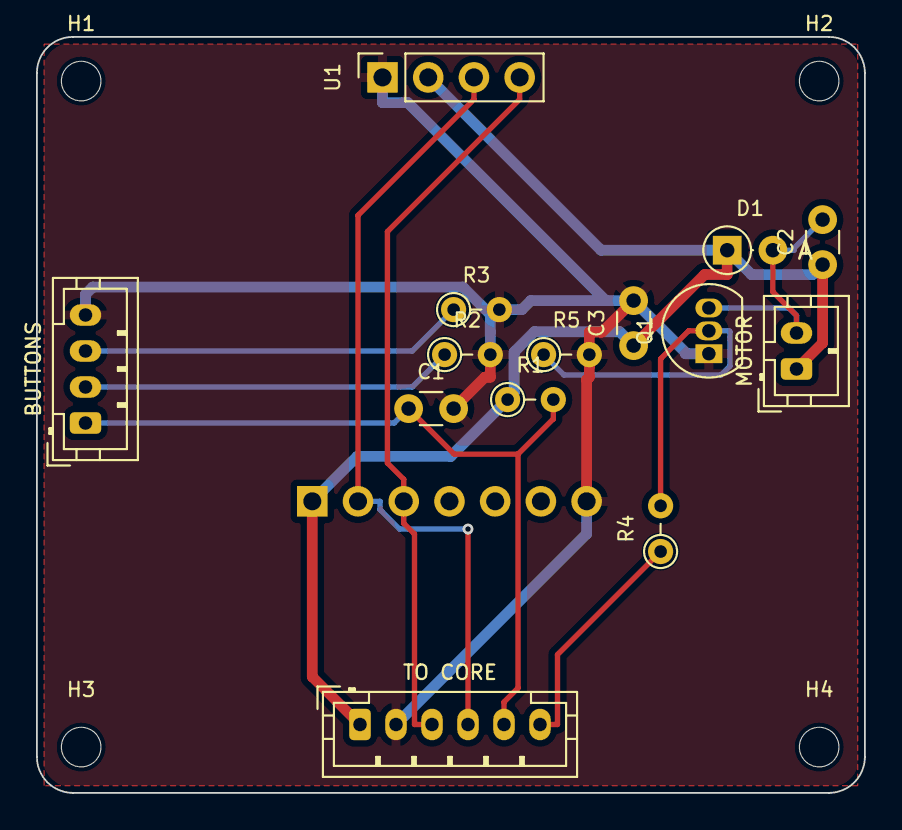
[picture p187: board cuff.kicad_pcb from above]

Board: 2 copper layers, 46.0 x 42.0 mm, 19 parts (1 on the bottom side), 10 nets.

Parts:
C1, C2, C3: 100nF; C_Disc_D3.0mm_W1.6mm_P2.50mm
D1: 1N4148; D_DO-35_SOD27_P2.54mm_Vertical_AnodeUp
H1, H2, H3, H4: M2; MountingHole_2.2mm_M2
J1: TO CORE; JST_PH_B6B-PH-K_1x06_P2.00mm_Vertical
J2: BUTTONS; JST_PH_B4B-PH-K_1x04_P2.00mm_Vertical
J3: MOTOR; JST_PH_B2B-PH-K_1x02_P2.00mm_Vertical
Q1: S8050; TO-92_Inline
R1, R5: 10k; R_Axial_DIN0204_L3.6mm_D1.6mm_P2.54mm_Vertical
R2: 2.2k; R_Axial_DIN0204_L3.6mm_D1.6mm_P2.54mm_Vertical
R3: 6.8k; R_Axial_DIN0204_L3.6mm_D1.6mm_P2.54mm_Vertical
R4: 1k; R_Axial_DIN0204_L3.6mm_D1.6mm_P2.54mm_Vertical
U1: OLED 1.3in; PinSocket_1x04_P2.54mm_Vertical
U2: MAX30102; PinSocket_1x07_P2.54mm_Vertical

Connections:
+3V3: C2.1, C3.1, D1.1, J1.1, J3.1, R1.1, U1.2, U2.1
BTN: C1.1, J1.5, J2.1, R1.2
GND: C1.2, C3.2, J1.2, J2.4, Q1.1, R2.2, R3.2, R5.2, U1.1, U2.7
HAPTIC: J1.6, R4.1
MENU_R: J2.3, R3.1
MOT_N: C2.2, D1.2, J3.2, Q1.3
OK_R: J2.2, R2.1
Q_B: Q1.2, R4.2, R5.1
SCL: J1.4, U1.3, U2.2
SDA: J1.3, U1.4, U2.3
