Manas-36/MINESAFE/hardware/suit_pcb/core/core.kicad_pcb

## KiCad design hardware/suit_pcb/core/core.kicad_pcb (2026-10-24)

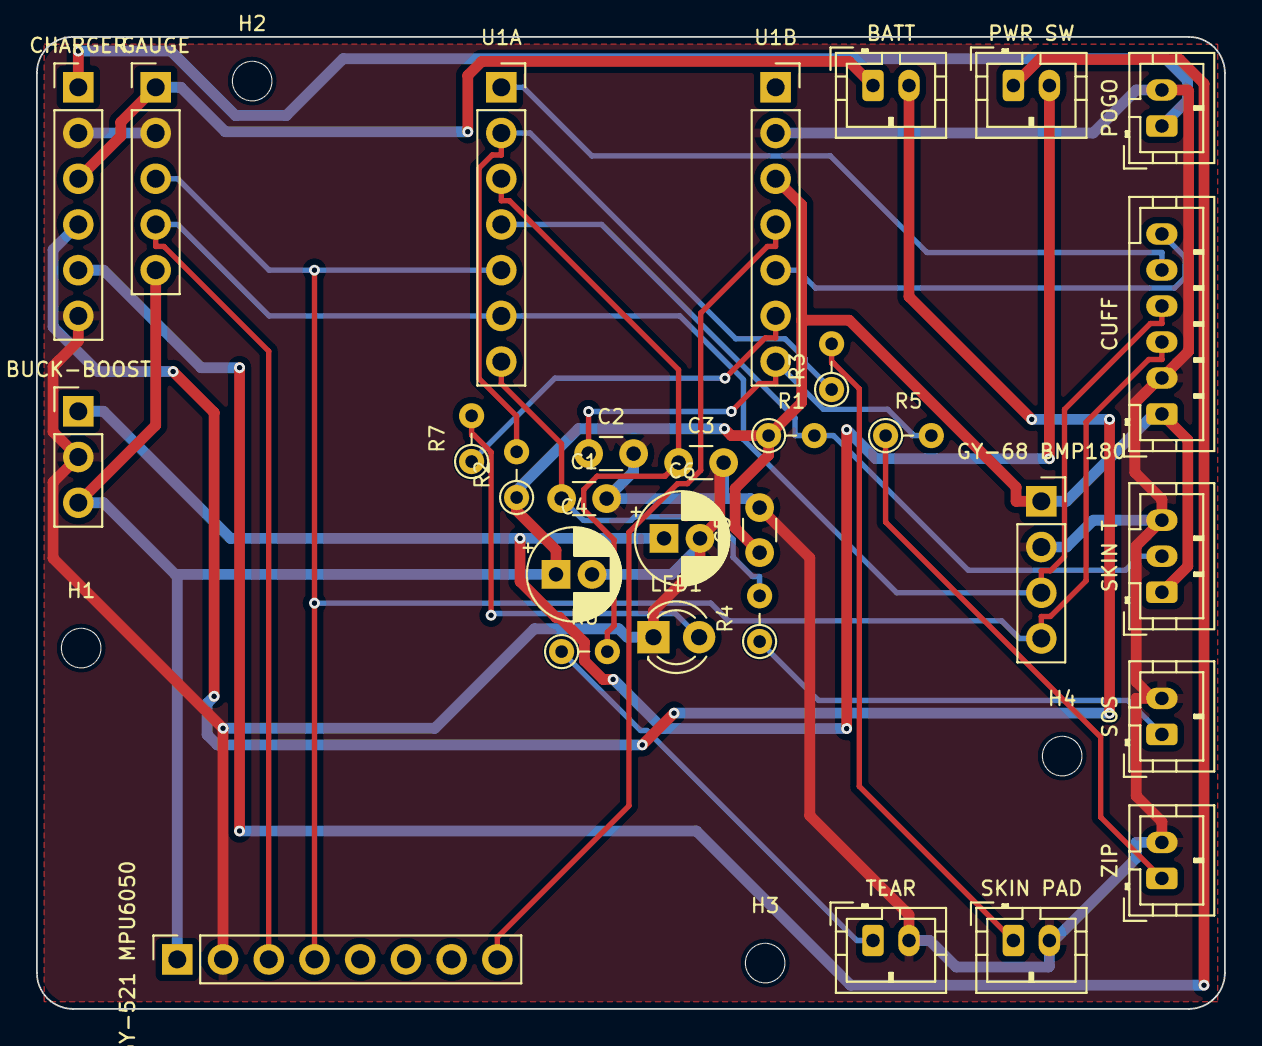
[picture p188: board core.kicad_pcb from above]

Board: 2 copper layers, 66.0 x 54.0 mm, 34 parts (0 on the bottom side), 23 nets.

Parts:
C1, C2, C3, C5: 100nF; C_Disc_D3.0mm_W1.6mm_P2.50mm
C4, C6: 100uF 10V; CP_Radial_D5.0mm_P2.00mm
H1, H2, H3, H4: M2; MountingHole_2.2mm_M2
J1: BATT; JST_PH_B2B-PH-K_1x02_P2.00mm_Vertical
J2: PWR SW; JST_PH_B2B-PH-K_1x02_P2.00mm_Vertical
J3: POGO; JST_PH_B2B-PH-K_1x02_P2.00mm_Vertical
J4: CUFF; JST_PH_B6B-PH-K_1x06_P2.00mm_Vertical
J5: SKIN T; JST_PH_B3B-PH-K_1x03_P2.00mm_Vertical
J6: SOS; JST_PH_B2B-PH-K_1x02_P2.00mm_Vertical
J7: ZIP; JST_PH_B2B-PH-K_1x02_P2.00mm_Vertical
J8: TEAR; JST_PH_B2B-PH-K_1x02_P2.00mm_Vertical
J9: SKIN PAD; JST_PH_B2B-PH-K_1x02_P2.00mm_Vertical
J10: CHARGER; PinHeader_1x06_P2.54mm_Vertical
J11: BUCK-BOOST; PinHeader_1x03_P2.54mm_Vertical
J12: GAUGE; PinHeader_1x05_P2.54mm_Vertical
LED1: STATUS; LED_D3.0mm
R1: 4.7k; R_Axial_DIN0204_L3.6mm_D1.6mm_P2.54mm_Vertical
R2: 1M; R_Axial_DIN0204_L3.6mm_D1.6mm_P2.54mm_Vertical
R3: 470; R_Axial_DIN0204_L3.6mm_D1.6mm_P2.54mm_Vertical
R4, R5, R6, R7: 1k; R_Axial_DIN0204_L3.6mm_D1.6mm_P2.54mm_Vertical
U1A: XIAO D0-D6; PinSocket_1x07_P2.54mm_Vertical
U1B: XIAO 5V-D7; PinSocket_1x07_P2.54mm_Vertical
U2: GY-521 MPU6050; PinSocket_1x08_P2.54mm_Vertical
U3: GY-68 BMP180; PinSocket_1x04_P2.54mm_Vertical

Connections:
+3V3: C4.1, C5.1, J4.1, J5.1, J11.3, J12.5, R1.1, R2.1, U1B.3, U2.1, U3.1
BAT+: J1.1, J10.3, J12.1
BAT_N: J1.2, J10.4
BTN: J4.5, U1A.1
CHG_OUT: J2.1, J10.5
GND: C1.2, C2.2, C3.2, C4.2, C5.2, C6.2, J3.2, J4.2, J5.3, J6.2, J7.2, J8.2, J9.2, J10.2, J10.6, J11.2, J12.2, LED1.1, U1B.2, U2.2, U3.2
HAPTIC: J4.6, U1B.5
IMU_INT: U1B.4, U2.8
LED: R7.1, U1B.6
LED_A: LED1.2, R7.2
ONEWIRE: J5.2, R1.2, U1A.4
POGO+: J3.1, J10.1
SCL: J4.4, J12.4, U1A.6, U2.3, U3.3
SDA: J4.3, J12.3, U1A.5, U2.4, U3.4
SKIN: R2.2, R3.1, U1A.2
SKIN_PAD: J9.1, R3.2
SOS: C1.1, R4.2, U1A.7
SOS_RAW: J6.1, R4.1
TEAR: C3.1, R6.2, U1A.3
TEAR_RAW: J8.1, R6.1
VSYS: C6.1, J2.2, J11.1
ZIP: C2.1, R5.2, U1B.7
ZIP_RAW: J7.1, R5.1
