Manas-36/MINESAFE/hardware/repeater_pcb/repeater.kicad_pcb

## KiCad design hardware/repeater_pcb/repeater.kicad_pcb (2026-10-23)

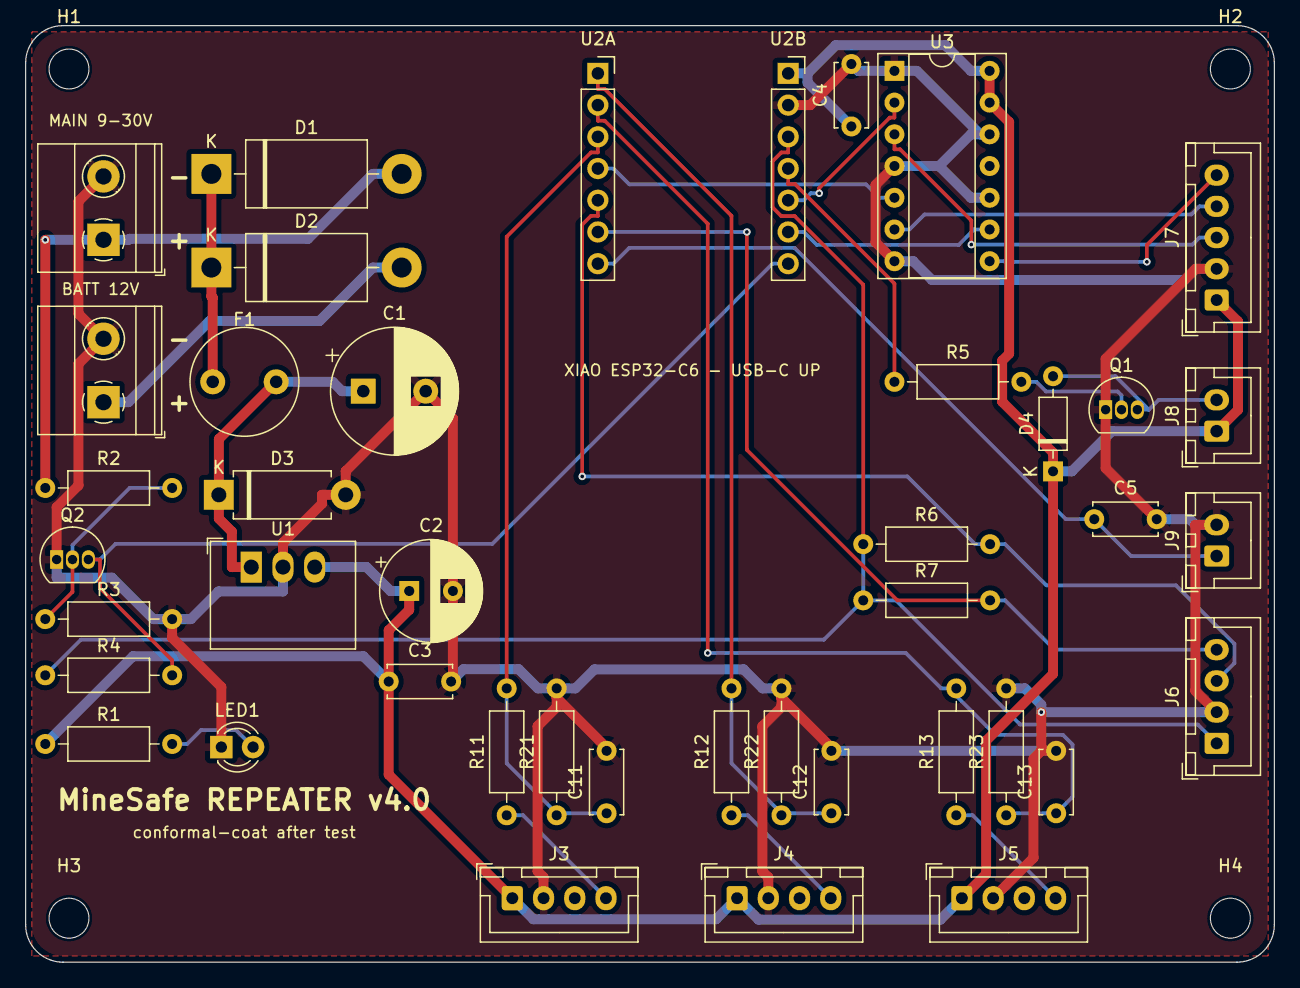
[picture p189: board repeater.kicad_pcb from above]

Board: 2 copper layers, 100.0 x 75.0 mm, 46 parts (0 on the bottom side), 28 nets.

Parts:
C1: 470uF 50V; CP_Radial_D10.0mm_P5.00mm
C2: 220uF 16V; CP_Radial_D8.0mm_P3.50mm
C3, C4, C5, C11, C12, C13: 100nF; C_Disc_D5.0mm_W2.5mm_P5.00mm
D1, D2: 1N5822; D_DO-201AD_P15.24mm_Horizontal
D3: P6KE36A; D_DO-15_P10.16mm_Horizontal
D4: 1N4148; D_DO-35_SOD27_P7.62mm_Horizontal
F1: T1.6A TR5; Fuse_Littelfuse_372_D8.50mm
H1, H2, H3, H4: M3; MountingHole_3.2mm_M3
J1: MAIN 9-30V; TerminalBlock_Phoenix_MKDS-1,5-2-5.08_1x02_P5.08mm_Horizont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
J2: BATT 12V; TerminalBlock_Phoenix_MKDS-1,5-2-5.08_1x02_P5.08mm_Horizont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
J3: MQ1; JST_XH_B4B-XH-A_1x04_P2.50mm_Vertical
J4: MQ2; JST_XH_B4B-XH-A_1x04_P2.50mm_Vertical
J5: MQ3; JST_XH_B4B-XH-A_1x04_P2.50mm_Vertical
J6: AHT20; JST_XH_B4B-XH-A_1x04_P2.50mm_Vertical
J7: MATRIX; JST_XH_B5B-XH-A_1x05_P2.50mm_Vertical
J8: BUZZER; JST_XH_B2B-XH-A_1x02_P2.50mm_Vertical
J9: SOS; JST_XH_B2B-XH-A_1x02_P2.50mm_Vertical
LED1: PWR; LED_D3.0mm
Q1, Q2: S8050; TO-92_Inline
R1, R5: 1k; R_Axial_DIN0207_L6.3mm_D2.5mm_P10.16mm_Horizontal
R2: 22k; R_Axial_DIN0207_L6.3mm_D2.5mm_P10.16mm_Horizontal
R3, R4, R11, R12, R13: 10k; R_Axial_DIN0207_L6.3mm_D2.5mm_P10.16mm_Horizontal
R6, R7: 4.7k; R_Axial_DIN0207_L6.3mm_D2.5mm_P10.16mm_Horizontal
R21, R22, R23: 20k; R_Axial_DIN0207_L6.3mm_D2.5mm_P10.16mm_Horizontal
U1: K7805-2000R3; Converter_DCDC_RECOM_R-78B-2.0_THT
U2A: XIAO D0-D6; PinSocket_1x07_P2.54mm_Vertical
U2B: XIAO 5V-D7; PinSocket_1x07_P2.54mm_Vertical
U3: 74HCT125; DIP-14_W7.62mm_Socket

Connections:
+3V3: J6.1, R4.1, R6.1, R7.1, U2B.3
+5V: C2.1, C3.1, C4.1, D4.1, J3.1, J4.1, J5.1, J7.1, J8.1, R1.1, U1.3, U2B.1, U3.13, U3.14
AO1: J3.4, R11.1
AO2: J4.4, R12.1
AO3: J5.4, R13.1
BUZ: R5.1, U2B.4
BUZ_N: D4.2, J8.2, Q1.3
CLK5: J7.5, U3.8
CS5: J7.4, U3.6
DIN5: J7.3, U3.3
GAS1: C11.1, R11.2, R21.1, U2A.3
GAS2: C12.1, R12.2, R22.1, U2A.1
GAS3: C13.1, R13.2, R23.1, U2A.2
GND: C1.2, C2.2, C3.2, C4.2, C5.2, C11.2, C12.2, C13.2, D3.2, J1.2, J2.2, J3.2, J4.2, J5.2, J6.2, J7.2, J9.2, LED1.1, Q1.1, Q2.1, R3.2, R21.2, R22.2, R23.2, U1.2, U2B.2, U3.1, U3.4, U3.7, U3.10, U3.12
LED_A: LED1.2, R1.2
MAINS_N: Q2.3, R4.2, U2B.7
MX_CLK: U2B.6, U3.9
MX_CS: U2A.4, U3.5
MX_DIN: U2B.5, U3.2
Q1_B: Q1.2, R5.2
Q2_B: Q2.2, R2.2, R3.1
SCL: J6.4, R7.2, U2A.6
SDA: J6.3, R6.2, U2A.5
SOS: C5.1, J9.1, U2A.7
VIN_BAT: D2.2, J2.1
VIN_MAIN: D1.2, J1.1, R2.1
VPROT: C1.1, D3.1, F1.2, U1.1
VRAIL: D1.1, D2.1, F1.1
