Manas-36/MINESAFE/firmware/entry_station/secrets.example.h

// Copy this file to secrets.h (same folder) and fill in your own values.
const char* WIFI_SSID  = "MINESAFE";
const char* WIFI_PASS  = "your-hotspot-password";
const char* ADMIN_URL  = "http://10.180.64.143:5000/api/gear";   // laptop IP running admin_hub.py
