Manas-36/MINESAFE/firmware/repeater_node/secrets.example.h

// Copy this file to secrets.h (same folder) and fill in your own values.
// secrets.h is listed in .gitignore, so it never goes to GitHub.
const char* WIFI_SSID = "MINESAFE";                                  // phone hotspot name (2.4 GHz)
const char* WIFI_PASS = "your-hotspot-password";
const char* HUB_URL   = "http://10.180.64.143:5000/api/telemetry";   // laptop IP running admin_hub.py
