Manas-36/MINESAFE/(commit log)

2026-10-03 v0.0: research, competitive analysis, architecture and pilot BOM
    Claude-Session: https://claude.ai/code/session_01PGMYLJZdJJDWKnHJD8ynzD
    [Total_System_BOM.xlsx, bom_pilot.csv]
2026-10-03 v1.0: structured repository, documentation, changelog and BOMs
    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
    [bom_prototype.csv]
2026-10-03 v0.6: tunnel map with GPS-free tracking, gas analysis, real body sensors, heart rate
    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
2026-10-03 v0.5: end-to-end chain working - phone worker, body unit v1, buzzer, hub auto-find
    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
    [body_node.ino, repeater_node.ino]
2026-10-03 v0.4: repeater chain, AI kit check, gas alerts; Zigbee replaced by ESP-NOW
    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
    [repeater_node.ino]
2026-10-04 v1.1-dev: wiring schematics for every unit; admin themed like the deck with MINESAFE splash
    - docs/wiring: system, body unit, repeater and entry station schematics
    (SVG + PNG), generated by make_schematics.py from the firmware pins
    - hub: dark/amber hazard-stripe theme (Oswald + IBM Plex), MINESAFE
    opening screen with Get started (Enter also works)
    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
2026-10-04 docs: roadmap update (38 / 56 done) - schematics and admin theme
    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
2026-10-04 docs: MineSafe logo; research reports, literature review, competitor analysis, pilot design
    - docs/images/logo*.png and README header
    - docs/research: literature.md (DGMS/ICMM/ILO figures, survey table,
    31-paper reading list), competitors.md (9-product matrix, gap,
    positioning), pilot_design.md (7 layers, entry-chamber logic, costs,
    planned vs built software), original reports in source/, diagrams
    - roadmap: 40 / 56 done
    Claude-Session: https://claude.ai/code/session_01PGMYLJZ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
    [Total_System_BOM.xlsx]
2026-10-04 docs: cover for incident case files page
    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
2026-10-04 docs: real mine accident case list with news sources
    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
2026-10-04 v1.1: camera entry station (XIAO ESP32-S3 Sense), mock worker, hub camera upload
    - entry_station v3: PHOTO button (D3), camera init for the XIAO S3 Sense,
    SVGA JPEG -> POST /api/camphoto, AI verdict on the OLED, hub auto-find;
    still builds for the XIAO C6 (no camera)
    - body_node: MOCK_MPU_ONLY mode + BF_NO_VITALS flag (ESP32-C6 + MPU6050 demo worker)
    - hub: /api/camphoto, shared ingest_photo(), no vitals warnings for mock units
    - schematics, wiring, setup, decisions (ESP-NOW now, Zigbee later), changelog, roadmap
    Builds checked: body_node (ESP32-S3, XIAO C6, C6 mock), entry_station (XIAO S3 Sense, XIAO C6).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
2026-10-04 docs: add CSIR-CIMFR wireless information and safety system papers
    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
2026-10-04 V3 (v3.0): release notes, flashing guide, version relabel
    - docs/v3.md: hardware set, flashing table, repeater/entry/mock wiring, entry flow, checks
    - CHANGELOG: major versions V1/V2/V3/V4; v1.1 -> V3 (v3.0)
    - README version badge V3, roadmap versions v3.0-v3.3, v4.0 final
    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
2026-10-04 docs: V1 and V2 version guides; major version table
    - docs/v1.md: Wi-Fi + cloud prototype, no website, lessons
    - docs/v2.md: ESP-NOW chain + control-room website (git v0.0-v1.0), lessons
    - CHANGELOG/README: V1 -> V2 -> V3 -> V4 table
    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
2026-10-04 v3.1: AHT air temperature + humidity on repeaters, shown in admin
    - repeater_node: AHT10/20/25 on I2C (XIAO C6 D4/D5, S3 GPIO8/9), own
    non-blocking driver; airT/airH appended to the repeater status and sent
    as air_t/air_h to the hub; phone page + Serial 'a' show it
    - admin_hub: per-repeater air history, wet-bulb (Stull), Air panel on
    Gas & air cards, Air column on Network, top-bar chip, heat incidents
    - sim_repeater: simulated air readings
    - repeater schematic, wiring/v3/protocol docs, changelog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
2026-10-04 docs: AHT sensor in system diagram and presentation notes
    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
2026-10-04 body_node: HW-827 pulse on GPIO4, alert LED moved to GPIO6 (ESP32-S3)
    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
2026-10-04 body_node: survive a loose I2C sensor (no error flood, auto-reconnect)
    A sensor that stops answering is reported once by name, no longer polled
    100x/s, and looked for again every 3 s after an I2C bus restart. ESP-IDF
    i2c.master error logging silenced in body and repeater firmware.
    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
    [body_node.ino, repeater_node.ino]
2026-10-04 body_node: MOCK_TEMP_ONLY mode (DS18B20-only demo worker), custom DS pin
    BODY-02 on an ESP32-C6 DevKit with the probe on GPIO10. New flag
    BF_NO_MOTION (512): hub shows the temperature, no motion-sensor warning.
    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
2026-10-04 body_node: I2C_SDA_CUSTOM / I2C_SCL_CUSTOM for other boards (C6-WROOM-1: 6/7)
    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
2026-10-04 body_node: PULSE_PIN_CUSTOM (with analog-pin check), HW-827 in MPU mock mode
    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
2026-10-04 Body unit on ESP32-C6-WROOM-1 DevKit + sensor and entry hardware tests
    - body_node: own pin map for the C6 DevKit (SDA 6, SCL 7, DS18B20 10, HW-827 2, button 18, LED 19)
    - tests/body_sensor_test: PASS/FAIL check of MPU6050, BMP180, MAX3010x, DS18B20, HW-827, button, LED
    - tests/entry_hw_test: XIAO S3 Sense PN532 + OLED + buttons + camera, live photo in the browser
    - wiring.md: C6 DevKit body unit table
    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
    [body_node.ino, body_sensor_test.ino, entry_hw_test.ino]
2026-10-04 body_node + body_sensor_test: print to both USB and UART sockets
    Serial Monitor now shows output whichever socket is used and whatever the
    USB CDC On Boot setting (was: only the ESP-ROM line on the C6 DevKit).
    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
2026-10-04 body_sensor_test: wire check (pull-up test) and 'f' pin finder
    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
2026-10-05 Status: V3 in calibration (sensor integration); V4 = our own PCBs and sensor boards
    - README: current status, new title, V3 calibrating / V4 PCBs badges, v3.2 row
    - CHANGELOG: v3.2 sensor integration entry, V4 redefined as custom PCBs
    - docs/v3.md: calibration checklist; docs/v4.md: PCB plan (draft)
    - ROADMAP timeline and decision 13 updated
    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
2026-10-05 Scanning system on ESP32-C6, body drivers cross-checked, library test
    - entry_station + entry_hw_test: ESP32-C6-WROOM-1 DevKit pin map (SDA 6, SCL 7, buttons 18/19/20),
    XIAO C6 kept, no camera on C6 -> phone photo page; serial on both USB sockets
    - tests/body_lib_test: body sensors read with standard libraries (cross-check)
    - BMP180 maths verified against the Bosch datasheet example; MPU, 1-Wire, MAX3010x checked
    - docs: wiring, README, CHANGELOG, v3 checklist
    Claude-Session: https://claude.ai/code/s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
2026-10-05 Scanning system: name the PN532 module (HW-147C), its DIP switch and header
    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
2026-10-07 v3.3: exit-sign repeaters, evacuation routes, editable gas limits
    - repeater: MAX7219 8x32 exit sign (arrow + distance), 3 MQ channels, SOS button,
    evacuation guide carried in beacons; v3.1 repeater frozen on version/v3.1-repeater-final
    - hub: Limits tab (CMR 2017 / NIOSH defaults), exits + danger zones on the map, Dijkstra
    routes per worker and per repeater sign, start/end/auto evacuation, multi-channel gas
    - simulator: 3 gas channels, methane event, guide echo
    - docs: gas limits, final BOM, Desktop run guide, wiring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
2026-10-11 Wiring schematics redrawn for current hardware
    Body unit on ESP32-C6 DevKit, repeater v3.3 (LED matrix, 3 MQ, SOS),
    scanning station on ESP32-C6 + HW-147C, system overview updated.
    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
2026-10-13 v3.4: OLED display and vibration motor on the body unit
    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
2026-10-23 V4 plan: smart suit architecture, sensor placement, BOM and build plan
    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
2026-10-23 v3.6: repeater PCB (KiCad, Gerbers, BOM) and mine-rated case (CadQuery STEP/STL)
    - hardware/repeater_pcb: XIAO ESP32-C6 carrier, 100x75 mm 2-layer, dual supply with
    diode OR + fuse + TVS, 5V/2A switcher, mains-present on D7, 74HCT125, 3 MQ inputs;
    autorouted, DRC 0 unconnected, JLCPCB Gerber zip, schematic, BOM
    - hardware/repeater_case: IP65 gasketed base + lid, drip hood, CH4 top chimney,
    CO/H2S bottom ports with flame-arrestor seats, AHT20 chamber, battery bay,
    gland, vent, guarded SOS, SMA, rock-bolt tabs; fit check passes
    - hardware/README.md: mine conditions -> design answers, ordering, printing
    Claude-Session: https://cla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
2026-10-23 Shopping list for 2 repeaters (PCB v4.0 + case)
    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
2026-10-23 Repeater prototype wiring diagram (PCB v4.0 harness) + shopping list extras
    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
2026-10-24 v3.7: V4 smart suit - 4 pod PCBs, pod enclosures, full-suit CAD, wiring
    - hardware/suit_pcb: core, cuff, helmet, boot carrier boards (THT, hand-solderable),
    routed 100%, DRC 0 unconnected, JLCPCB Gerber zips, BOMs, renders
    - hardware/pcbgen.py: shared place/route/DRC/Gerber generator with retry
    - hardware/suit_cad: CadQuery pod enclosures (STEP/STL) checked against the real
    boards; suit assembly on a mannequin with harness, seam loop, zip/skin/heel sensors
    - docs/wiring/suit_v4_wiring.png, hardware/suit.md, CHANGELOG, v4.md links
    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
2026-10-25 Avishkar deck with native PowerPoint 3D models, GLB exports, Times New Roman technical document
    - presentation/avishkar: anonymous 13-slide deck (pptxgenjs) + add_3d_models.py (am3d model3d,
    structure per OfficeCLI / MS-ODRAWXML) embedding 7 rotatable GLB models with render fallbacks
    - hardware/make_glb.py + hardware/glb: coloured Y-up GLB models (repeater, 4 pods, smart suit)
    - presentation/avishkar/report: Word technical document (Times New Roman, cover, contents,
    figures, equations, styled tables) built from the Docs export
    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
2026-10-26 Avishkar: 1 m poster and deck in the official convention format (anonymous)
    - poster/build_poster.js: 1 m x 1 m poster (Annexure 1 header), 12 sections with native charts, tables, architecture and shift flowcharts, callout renders; PPTX + print PDF
    - build_deck.js: white framed slides with convention / category / level / slot on every slide, 14 slides, new charts (deaths, repeater power, suit cost), component-selection and validation tables, 7 native 3D models kept
    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
2026-10-26 Phone body unit that talks straight to the hub (/mock), no repeater needed
    - hub/phone_body.html: phone acts as a body unit - steps + heading (phone sensors or Walk/turn buttons), vitals sliders, SOS hold, fall, no-movement; shows hub alerts and evacuation, vibrates
    - admin_hub.py: GET /mock, POST /api/mockbody (same raw packet as a repeater forwards), extra https port 5443 so phones allow motion sensors
    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
