Manas-36/MINESAFE/(notices)

Notices in the files:
README.md:
License: MIT
